yoyojacky/microduck-replica/tools/FeeTech_HD1910M_Servo/README.md

# HD1910M 舵机测试工具（feetech-HD1910M-tester）

基于 Rust 实现的飞特 HD1910M 串口舵机（FT-SCS 协议）测试工具，
覆盖官方内存表全部可读写寄存器：ID/波特率设置、位置/速度/电流三环 PID、
扭矩与力控、运行模式、保护参数、EPROM 锁存、实时监控等。

## 快速开始

```bash
cargo build
./target/debug/hd1910-tester scan      # 扫描舵机（带进度条）
./target/debug/hd1910-tester dump      # 读整张内存表
./target/debug/hd1910-tester monitor   # 实时监控反馈
./target/debug/hd1910-tester --help    # 全部命令
```

## 文档

完整的中文教学手册（协议讲解 + Rust 知识点 + 实验教程）见 **[TUTORIAL.md](TUTORIAL.md)**。

## 附带的两份飞特规格书

| 文件 | 是什么 | 跟鸭子的关系 |
|---|---|---|
| [`HD-1910-C001串型规格书20260907.pdf`](HD-1910-C001串型规格书20260907.pdf) | **本项目用的舵机**。4–8.4 V，减速比 1:320，堵转 15 kg·cm @7.4 V。过压保护阈值 10 V、欠压 4 V，所以 2S 电池满电 8.4 V 在范围内 | ✅ 整只鸭子 15 颗都是它 |
| [`HL-2915-C002串型规格书20260227.pdf`](HL-2915-C002串型规格书20260227.pdf) | 飞特另一款舵机。**9–14 V（3S 电池）**，22.5 g，减速比 1:320 | ⚠️ **本项目不用，仅供参考**。电压跟鸭子的 2S 电池不兼容，想换 3S 方案时可以对照看 |

两份都是飞特发的规格书原件，规格内容一字未改。**联系人的姓名和手机号/微信已抹掉**
（原件里印的是销售个人的联系方式，不适合挂在公开仓库）；HD-1910 那份用的是联系方式为公司座机的官方版本。
要联系飞特走官网 [www.feetech.cn](https://www.feetech.cn) 或公司电话 0755-89335266。

飞特的协议手册、内存表等官网公开资料在仓库的 [`docs/飞特资料/`](../../docs/飞特资料/)。

## 测试

```bash
cargo test    # 协议层/内存表层单元测试（无需硬件）
```
