yoyojacky/microduck-replica/hardware/imu_to_dxl/imu_to_dxl-接线表.md

# imu_to_dxl 接线表

> 手工连线用。器件位号与 `microduck-replica/BOM.md` 一致。
> 状态：方案稿，未经实物验证。

## 器件清单（含立创编号）

| 位号 | 器件 | 封装 | 立创编号 |
|---|---|---|---|
| U1 | STM32G031F8P6 | TSSOP-20 | C529334 |
| U2 | LSM6DSV16XTR | LGA-14 | C5267406 |
| U3 | SN74LVC2G241DCUR | VSSOP-8 | C10430 |
| U4 | HT7533-1（30V 输入，100mA） | SOT-89 | C14289 |
| F1 | PPTC MF-NSMF020X-2（24V / 200mA 保持） | 1206 | C210358 |
| D1 | TVS SMF12A | SOD-123FL | C2943870 |
| R1, R2, R4, R5 | 10kΩ | **0603** | C25804 |
| R6 | 150Ω | **0603** | C22808 |
| D2 | BZT52C5V1 5.1V 稳压管 | **SOD-123** | C151588 |
| C1–C4, C8 | 100nF 50V | **0603** | C14663 |
| C5 | 4.7µF / 16V X5R | 0603 | C19666 |
| C6 | 10µF / 25V X5R | 0805 | C15850 |
| C7 | 10µF / 10V | 0603 | C19702 |
| J1, J2 | B3B-EH-A（3P **2.5mm**，Dynamixel / 官方 HAT 线） | 直插 | C160259 |
| **J4, J5** | **B3B-PH-K-S（3P 2.0mm 立式，对口飞特 `AMP2.0-3P`）** | 直插 | 待定 |
| J3 | SWD+串口 6P 排针 PZ254V-11-06P | 直插 | C492405 |

## 网络表（23 个网络）

### VDD_BUS —— 舵机总线原压（2S 锂电 6.0–8.4V）
J1.2 · J2.2 · **J4.2** · **J5.2** · F1.1

> 四个座子的 `VDD_BUS` 走**直通铜皮**：`J1.2 → J2.2 → J5.2 → J4.2` 全程 0.76 mm。

### VDD_F —— 保险丝之后
F1.2 · D1 阴极 · C6.1 · C8.1 · U4.2 (Vin)

### +3V3
U4.3 (Vout) · C7.1 · U1.4 (VDD/VDDA) · C4.1 · C5.1 · R2.2 ·
U2.5 (Vdd_IO) · U2.8 (Vdd) · C1.1 · C2.1 · R1.2 ·
U3.8 (VCC) · C3.1 · J3.6 · **R7.2**

### GND
D1 阳极 · C6.2 · C8.2 · U4.1 (GND) · C7.2 ·
U1.5 (VSS/VSSA) · C4.2 · C5.2 ·
U2.2 (SDx) · U2.3 (SCx) · U2.6 (GND) · U2.7 (GND) · C1.2 · C2.2 ·
U3.4 (GND) · C3.2 · J1.1 · J2.1 · J3.1 · **J4.3** · **J5.3** · C9.2 · X1.2

### 复位
| 网络 | 连接点 |
|---|---|
| NRST | U1.6 (PF2-NRST) · R2.1 |

R2 另一端 (R2.2) 接 +3V3，构成 10k 上拉。

### 四个上拉电阻（R1/R2/R4/R5，另一端全部接 +3V3）

| 位号 | 拉住谁 | 为什么 |
|---|---|---|
| **R1** | `SPI_CS` | 上电与复位期间 PA4 高阻，CS 浮着可能被 IMU 误判成 I²C 模式，或把总线噪声当命令。**必须** |
| **R2** | `NRST` | 芯片内部已有 ~40 kΩ 弱上拉，外加 10 kΩ 提高抗干扰。加强项 |
| **R4** | `DE` | `1OE#` **低电平使能发送**。复位期间 PA1 高阻，此脚若浮成低电平，发送缓冲打开，本板会往总线上灌数据、与 15 个舵机撞车。**必须** |
| **R5** | `DXL_DATA` | 总线空闲无人驱动时，`2A` 这个 CMOS 输入浮空会有穿透电流，UART 也可能把噪声当起始位。本板自己定义空闲电平，不依赖主机 |

> R4 与 R5 是 2026-09-06 按社区评审意见补的。此前只在 CS 上做了上拉，
> **同样的道理没有推广到 DE，这是漏项**。

### IMU（SPI 四线 + 两路中断）
| 网络 | U1 (STM32) | U2 (LSM6DSV16X) | 其他 |
|---|---|---|---|
| SPI_CS | 11 · PA4 | 12 · CS | R1.1（R1.2 接 +3V3 上拉） |
| SPI_SCK  | 12 · PA5 | 13 · SCL | |
| SPI_MISO | 13 · PA6 | 1 · SDO/SA0 | |
| SPI_MOSI | 14 · PA7 | 14 · SDA | |
| IMU_INT1 | 7 · PA0  | 4 · INT1 | |
| IMU_INT2 | 15 · PB0/PA8 | 9 · INT2  | |

### 半双工总线（U3 = SN74LVC2G241 双缓冲）
| 网络 | 连接点 |
|---|---|
| MCU_TX | U1.9 (PA2 · USART2_TX) · U3.2 (1A) |
| MCU_RX | U1.10 (PA3 · USART2_RX) · U3.3 (2Y) |
| DE | U1.8 (PA1 · USART2_DE) · U3.1 (1OE#) · **R4.1** |
| DXL_DATA | U3.6 (1Y) · U3.5 (2A) · **R5.1** · **R6.1** —— 缓冲侧 |
| **DXL_BUS** | **R6.2** · **D2 阴极** · J1.3 · J2.3 · **J4.1** · **J5.1** —— 连接器侧 |
| **RX_EN** | **U1.1 (PB7/PB8)** · **U3.7 (2OE)** · **R7.1** —— 接收缓冲使能，2026-09-07 补 |

`U3.7 (2OE)` 原为直接接 +3V3，2026-09-07 改成 **`RX_EN` 网络**：经 **R7 10 kΩ 上拉到
+3V3**，同时引一根线到 **U1.1 (PB7/PB8)**。

**默认行为不变** —— MCU 复位期间 PB7 是高阻，R7 把 `2OE` 拉高，接收缓冲照常开着，
固件一行不写也跟改动前完全一样。这是**预留**：想关掉发送期间的回显时，把 PB7 配成
推挽输出拉低即可，同时打开 `MCU_RX` 脚的内部上拉，避免 `2Y` 高阻时 RX 浮空。

### 调试口 J3（6P，`PZ254V-11-06P` / `C492405`）

| 脚 | 网络 | 来源 |
|---|---|---|
| 1 | GND | |
| 2 | SWDCLK | U1.19 (PA14) |
| 3 | SWDIO | U1.18 (PA13) |
| 4 | **UART_RX** | **U1.17** `PA12[PA10]` → 重映射为 **PA10** = `USART1_RX`；接 USB-TTL TX（3.3V电平） |
| 5 | **UART_TX** | **U1.16** `PA11[PA9]` → 重映射为 **PA9** = `USART1_TX`；接 USB-TTL RX（3.3V电平） |
| 6 | +3V3 | 调试器 VTref 电压参考；不要接5V |

**2026-09-21 勘误：** 按本目录2026-09-08[原理图 PDF](imu_to_dxl-原理图.pdf)复核，
SWD接 **1、2、3、6** 脚；第4/5脚是串口。旧四针排线不能整排插到1–4脚，
不能把第4脚当作3.3V或VTref。连接前核对实板一脚标记和调试器接口定义。

脚 16/17 的重映射靠 `SYSCFG_CFGR1`（DS12992 Rev 3, Table 12 脚注 4）。

**为什么不上 USB**：STM32G031 **没有 USB 外设**（手册全文搜 USB 零命中，Development support
只写 "serial wire debug (SWD)"）。加 USB 要额外一颗 CH340/CP2102，45×22 mm 板上不划算。
调试用 SWD 就够：

| 方式 | 需要什么 | 说明 |
|---|---|---|
| **RTT**（推荐） | J3 的 1、2、3、6 脚 | `probe-rs` 支持 CMSIS-DAP 跑 RTT，直接读目标 RAM，**不停 CPU**，对 50 Hz 控制环无影响 |
| 串口 printf | J3 的 4/5 脚 + 任意 USB-TTL | 走 USART1 |
| 半主机 semihosting | 只用 J3 | 每次 printf 停 CPU，控制环会崩，**别用** |
| ~~SWO / ITM~~ | — | **Cortex-M0+ 没有**，M3 以上才有 |

### 舵机接口 —— 两套并存，⚠️ **脚序是相反的**

板上有四个舵机总线座子，两两一组，三根线一一并联（同一个电气节点），
**但两组的引脚顺序完全相反** —— 因为两家的线序本来就不同。

**`J1` / `J2` —— `B3B-EH-A`，2.5 mm，配 Dynamixel / 官方 HAT 线束**

| 脚 | 网络 |
|---|---|
| 1 | GND |
| 2 | VDD_BUS |
| 3 | **DXL_BUS** |

**`J4` / `J5` —— `B3B-PH-K-S`，2.0 mm，配飞特 HD-1910 线束**

| 脚 | 网络 |
|---|---|
| 1 | **DXL_BUS** |
| 2 | VDD_BUS |
| 3 | **GND** |

> ⚠️ **千万别照着 `J1` 复制网络给 `J4`。** 飞特《HD-1910-C001 串型规格书》A/0
> 第 3/7 页 6-7 项写明线端是 `1=Signal / 2=Vcc / 3=GND`，与 Dynamixel 侧头尾颠倒。
> 好在 **2.0 mm 与 2.5 mm 插不进对方**，物理上杜绝了插错，只剩「画错」这一种可能。
> 四个座子的脚序已于 2026-09-08 从 PCB 网表反读复核，全部落对。
>
> 另注意 **`AMP2.0` 是 2.0 mm、`JST EH` 是 2.5 mm**，飞特线插不进 `J1`/`J2`，
> ⚠️ 首板实测（2026-09-17）：`B3B-PH-K-S` 的**外壳**跟飞特插头不配，插不进去；削掉外壳只留针能用。v2 换成跟飞特线实配的座子。
> 反之亦然 —— 用哪套舵机就插哪一组。

> 📌 **脚 3 此前本表误记为 `DXL_DATA`**。2026-09-06 补入 `R6` 150 Ω 串阻后，
> 缓冲侧（`DXL_DATA`）与连接器侧（`DXL_BUS`）已是两个网络，连接器上是 `DXL_BUS`。
> 2026-09-08 更正。

## 悬空脚

- U1：**3 (PC15-OSC32_OUT)、20 (PB3/PB4/PB5/PB6)**
  - 3 脚已引到焊盘，与 2 脚一起构成有源晶振预留位（默认不贴），见下方「时钟」
  - 20 脚是唯一完全空闲的 GPIO（并了 PB3/PB4/PB5/PB6 四个口，最灵活），留作后用
  - 1 脚 (PB7/PB8) 原本空闲，2026-09-07 起用作 `RX_EN`
  - 2 脚 (PC14-OSC32_IN) 接 `OSC_IN`、16/17 脚 (PA9/PA10) 接 `UART_TX`/`UART_RX`
    —— 此前本表误列为悬空，2026-09-07 更正
- U2：10 (OCS_Aux)、11 (SDO_Aux) —— 辅助 SPI 不用，ST DS13510 允许悬空；保守做法是 OCS_Aux 接 Vdd_IO

**U2.2 (SDx) 与 U2.3 (SCx) 必须接地**，不可悬空 —— ST DS13510 Rev 1, Table 1。

## 时钟：用内部 HSI16，晶振位预留不贴

**这个封装接不了无源晶振。** DS12992 Rev 3, Table 12 (p.36)：TSSOP20 的 2 脚
(`PC14-OSC32_IN`) 附加功能含 `OSC_IN`，但 3 脚 (`PC15-OSC32_OUT`) 只有 `OSC32_OUT`、
**没有 `OSC_OUT`**；`PF0`/`PF1` 在这个封装根本没引出来。无源晶振要两个脚才能起振。

| 方案 | 可行性 |
|---|---|
| 无源高速晶振 | ❌ 缺 `OSC_OUT` |
| 有源晶振走 HSE 旁路（灌进 2 脚，3 脚可作 `OSC_EN`） | ✅ |
| 32.768 kHz LSE 无源晶振 | ✅ 但不能给 PLL 供时钟，只能校准 HSI16 |

HSI16 精度（Table 41, p.64）：出厂 −0.75%/+0.5%，0–85 °C 温漂 ±1%，电压漂移 ±0.1%
→ 最坏约 **−1.85% / +1.55%**。1 Mbps UART 典型容差 ±3%，够用但余量不多。

**做法**：2、3 脚引到焊盘，留一个 3225 有源晶振位 + 去耦位。最初默认不贴，2026-09-08 起 X1 / R3 / C9 改为默认贴片；
固件先用 HSI16，实测 1 Mbps 有误码再启用 HSE 旁路。
注意：图里 X1 的 `Tri-state` 使能脚是**固定接 3.3 V** 的，上面说的「3 脚（PC15）可作 `OSC_EN`」没有画进去，PC15 空着。首板要 MCU 控晶振就飞线 PC15 → X1.1；见 README「评审记录 · 2026-09-16」。

## 使能极性说明

`1OE#` 低电平使能发送缓冲，`2OE` 接高电平使接收缓冲常开。

- PA1 是 USART2 的硬件 DE 脚，配置 `CR3.DEP = 1`（DE 低有效），收发切换由硬件完成
- 接收常开意味着发送时会在 RX 上收到自己的回显，固件按发送长度丢弃即可
- 备选方案是 `2OE` 也接 DE（发送时关掉接收缓冲），但那样发送期间 MCU 的 RX 脚悬空，重新使能时可能产生假起始位，不推荐
- **2026-09-07 改进**：`2OE` 不再硬接 +3V3，而是经 R7 10 kΩ 上拉、同时引到 `U1.1 (PB7/PB8)`。
  默认仍是常开（行为不变），但固件多了一个选项 —— 想关接收时拉低 PB7，并打开 MCU RX 脚的
  内部上拉解决浮空。比接 DE 更灵活：关不关、何时关，由固件自己定

## HD-1910-C001 实参（飞特官方产品页，预售期）

飞特为小鸭子专门做的一颗，页面标题即「**开源小鸭舵机** —— 串行总线舵机，专为小鸭子 AI 玩偶定制开发」。
舵机本体标注：**「三针接口 · TTL串行总线」**。

| 项 | 值 |
|---|---|
| 电压范围 | **5 V – 8.4 V** |
| 堵转扭力 | **10 kg·cm = 0.98 N·m** |
| 额定负载 | **3.0 kg·cm = 0.294 N·m** |
| 空载速度 | 0.09 s/60°（110 RPM） |
| **静态电流** | **21 mA** |
| **空载电流** | **140 mA** |
| **额定电流** | **500 mA** |
| **堵转电流** | **1.8 A** |
| 外观尺寸 | 34 × 20 × 23 mm |
| 重量 | 22.5 ± 2 g |
| 外壳 | PA + Fiber |

尺寸与 XL330（20×34×26 mm）同档，机械上近似可替换；扭矩比 XL330-M288（0.52 N·m）强近一倍。

> ⚠️ 别把 `HL-2915-C002` 规格书里的电气参数套到这颗上 —— 那是 12 V（9–14 V）机型。
> 可通用的只有连接器定义与协议部分。

### ⚠️ J1↔J2 直通路径的过流

J1 / J2 三根线一一并联，**本板若挂在链条中间，下游全部舵机电流都流经本板的连接器与铜箔**：

| 工况 | 单个 | ×15 |
|---|---|---|
| 静态 | 21 mA | 0.3 A |
| 空载转动 | 140 mA | 2.1 A |
| **额定负载** | **500 mA** | **7.5 A** |
| 堵转 | 1.8 A | 27 A |

而 **JST EH 额定电流仅 3 A**。

> F1（200 mA PPTC）**不受影响** —— 它只串在本板自取电那一路
> （`VDD_BUS → F1 → VDD_F → U4`），不在 J1→J2 直通路径上。

**二选一：**

1. **把本板挂在链条末端**（叶子节点），只用 J1，J2 空置或只接 1 个舵机 —— 流经本板的仅约 12 mA。**推荐**
2. 若必须置于链中，PCB 上 `VDD_BUS` 与 `GND` 从 J1 到 J2 走**大铜皮**（≥ 2 mm 或直接铺铜），
   并核算下游舵机数量不超过 3 A

## 飞特接口定义（官方规格书确认）

**来源**：飞特《HL-2915-C002 串型规格书》A/0，2026-02-27，第 4 页 6-7 项。

```
6-7  连接器和电缆 Connector and Cable
     类型 Type        AMP-3
     材质 Material    PP
     线长 Length      15CM / 25CM
     引脚定义         1  GND
     Pin Definition   2  Vcc
                      3  Signal/TTL
```

**`1=GND / 2=Vcc / 3=Signal`，与 Dynamixel 完全一致 → J1/J2 现有接法正确。**

关联证据：`HD-1910-C001.stp` 装配体里连接器零件名是 **`AMP-3P`**，且该装配体包含
`HL-2915-C002-20260409_ASM` —— 两款共用平台，接口定义通用。

### 同一份规格书里其它可用条目

| 项 | 值 | 意义 |
|---|---|---|
| 7-2 协议类型 | Half Duplex Asynchronous，**8bit / 1stop / No Parity** | 与本板一致 |
| 7-4 波特率 | 38400 ~ 1 Mbps，**出厂默认 1 Mbps** | 与 Dynamixel 同速 |
| 7-3 ID 范围 | 0–253，**出厂默认 ID 1** | 15 个舵机需逐个改 ID；本板用 200 不冲突 |
| 12 **信号高电平** | **2 V ~ 5 V** | 见下 |
| 12 信号低电平 | 0.0 V ~ 0.45 V | |
| 6-6 角度传感器 | 12 Bits 磁编码 | 磁编码 ⇒ **小端字节序** |

**信号电平两个方向都要看**：

1. 本板驱动总线 —— `SN74LVC2G241` 在 3.3 V 供电下输出约 3.3 V，落在舵机要求的 2–5 V 高电平窗口内 ✅
2. 舵机驱动总线 —— 它可能输出到 **5 V**；74LVC 在 3.3 V 供电时**输入耐 5.5 V** ✅
   （选 LVC 而非 LV/HC 正好卡住这条）

> ⚠️ 该规格书是 **HL-2915-C002（12 V，9–14 V）**，不是 HD-1910（5–8.4 V）。
> **电气参数不可混用** —— 供电范围、堵转电流、过压保护阈值都不同。
> 通用的只是**连接器定义与协议**部分。

### 背景：飞特不同系列的物理层不一样

官方各系列内存表手册（<http://doc.feetech.cn>，接口 `getQr/{q}`）原文：

| 系列 | 电平 | 默认波特率 |
|---|---|---|
| **STS**（磁编码） | **TTL 单总线** | **1M** |
| SCS（电位器） | TTL 单总线 | 1M / 500k |
| SMS（磁编码） | **RS485** | 115200 |
| HLS（磁编码） | 未注明 | 1M |
| SHC | CANopen | 125k |

「飞特 = TTL 单线」**只对 STS/SCS/HL 这一支成立**，SMS 是 RS485。换系列前先查它的手册。

## 协议自动识别（不用跳线、不用拨码）

两家包头天然可分，判别点是**第 3、4 字节**：

| | 包头 | 后续 | 校验 |
|---|---|---|---|
| Dynamixel V2 | `FF FF` | **`FD 00`** | CRC-16（poly 0x8005） |
| 飞特 STS/SCS | `FF FF` | `ID` + `LENGTH` | `~(ID+LENGTH+INST+参数)` |

无歧义：飞特包第 3 字节是 ID（可以是 0xFD），但**第 4 字节 LENGTH 永远不会是 0**
（最小为 2 = 指令 + 校验和）。所以 `FF FF FD 00` 只可能是 V2。

```
状态：未知 / 已锁 V1 / 已锁 V2

未知时，收到 FF FF 开头的包：
    if 字节[2]==0xFD && 字节[3]==0x00:
        按 V2 拆，算 CRC-16 → 过了记一票 V2
    else:
        按 V1 拆，算 ~sum   → 过了记一票 V1
    连续 3 票一致 → 锁定

锁定后：只按锁定协议解析，回复也用同一种
兜底：连续 100 包全解析失败 → 解锁重新识别
```

以下均以**飞特官方《舵机SCS通信协议》原文**为准：

- 帧格式：**1 起始位 + 8 数据位 + 无校验 + 1 停止位**，共 10 位
- 字头：连续两个 `0xFF`
- ID 范围 **0～253**（`0x00`～`0xFD`），**广播 ID = 254（`0xFE`）**
- 数据长度 **Length = 参数个数 N + 2**，所以**最小为 2，永远不会是 0** ← 判别无歧义的依据
- 校验和 = `~(ID + Length + Instruction + Param1 + … + ParamN)`，超 255 取低字节
- 同步读 `0x82`、同步写 `0x83`、PING `0x01`、读 `0x02`、写 `0x03`
- ⚠️ **多字节参数的字节序按舵机类型分**：「电位器类型舵机为**大端**（高字节在前），磁编码类型舵机为**小端**（低字节在前）」

三个要点：

1. **必须锁定，不能逐包判** —— 总线有噪声，某包被干扰成 `FD 00` 的样子会导致来回横跳
2. **回复用同一协议** —— 不只解析要分支，组包也要
3. **兜底解锁** —— 换舵机品牌时不必重烧固件

从机 ID 两边都用 **200**，与 15 个舵机（通常编 1–15）不冲突。

> 飞特 STS 的 `Return Delay Time` 默认 0，且手册标注 "Not functional on STS" ——
> 寄存器不生效，回复延迟完全由固件决定。

## 封装口径：阻容一律 0603

所有阻容用 **0603**，D2 用 **SOD-123**，不用 0402/SOD-323。

理由不是手焊 —— 板上有 LGA-14 的 LSM6DSV16X，本来就得上热风。
**真正的理由是调试期返修**：串阻从 150 Ω 试到 33 Ω、摘掉某个上拉、补一颗去耦，
0603 拿烙铁几秒就能改。第一版没验证过的板子必然要改几次。

代价：11 个器件多占约 16 mm²，不到板面积 2%。而且 0603 这几个值全在立创**基础库**
（10 kΩ `C25804` · 150 Ω `C22808` · 33 Ω `C23140` · 100 nF `C14663`），比 0402 的扩展库还省上料费。

> C6（10 µF/25 V）保持 0805；C5（4.7 µF）、C7（10 µF）本来就是 0603。

## 数据线保护（照 HAT 的做法）

```
U3.6 (1Y) ──┬─ DXL_DATA ─┬── R5 10k → 3.3V
U3.5 (2A) ──┘            │
                         └── R6 150Ω ──┬── DXL_BUS ── J1.3 / J2.3
                                       │
                                    D2 5V1
                                       ⏚
```

| 器件 | 作用 |
|---|---|
| **R6 150 Ω** | 源端串阻。限制短路电流、软化边沿降 EMI。1 Mbps 下延迟约占比特时间 3% |
| **D2 5V1** | 钳位。阴极接 `DXL_BUS`、阳极接地 |

**上拉留在缓冲侧**（R5 在 R6 之前）：这样即使不插总线，`U3.5 (2A)` 这个 CMOS 输入
也有确定电平，不会浮空。与 HAT 的 `R32` 位置一致。

> 官方 HAT 用的是 `R33 150R + TH1 100R` 串联共 250 Ω，外加 `D4 5V1` 钳位
> （`dynamixel.kicad_sch`）。**D2 与 HAT 的 D4 同型号、不同封装** —— HAT 是 SOD-323（`C151348`），本板用 SOD-123（`C151588`）便于返修。
> 本板只用 150 Ω，因为 HAT 侧已有 250 Ω，总线上串太多会拖慢边沿。

## 三道过压防线

1. **F1** PPTC 200mA 保持 / 24V —— 限流，防短路
2. **D1** TVS SMF12A —— 钳位，防舵机反电动势尖峰
3. **U4** HT7533-1 耐压 30V —— 即使前两道失效，LDO 本身扛得住

## 布局要点

- 2 层板，45 × 22mm，贴片件全在正面
- 3 个连接器（J1/J2/J3）排在同一条边，插件
- 两个 M2 安装孔，间距 34mm（与原版 `banana_pcb_locker` 兼容）
- C1/C2 紧贴 U2 的 Vdd / Vdd_IO 脚，走线尽量短
- C4（100nF）与 C5（4.7µF）紧贴 U1 的 4 脚 —— ST DS12992 Fig.13 要求"尽可能贴近引脚，或放在 PCB 背面正对该脚"
- DXL_DATA 走线加粗，远离 SPI
