yoyojacky/microduck-replica/docs/HD1910-20261013-夜-掉电-舵机D与蹭地.md

# 2026-10-13 夜 ～ 10-14 凌晨 · 新卡上机、整机掉电、舵机 D 与颤、蹭地分析

**机器**：第一台（飞特 HD-1910 ×15，Radxa Zero 3W 2G 无 eMMC + microSD，官方 HAT C1 版，BNO085 走 I²C）。供电是 8.2 V 可调电源。
**两张卡**：
- **旧卡**：我们自己做的 Armbian，跑 kissqy 的 R17（v146）加我们的 I²C IMU 补丁，10-12 夜就是用它走起来的；
- **新卡**：kissqy 的一键镜像 R1（V164）加我们的 IMU 补丁（`microduck-zero3w-0.15.1-R1-V112-imu.img`）。

**走路模型**：kissqy 的「行走＋倒地联合 9600 轮」（§5～§7 的数据都是旧卡跑的）。
**前情**：[10-12 夜上机记录](HD1910-20261012-夜-IMU校准与首次迈步.md)，IMU 校准后能站、能交替迈步，但走路发颤、蹭地。

**一句话结论**：
1. **整机掉电是供电问题，不是软件**：新卡、旧卡都掉过，录像和日志同时中断、没有关机过程；新卡那次舵机端最后读到约 3.9 V。
2. **走路发颤跟舵机的 D（硬件阻尼）有关**：训练用的舵机模型里没有 D 这一项，真机却带着 D=20 或 D=40。D 改成 0 之后，机身晃动里的高频颤从 51% 降到 4～8%。我们现在用的是 **P3 / D0 / 转矩限制 700**。
3. **蹭地是两只脚都只抬了仿真的一半**：撑地的膝盖伸不直，模型要伸，真机一直弯着。左脚看起来更蹭，是因为它迈步时脚尖朝下；这一点和「右腿撑地时机身多往前栽」都是 **D 改成 0 以后才出现的**（D=20 时没有）。IMU 横滚零点补过了；关节零位在前后方向左右一致，左右方向（横滚）两只脚算出来差约 1.6°～2.6°，原因还没查（§6）。**补充（10-14 白天）**：左右不共面查了，差别来自两个髋横滚往外劈，每次不一样，像是被体重压的（推测）；仿真对齐真机的动作缩放、滤波，重量按 kissqy 训练模型估以后，撑地膝盖已经接近真机（那组仿真会颤）。见 [10-14 白天记录](HD1910-20261014-白天-仿真找原因与新版放开参数.md)。

| | 现在的状态 |
|---|---|
| 用哪张卡 | 旧卡（R17 能设 P/D/转矩）；新卡留着，等供电解决再用 |
| 舵机参数 | P3 / D0 / 转矩限制 700（中控「高级参数」里设，下次 HOME 生效） |
| IMU | 10-12 补了前倾 8.54°、右倾 1.78°；10-14 横滚往回补 1.14°（§6） |
| 走路 | 步频 2.8～2.9 Hz（仿真 3.2 Hz）；机身横滚晃动 30～36°/s，跟仿真 31°/s 一样；没有高频颤 |
| 还没解决 | 蹭地（两脚离地 3～6 mm，仿真 11～12 mm）；供电（10 A 电源 10-16 到） |

---

## 0. 问题一览

| # | 现象 | 根因 | 处理 | 详见 |
|---|---|---|---|---|
| 1 | 新卡 G50 Pro 配对成功，几秒后就被断开 | 这张卡开机时蓝牙「不可绑定」，配对回 No Bonding，BlueZ 默认 `ClassicBondedOnly=true` 拒收没绑定的 HID 设备；官方 setup-board 设的 `UserspaceHID=false` 有没有参与，没验证 | 配对前 `btmgmt bondable on`，配完立刻 connect；当时还改了 `UserspaceHID=true`、`ClassicBondedOnly=false`。几项一起改，只成功过一次 | §1.2 |
| 2 | 新旧卡都会在走路、站起时整机掉电 | 供电撑不住舵机的电流冲击（新卡那次舵机端最后读到约 3.9 V） | 电池或 10 A 电源、粗短线、输入端并大电容 | §2 |
| 3 | 在 `robotd.toml` 里改缩放、滤波，前后对比白做 | 联合模型用它自己包里的 `deployment-execution.json`，toml 里的这几个值对它不生效 | 改联合模型的执行参数（§4.1） | §4 |
| 4 | 新卡中控里改 P/D/转矩限制，没有效果 | V164 只写 P（模型包里约定的 P=5，kissqy 叫「部署合同」），D 和转矩限制留在舵机出厂值（D=40、1000），R17 的测试参数功能被删了 | 用旧卡；或者每次上电后写舵机 RAM（§4.2）；10-14 在本地给 V164 补回了（未上机，[10-14 §8](HD1910-20261014-白天-仿真找原因与新版放开参数.md#8-新版v164放开-p--d--转矩限制和头腿滤波本地未上机)） | §4 |
| 5 | 走路发颤、4 Hz 小碎步、节奏乱 | 跟舵机硬件 D 有关（训练用的舵机模型里没有 D）；D=0 后颤明显减少，机理没证实 | D=0，P3（代价见 §7） | §5 |
| 6 | 机身一直往左歪约 2° | 一部分是 P3 太软、站着时腿被压；另一部分是 IMU 横滚零点偏约 1.1° | IMU 横滚往回补 1.14° | §6 |
| 7 | 走路蹭地，左脚尤其明显 | 撑地膝盖伸不直，两脚都只抬了仿真一半；D=0 以后左脚迈步时脚尖朝下 | 待查，先试中间的 D（§7.5）；10-14 的仿真对照见 [10-14 §2](HD1910-20261014-白天-仿真找原因与新版放开参数.md#2-对齐条件以后撑地膝盖接近了但仿真多出了颤) | §7 |

---

## 1. 新卡上机

### 1.1 开机、配网

- V1.12 主板换成瑞莎的引导以后，**真机开机成功**（做法见 [kissqy 镜像 R1 分析](HD1910-20261012-kissqy镜像R1分析.md)）。
- 第一次开机，鸭子自己开热点。用电脑无线网卡连上热点，打开配网页填家里的 WiFi。**配网页要求登录密码至少 12 位**，短了会被拒。
- 新卡用 NetworkManager 管 WiFi（旧卡是 wpa_supplicant），登录用户是 `radxa`。

### 1.2 G50 Pro 配对上又被断开

**现象**：手柄拨 S 档，`bluetoothctl pair` 显示成功，几秒后就断开，padd 读不到手柄。旧卡上同一个手柄没问题。

**原因**（没有拆开逐项验证）：
1. 我们这张卡开机时蓝牙是「不可绑定」（bondable off，为什么没查清），手柄配对回的是 **No Bonding**，密钥存不下；BlueZ 的 `ClassicBondedOnly=true`（默认值）只接受已绑定的 HID 设备，于是连上就被拒；
2. 官方 `scripts/setup-board.sh` **有意**把 `/etc/bluetooth/input.conf` 里的 `UserspaceHID` 设成 `false`：Pro Controller 每秒发约 200 包，经 bluetoothd（蓝牙后台服务）转一道要吃掉一个核约 16% 的 CPU，改走内核后是 0（官方实测，配对和重连都不受影响）。kissqy 的镜像沿用了这一步。它在这次问题里有没有参与，**没验证**。

**做法**：
- `/etc/bluetooth/input.conf`：`UserspaceHID=true`、`ClassicBondedOnly=false`（原件备份成 `.bak-20261013`），重启 bluetooth。**这两项和 bondable 是一起改的，哪一项是必需的没拆开试**。按官方的测量，`UserspaceHID=true` 会让 bluetoothd 多吃约 16% 的 CPU，主板本来就热，下次应先试「只开 bondable、保留官方的 `UserspaceHID=false`」；
- 配对顺序：`btmgmt bondable on` → `bluetoothctl pair <MAC>` → `trust <MAC>` → **马上** `connect <MAC>`。成功后能看到 `Nintendo Switch Pro Controller` 和 `hid_nintendo` 驱动；
- 我们用 duck-quiet 把 kissqy 的 `configd` 关着，重新配对前要先 `systemctl start configd`。

新卡上按这个流程配上过一次（之后就碰到了 §1.3 的 WiFi 掉线和 §2 的掉电）。后来又重配了两次没配上，原因没查完就换回了旧卡，**这条流程还要在新卡上再完整走一次**。

### 1.3 其他改动（都能撤销）

| 改了什么 | 为什么 |
|---|---|
| WiFi 改连 5G，NetworkManager 里两个 WiFi 连接配置都关掉 PMF（受保护的管理帧） | 新卡上手柄连上约 10 秒后 WiFi 掉线（`ssid-not-found`，信号 −19 dBm，不是信号弱）。旧卡的 WiFi 设置就是关 PMF。改完没有单独复测 |
| 看门狗 15 秒、`kernel.panic=5`、`panic_on_oops=1` | 万一系统卡死，15 秒左右自己重启，不用拔电；重启后看 `/sys/fs/pstore` 有没有内核死机日志 |
| 黑匣子：`duck-rec`（50 Hz 状态＋每 0.5 秒电压温度）、`duck-journal`（系统日志实时抄到卡上） | Armbian 的日志在内存里，一掉电就没了。改成每秒写盘一次，文件名带开机编号（主板没有 RTC，时钟每次开机都会回拨，按时间找不到文件）。脚本见 [`tools/radxa/onboard-analysis/`](../tools/radxa/onboard-analysis/) |

---

## 2. 整机掉电：是供电，不是软件

**现象**：走路或站起来时，整只鸭子突然断电重启。录像、系统日志、健康记录在同一时刻中断，**没有任何关机过程**。新卡、旧卡都出现过：
- 新卡（P5 / D40 / 转矩 1000，V164，开着声音，联合缩放 1.0）：模型接管后走了 13 秒掉电，最后一刻舵机读到约 **3.9 V**；
- 旧卡（P5 / D20 / 转矩 1000）：模型接管 42 秒，中间摔倒、自己起身一次（日志 `LB recovery started`），起身后约 11 秒断电，断电时摇杆是 0。健康记录最后一个点是 7.33 V（每 0.5 秒才一个点，跌落那一下没录到）。

**原因**：舵机一起发力时的电流冲击，电源和线撑不住，电压塌下去。主板的 5 V 是 HAT 从同一路电降压出来的，跟着掉电。D 越大，模型纠正越频繁，电流冲击可能越多；新卡掉得更快**可能**跟 D=40 有关，但这只是一次对一次，新卡还同时开着声音（功放也吃这路电），下不了结论。

**电压的另外几个数**：10-13 下午那次开机（`bc840bb`），上力站着中位 7.45 V、走路 7.39 V，连站着都只有 7.45 V（电源设 8.2 V），原因没查；之后几次开机站着、走路都在 7.9～8.1 V，10-14 凌晨走路中位 8.00 V、最低 7.93 V。robotd 报的电压每 0.5～1 秒才一个点，还做了平滑，几十毫秒的瞬间跌落看不到。

**怎么办**：
- 用电池（放电倍率够的航模电池，充满），或者大电流电源（我们的 10 A 电源 10-16 到）；
- 线用 16～18 AWG 硅胶线，尽量短，接头用 XT30 / XT60，不用鳄鱼夹；
- 鸭子电源输入端并一个 1000～2200 µF 的电解电容；
- 想分清是「主电源塌了」还是「HAT 给主板供电那一路太弱」：主板的 USB-C 另接一个充电宝单独供电再走（HAT 上有 LM5050 理想二极管，按设计允许这样接）。有示波器的话，下降沿触发，同时看 BATT_IN、5V_PRE_IDEAL、主板 5V 三个点。

**更正一件事**：kissqy 仓库里曾有一段「走几步 ZERO 会重启，疑 HAT 上 LM5050 的 VS 供电余量不足」，**他 10-12 已经删掉了**，提交说明是「作者更正，早先测试不准确」。别把它当成 kissqy 的结论。我们 C1 版 HAT 的 BOM 确实是同一套（R8 100Ω、U10 LM5050-1、U9 AP63205），但我们这次的证据指向主电源。

---

## 3. 新旧卡比一比

新卡掉电以后，我们用只读的 ext4 读取器（电脑上管理员运行，`wsl --mount` 挂不上 USB 读卡器）把旧卡读出来，逐项对比：

| | 旧卡 | 新卡 |
|---|---|---|
| 内核、设备树、aic8800 WiFi/蓝牙驱动和固件 | 99 个文件完全一样 | ← |
| bluez、wpa_supplicant 版本 | 一样 | ← |
| WiFi 管理 | wpa_supplicant，2.4G 优先、PMF 关、`country=CN`、静态 IP | NetworkManager |
| 设备树 overlay | — | 比旧卡多了 i2c3-pihat、aic3104（声卡）、摄像头、NPU |
| robotd / padd | kissqy R17 | kissqy V164 |
| 舵机参数 | 中控能设 P / D / 转矩限制 | 只写 P=5（§4.2） |
| 声音 | 关 | 开（`[audio] enabled = true`），HAT 上的功放和舵机用同一路电 |

所以掉电跟卡无关（两张卡都掉）。G50 Pro 只记得最后配对的那张卡，**换卡要重新配对**。走路表现不同，主要是 robotd 版本不同、舵机 D 不同。

---

## 4. 参数到底在哪生效（今晚最大的坑）

### 4.1 联合模型的缩放和滤波：在模型包里，不在 robotd.toml

**现象**：我们在 `robotd.toml` 里把 `action_scale` 改成 1.0、0.8，头腿滤波改成 0.5、1.0，跑了几组对比。后来发现这几组对比**都白做了**，当时得出的结论也是错的，已经更正。

**原因**：kissqy 的联合模型（`scale_use = joint_uniform`）带着自己的 `deployment-execution.json`。R17 装的版本是缩放 0.9、头滤波 0.5、腿滤波 0.7（kissqy 10-12 之后发布的 V164 里，同一个模型写的是缩放 1.0、头 0.5、腿 0.7），robotd 再乘一个电压补偿（约 7.4 / 电压，8 V 时约 0.92）。**toml 里的 `action_scale` 和滤波对联合模型不生效**，只对其他模型生效。

**怎么确认生效**：看 robotd 的 `robot.busStatus` → `loaded_models.walk.runtime_execution_profile`，那里是 robotd 实际在用的值。中控「高级参数」页「联合基础缩放 0.90」那一格也是从这里读的。

**要改的话**：改模型目录里那个 `deployment-execution.json` 的三个数，卸力后重启 robotd。我们在本地给 kissqy 中控加了「联合缩放 / 头部滤波 / 腿部滤波」三个输入框，能做这件事（§8），还没发布。补充（10-14）：后来改在 V164 上做，见 [10-14 白天记录 §8](HD1910-20261014-白天-仿真找原因与新版放开参数.md#8-新版v164放开-p--d--转矩限制和头腿滤波本地未上机)。

### 4.2 舵机的 P / D / 转矩限制：R17 能设，V164 不能

先看舵机本身。HD-1910 出厂 EEPROM 里是 **P=32、D=40、I=0**，转矩限制 1000，加速度 0。读法：robotd 的 `robot.busStatus` → `native.hd1910.registers_before_arm`。

| | 上力时写什么 | 中控「高级参数」的 P / D / 转矩框 |
|---|---|---|
| R17（旧卡） | 默认写 P=5、D=20；`/etc/robot/feetech-ft5/servo-test-parameters.json` 里有值就用它 | **生效**，下次 HOME 上力时写入 |
| V164（新卡） | 只写 P（模型合同里的 `kp_fw=5`），**D 和转矩限制不写**，留在出厂的 D=40、1000 | **不生效**。kissqy 的说明里写了「48–49 号转矩限制、51 号 D 不显式写入」，R17 的测试参数分支也删了 |

**补充（10-14 晚）**：kissqy 10-14 发布 V167 / control.43（中控 1.0.167），说明是「修复鸭身抖动」：每次 HOME 上力，把 15 颗舵机 RAM 里的 D 写成 0、转矩限制写成 1000，P 仍用模型里的 5；这两个值是固定的，中控里调不了；卸力时只恢复 P，D 留在 0，直到舵机断电。跟本页 §5 的结论一致。

**新卡上的临时办法**：robotd 停掉、15 颗卸力后，直接写舵机 **RAM** 里的 D（51 号）和转矩限制（48 号）。RAM 断电就恢复，EEPROM 不动。我们用一个小脚本写成了 D=0、转矩 681。注意：**手柄十字键右（重启舵机）也会把 RAM 恢复成出厂值**。长期要么把这个设置补回 V164，要么把 15 颗舵机 EEPROM 里的 D 改成 0（只对不写 D 的 V164 有效；R17 上力时会写自己的 D，要配合测试参数里的 kd）。**补充（10-14）**：补回 V164 的代码已在本地写好（P / D / 转矩限制和头腿滤波都能在中控里设，未上机、不公开），见 [10-14 白天记录 §8](HD1910-20261014-白天-仿真找原因与新版放开参数.md#8-新版v164放开-p--d--转矩限制和头腿滤波本地未上机)。

---

## 5. 走路发颤：跟舵机的 D 有关

### 5.1 怎么找到的

1. 训练用的舵机模型（BAM：舵机的物理模型，含电机和各种摩擦；参数是陆吾公开的 1910 M6，就是这款舵机；`kp_fw=5` 指舵机固件里的 P=5）**没有硬件 D 这一项**（kissqy 的审计文档也这么写）；真机却是 D=20（R17）或 D=40（V164）。D 是舵机里的微分项，起阻尼作用，动得越快阻得越狠；
2. 用走路数据算「目标 → 实际」的跟随（Welch 互谱：把模型每拍给的目标当输入、舵机实际角度当输出，算每个频率上能跟到几成）。P5 / D20 那段录像（`run-20261013-135146-b3409a0`）在步频附近 3～4 Hz：髋、膝跟到 0.33～0.46，跟仿真的 0.41～0.48 差不多；明显差的只有踝（0.36～0.39，仿真 0.69）。另一段只有 21 秒的录像（`132505-b70520d`）算出来是 0.26～0.45；
3. **假设**：模型以为腿是灵活的，真机的阻尼吃掉一部分纠正动作，模型只好更快、更用力地反复纠正，于是出现 4 Hz 的小碎步加颤。但 D 改成 0 以后（P5 / D0 / 850），髋横滚跟随 0.27～0.28、膝 0.35～0.36，并没有变好，只有踝升到 0.53。**这个机理没被数据证实**。

能确定的是下面这张表里的实测结果：D 改成 0，颤明显减少。

### 5.2 几组参数对比（每组走 8～42 秒）

同一只鸭子、旧卡、联合模型、联合缩放 0.9 不变。脚本 [`tools/gait-analysis/`](../tools/gait-analysis/) 的 `gait_quality.py`（步频、晃动）和 `foot_clear.py`（离地间隙，§7）：

| 组 | 走了 | 步频 | 机身横滚晃动 | 其中 >4 Hz（颤） | 平均左右倾 | 迈步离地间隙 左 / 右 |
|---|---|---|---|---|---|---|
| 仿真（训练用舵机模型，P5） | 19.8 s | 3.22 Hz | 31°/s | 14% | −1.1° | 11.4 / 11.8 mm |
| P5 / D20 / 1000 | 42.3 s | 2.89 Hz，节奏乱 | 33°/s | **51%** | −1.9° | 6.9 / 6.5 mm\* |
| P5 / D0 / 850 | 13.0 s | 3.47 Hz | **56°/s** | 6% | −1.5° | 5.5 / 8.5 mm\* |
| P3 / D0 / 681 | 22.8 s | 2.91 Hz | **30°/s** | 8% | −2.4° | 2.2 / 6.5 mm\* |
| P3 / D0 / 681（第二次） | 8.2 s | 2.80 Hz | 36°/s | 4% | −1.8° | 3.1 / 5.9 mm\* |
| P4 / D0 / 681，IMU 已补左右 | 12.0 s | 3.01 Hz | 44°/s | 6% | −0.8° | 4.8 / 5.8 mm |

\* IMU 横滚补偿（§6）之前录的。那时 IMU 多读了约 1.1° 左倾，换算到地面时左脚被算低约 2 mm：左脚的数偏小、右脚的数偏大，大约各 2 mm；左右分段也有偏差（算成左腿撑地的时间偏多）。P4 那组最干净。

**注意这不是严格的「一次只改一样」**：P5 / D20 / 1000 → P5 / D0 / 850 同时改了 D 和转矩限制；P5 那组转矩是 850，P3、P4 是 681；P4 那组还同时补了 IMU。

**读法**：
- D=20 时，机身晃动里一半是 4 Hz 以上的颤；**D 改成 0（同时转矩 1000 → 850），颤从 51% 降到 4～8%**；
- D=0 以后，P 越大晃得越厉害：P5 晃 56°/s，P4 晃 44°/s，P3 晃 30°/s，跟仿真一样（转矩限制和 IMU 不完全相同，见上）；
- 我们的手感也是 P3 最稳。kissqy 中控的默认值也正好是 P3 / D0 / 681；
- 代价是 P 越小，离地越低（§7）；
- **D=20 也有好处**：撑地时右膝能伸到 +1.6°（D=0 时是 −2.6°～−5.3°），机身也不前后点头（§7.3、§7.4）。所以 D=0 不一定最好，中间值 D=5～10 值得试。

**转矩限制 681 会不会削掉动作**：仿真里走路时，两个膝盖分别有 3.4% 和 11% 的时间要出超过 68.1% 的力（峰值 76～81%），其他关节都在 50% 以下。所以 681 主要削的是膝盖的峰值。我们后来改成了 700。

---

## 6. IMU 横滚零点往回补 1.14°

**现象**：P3 站 HOME 时 IMU 读到左倾 2.6°，走路时平均也一直左倾 1.8°～2.4°。

**查法**：跟 10-12 夜一样，站 HOME 时取真机关节角，放进仿真算机身「应该」倾多少，跟 IMU 读数比。今晚 5 次站 HOME，IMU 每次都比应有值**多读出往左 0.65°～1.69°，平均 1.14°**，方向始终一样。10-12 夜补的是前倾 8.54°、右倾 1.78°，这次横滚往回补 1.14°（方向跟 10-12 相反）。「应有值」是按左脚踩平、按右脚踩平两种算法的平均，这两种算出来本身就差 0.4°～2.6°（见本节最后），所以这 1.14° 的不确定度跟它本身差不多大。

**做法**：鸭子卸力，`imu_mount_fix.py 0 -1.14 <当前四元数>` 算新四元数，写进两份标定文件（`hd1910-calibration.toml` 和 `hd1910-calibration.saved.toml`，备份 `.bak-20261014-imuroll`），卸力状态下重启 robotd。新值 `[0.459554518, 0.539556409, 0.532044137, 0.463268349]`。

**结果**：复测左右偏差从 −1.31° 降到 −0.47°；走路时平均左右倾从 −2.4° 回到 −0.8°。

**还剩**：前后方向的偏差几次在 −0.2°～−1.8° 之间跳，不稳定，没动。

另外，P3 时站 HOME 左膝被压弯 7.6°、右膝 2.8°；P4 时是 2.2° 和 1.2°。P 越小，站着时腿越容易被体重压下去，左右差也会放大。

**两只脚在横滚方向不共面（没查）**：6 次站 HOME，按舵机读数做正运动学，「按左脚踩平」和「按右脚踩平」得到的机身横滚差 0.4°～2.6°，其中 5 次在 1.6°～2.6°，方向一样。也就是按舵机读数，两只脚掌在左右方向不在同一个平面上，可两只脚明明都踩在平地上。可能是髋横滚零位差 1～2°、某只脚掌有一边没着地，或者舵机测不到的机械间隙。前后方向两只脚是一致的（脚掌俯仰左 −3.0°、右 −2.9°）。**补充（10-14 白天）**：拆到每个关节查了，差别全部来自两个髋横滚没跟到 HOME 目标，每次都是左 +、右 −（腿往外劈），大小每次不同，像是被体重压的（推测）。零位本身偏没偏，那个方法看不出来。见 [10-14 白天记录 §7](HD1910-20261014-白天-仿真找原因与新版放开参数.md#7-站-home-两只脚左右方向不共面两个髋横滚往外劈每次不一样)。

---

## 7. 蹭地：两只脚都只抬了仿真的一半

### 7.1 先把「离地多高」算对

之前的抬脚算法是相对机身算的，没算机身的左右晃动（没放进仓库）。新的 [`foot_clear.py`](../tools/gait-analysis/foot_clear.py)：每一帧按舵机读数做正运动学，算出两只脚 8 个角的位置，再用 IMU 测到的机身姿态转正；较低的那只脚算撑地，另一只算迈步，**迈步脚最低点减去撑地脚最低点**就是离地间隙。自检：站 HOME 两脚都踩地时，两只脚的最低点应该一样高，IMU 补偿后差 0.8 mm。

结果见 §5.2 的表：**仿真 11～12 mm，真机最好的一组也只有 6～7 mm，P3 只有 3～6 mm**。迈步的时间里，有 18%～82% 离地不到 2 mm（仿真 9%～14%）。

### 7.2 为什么你看到的是左脚蹭：左脚迈步时脚尖朝下

迈步到最高点时，脚掌比撑地时转了多少度（正数＝脚尖朝下），以及这时脚上最低的点在哪（脚本 `toe_decomp.py`、`foot_clear.py`）：

| | 左脚 | 右脚 |
|---|---|---|
| 仿真 | −7.8°（脚尖翘起），最低是脚跟 | −6.0°，最低是脚跟 |
| P3 / D0 / 681 | **+2.0°**，最低是**脚尖**（27 步里 16 步） | −1.5°，最低是脚跟 |
| P3 / D0 / 681（第二次） | **+2.4°**，脚尖（17 步里 14 步） | −1.3°，脚跟 |
| P4 / D0，IMU 已补 | **+2.9°**，脚尖（31 步里 20 步） | −0.1°，脚跟 |
| P5 / D0 / 850 | **+2.5°**，脚尖（35 步里 18 步） | +0.3°，脚跟 |
| P5 / D20 / 1000 | +0.5°，脚跟（56 步里 36 步） | +0.1°，脚跟 |

仿真里迈步时脚尖会翘起 6～8°。真机右脚基本是平的；左脚在 **D=0 的每一组**都是脚尖往下，**D=20 那组没有**。D=20 和 D=0 两组是同一次开机录的，机械状态一样，所以这跟 D 有关，跟 P 调多少无关。脚尖朝下往前摆就会勾地；右脚最低的是脚跟，在后面拖着，看不太出来。

### 7.3 两只脚的共同原因：撑地的膝盖伸不直

撑地时膝盖相对 HOME 的角度（正数＝往伸直方向），括号里是模型要的：

| | 左腿撑地 | 右腿撑地 | 撑地腿把机身撑多高 |
|---|---|---|---|
| 仿真 | +5.4°（要 +18.5°） | +9.4°（要 +26.4°） | 124 mm |
| P3 / D0 / 681 | −6.2°（要 +4.3°） | −5.3°（要 +30.5°） | 117～120 mm |
| P4 / D0，IMU 已补 | −4.5°（要 +15.4°） | −2.6°（要 +23.1°） | 119 mm |
| P5 / D0 / 850 | −2.8°（要 +10.5°） | −3.4°（要 +22.0°） | 119～121 mm |
| P5 / D20 / 1000 | −4.1°（要 −1.6°） | +1.6°（要 +13.7°） | 121 mm |

撑地时模型一直在要膝盖伸直，仿真里的舵机能伸出去一部分，**真机的膝盖却一直弯着**：D=0 的几组在 −2.6°～−6.2°，D=20 时右腿能到 +1.6°，稍好。结果：
- 机身比仿真矮约 5 mm，迈步脚离地的空间就少了；
- 撑地时膝盖已经弯着，迈步时膝盖也就不再多弯。仿真里「迈步时膝盖比撑地时多弯」这一项，让脚掌转了 −14°～−16°（脚尖翘起）；真机这一项几乎是 0，脚尖就翘不起来。

**排除了电压**：10-14 凌晨走路时舵机电压中位 8.00 V、最低 7.93 V，没有往下掉。
**差在「同款舵机、不同条件」上**：训练用的舵机参数是陆吾公开的 1910 M6，就是这款舵机，参数本身没问题。仿真和真机还可能差在：
1. 我们跑 P3，训练是 P5（P3 本来就更软）；
2. 转矩限制我们是 681～850，仿真里没有这么低的上限（但 P5 / D20 / 1000 也伸不直，说明不只是转矩限制）；
3. 整鸭的重量和重心跟仿真不一样（我们没称过）；
4. 陆吾辨识时的条件（P、D、电压、负载）跟我们不同；BAM 里用的 STS 系控制算法跟 HD-1910 的固件是不是完全一样，也没核对过；
5. 舵机个体差异、关节的机械摩擦。

P5 / D0 / 850 撑地膝盖也伸不直（−2.8° / −3.4°），说明不只是 P 的问题。要分开这几条：先跑一组**最接近训练条件的 P5 / D0 / 1000**，走 10 秒，看撑地膝盖能不能伸出去；还伸不出去，就是重量或辨识条件的差别，再称重、做单关节阶跃响应跟仿真比。

**补充（10-14 白天）**：仿真里补查了。第 2 条转矩限制：仿真里设不设 70% 上限，结果几乎一样（陆吾参数削掉的只是峰值，飞特参数一次都没触发；只在 P5、737 g 下比过，真机没验证）。第 3 条重量：kissqy 训练用的模型是 820 g，我们的仿真是 737 g。还漏了一条更大的：真机联合模型的动作缩放约 0.83、带滤波，仿真里是 1.0、不滤波。把缩放、滤波对齐、重量按 820 g 估以后，仿真的撑地膝盖 −3.4° / −3.5°，已经接近真机（但那组仿真会颤）。见 [10-14 白天记录 §2](HD1910-20261014-白天-仿真找原因与新版放开参数.md#2-对齐条件以后撑地膝盖接近了但仿真多出了颤)。

### 7.4 只坑左脚的原因：机身前后点头

撑地时机身前倾（IMU）和撑地脚相对机身的角度：

| | 左腿撑地 机身前倾 | 右腿撑地 机身前倾 | 撑地脚相对机身 左 / 右 |
|---|---|---|---|
| 仿真 | +0.5° | +0.7° | — |
| P3 / D0 / 681 | +2.8° | **+4.7°** | −3.9° / −3.9° |
| P4 / D0，IMU 已补 | +1.1° | **+2.4°** | −2.9° / −2.2° |
| P5 / D0 / 850 | +0.3° | **+1.9°** | −2.4° / −2.4° |
| P5 / D20 / 1000 | +0.2° | +0.3° | −2.5° / −2.0° |

右腿撑地时（正好是左脚在迈步），机身比左腿撑地时**多往前栽 1.3°～1.9°**；**D=20 时没有这个差别**，仿真里两边也一样。机身往前一栽，迈步的左脚脚尖就被压下去了。

- **不是 IMU 装斜了**：如果 IMU 绕竖直轴装偏，横滚和俯仰在所有频率上都会按同一个比例绑在一起。实测在 6～20 Hz 几乎没有耦合（斜率 −0.04～+0.15），只在步频附近有（2～4.5 Hz 斜率 +0.10～+0.16，相关 0.4～0.5）。所以机身是真的在点头（脚本 `roll_pitch_coupling.py`）。
- **不是前后方向的零位**：两只撑地脚相对机身的俯仰角几乎一样（上表最后一列），站 HOME 时两脚脚掌俯仰左 −3.0°、右 −2.9°。左右方向（横滚）两只脚不共面，见 §6 最后（10-14 查了：两个髋横滚往外劈，像是被体重压的（推测），见 [10-14 白天记录 §7](HD1910-20261014-白天-仿真找原因与新版放开参数.md#7-站-home-两只脚左右方向不共面两个髋横滚往外劈每次不一样)）。
- **那多出来的 1.5° 从哪来**：撑地脚相对机身的俯仰左右一样，机身却多栽了；而且 D=20 时没有、D=0 时才有。**推测**（都没证实）：
  1. D=0 时右腿撑地那一下没了阻尼，机身往前晃（动态的，跟 D 有关）；
  2. 右脚撑地时没踩平：脚跟翘起来、用前掌撑，或者脚垫不平、打滑；
  3. 右腿有舵机测不到的机械间隙或变形（舵盘螺丝、支架、打印件）。舵机只测自己输出轴的角度，这些它看不见。

  第 1 条最符合「只在 D=0 时出现」，用一组中间的 D 就能验证（§7.5）。

### 7.5 下一步（一次只改一样）

1. **试一组中间的 D**：P3 或 P4、D=5～10、转矩 700，走 20 秒。看颤会不会回来、左脚尖朝下和机身点头会不会消失、撑地膝盖会不会伸得更出去；
2. **先看，不改**：手机慢动作（240 帧）贴地从侧面拍：一段拍右脚撑地时脚跟有没有翘，一段拍左脚是不是脚尖勾地。站 HOME 时从正前方看两只脚掌有没有一边翘起（后面打手电看缝），对应 §6 最后那条。上力站 HOME 时，用手轻轻掰两只脚（前后、上下），比比哪边有旷量；查右腿舵盘螺丝；
3. **联合缩放 0.9 → 1.0**（R17 上的版本是 0.9，V164 默认已是 1.0）：模型的动作统一大 11%，膝盖能多伸一点、多弯一点，两只脚都受益，随时能改回；
4. **根本办法是自训**：在我们自己的条件下（P、D、转矩限制、电压、整鸭重量）实测舵机响应，跟仿真对齐后再训；抬脚目标定 25～30 mm。现在这个模型在仿真里离地也只有 11～12 mm（训练时抬脚目标 20 mm、权重 −2，腾空时间 0.125～0.3 s），加上真机舵机更软，到真机就只剩一半；
5. **飞特官方的 HD-1910 BAM**：[gitee.com/ftservo/ftservo-bam](https://gitee.com/ftservo/ftservo-bam)（Apache-2.0，2026-09 发布），里面有 `feetech_hd1910_7_4V/m1～m6.json` 和专门的 HD-1910 控制模型，摆臂挂负载、P 从 4 测到 64、7.4 V。kissqy 这个模型用的是陆吾那份（借用 STS3215 的控制模型，再拟合一个增益系数 1.32），两份参数差别不小：电阻 2.97 Ω 对 4.91 Ω、跟负载有关的摩擦 0.35 对 0.07、指令延迟 1 ms 对 6 ms。下一步先在仿真里把舵机参数换成官方的，看仿真会不会也出现「撑地膝盖伸不直」。注意官方录数据时只写 P、没写 D，舵机很可能带着出厂 D=40，D 的效果会被算进摩擦参数里，用它训练时真机的 D 要跟着确认。**补充（10-14 白天）**：已在仿真里换成飞特参数（近似接入）比过：缩放 1.0 时飞特的更像真机，对齐缩放和滤波以后两份差不多，谁更像我们的舵机，仿真里分不出来。见 [10-14 白天记录 §3](HD1910-20261014-白天-仿真找原因与新版放开参数.md#3-两份舵机参数陆吾的和飞特官方的)。

---

## 8. 中控本地试验：联合缩放、头腿滤波做成可调（没有发布）

每只鸭子都有点不一样，总要微调。我们在本地给 kissqy 的中控（1.0.146 + R17 安装包）加了「联合缩放 / 头部滤波 / 腿部滤波」三个输入框和「应用联合参数」按钮：
- 范围：缩放 0.10～1.20，滤波 0.10～1.00，两位小数；用 kissqy 导入模型时同一个校验器先校验，不合法就不卸力、不停 robotd；
- 应用：校验 → 卸力 → 停 robotd → 只改 `deployment-execution.json` 的三个数 → 重启 → 从 `runtime_execution_profile` 回读确认；第一次修改时把原件存成 `.orig`；
- 测试：新加 4 个、原有 32 个相关测试全过；独立审核（另开一个 AI 会话只读审查）结论：**有 1 处必须修**（标定模式下 robotd 不回报模型信息，回读一定失败、网页误报），其余检查通过。修复方案已列出，等确认后再改；在运动模式下用不受这一条影响。

kissqy 的中控是个人非商业许可，这些改动只在本地用，不放进本仓库。

**补充（10-14）**：这个 1.0.146 上的试验没再继续（那处必须修的也没改），改在 kissqy 新版 V164 上重做，并加了 P / D / 转矩限制，见 [10-14 白天记录 §8](HD1910-20261014-白天-仿真找原因与新版放开参数.md#8-新版v164放开-p--d--转矩限制和头腿滤波本地未上机)。

---

## 9. 主板上改了什么，怎么改回去

**旧卡**（`duck` 用户）：

| 改了什么 | 备份 / 怎么回去 |
|---|---|
| `servo-test-parameters.json` = P3 / D0 / 700 | 在中控「高级参数」里改回 |
| IMU 安装四元数横滚往回补 1.14° | `hd1910-calibration*.toml.bak-20261014-imuroll` |
| `robotd.toml` 的 `action_scale`、头腿滤波（对联合模型无效） | `robotd.toml.bak-20261013-lowpass`，应改回原来的 0.7、去掉滤波两行 |
| `duck-rec.service` 去掉 `PartOf=robotd.service`，录像独立运行 | `.bak-20261013-partof` |
| 录像脚本换成每秒写盘的新版，加了 `duck-journal` | 删掉服务即可 |
| 安装包 `runtime.py`、`service.sh`（中控试验用） | `.bak-20261014-joint` |

**新卡**（`radxa` 用户）：蓝牙 `input.conf`（`.bak-20261013`）、kissqy 镜像里两个手柄相关服务 btd 和 gamesir-xboxd 禁用、duck-quiet、WiFi 5G 和 PMF、看门狗和 panic、黑匣子、运动模式（`/home/radxa/backup-20261013-*`）。舵机 RAM 里的 D=0 / 681 断电就没了。

---

## 10. 下一步

1. 供电：10-16 换 10 A 电源（粗短线 + 大电容），或者用电池；主板单独接充电宝做一次对照；
2. 蹭地：先试中间的 D，再拍慢动作、摸旷量，再试联合缩放 1.0（§7.5）；
3. 新卡：把 P / D / 转矩设置补回 V164（或者改舵机 EEPROM 里的 D），再上新卡；G50 Pro 在新卡上按 §1.2 完整配一次（10-14：补回的代码已在本地写好，未上机）；
4. ~~给 kissqy 提 Issue~~（10-14 晚：他在 V167 里已经改成上力写 D=0、转矩 1000，不用提了）：V164 **有意**不写 D 和转矩限制（他的设计文档写的是 48／51 号保留设备当前值），舵机就用出厂 D=40，跟训练用的舵机模型（没有 D）不一致。请求加一个可选项，让一键镜像的用户能设 D。附本页 §5 的数据。我们自己先看过再发；
5. 自训：HD-1910 实测舵机参数、抬脚目标 25～30 mm、步频约束。
