yoyojacky/microduck-replica/docs/生态导航.md

# Microduck 生态导航

**简体中文** · [English](ecosystem.en.md)

Microduck 的东西散在 GitHub 好几个组织和 HuggingFace 三种资源类型里，
**官方硬件仓库尤其容易被漏掉**（不在主仓，前缀是 `elec_`）。

这份索引说清楚每个东西**是什么、能拿来干嘛**。数据截至 **2026-09-04**，星数会变。

---

## 一、官方仓库（pollen-robotics）

### 核心两个

| 仓库 | 星 | 许可 | 这是什么 |
|---|---|---|---|
| [**microduck**](https://github.com/pollen-robotics/microduck) | 6982 | Apache-2.0 | **板载运行时**。Rust 写的，跑在机器人上的全部软件：50Hz 控制环、更新器、BLE、摄像头/WebRTC、ToF、语音。想读硬件规格也看这里 —— 设备路径、I²C 地址、寄存器全写死在代码里 |
| [**microduck_rl**](https://github.com/pollen-robotics/microduck_rl) | 1668 | Apache-2.0 | **强化学习训练环境**（基于 mjlab）。**47 个 STL 和完整 MJCF 在这里**，是所有几何信息的唯一来源 |

### 硬件（容易被漏的两个）

| 仓库 | 星 | 许可 | 这是什么 |
|---|---|---|---|
| [**elec_RPI_Robot_HAT**](https://github.com/pollen-robotics/elec_RPI_Robot_HAT) | 15 | Apache-2.0 | ⭐ **HAT 板的完整开源工程**。KiCad 9 原理图与 PCB、Gerber、BOM、贴片坐标、STEP、全套器件手册。**这块板不用自己画，下载 `production/` 直接打样**（4 层板） |
| [**lib_KiCAD**](https://github.com/pollen-robotics/lib_KiCAD) | 3 | — | Pollen 的 KiCad 符号/封装/3D 模型库。**打开上面那个工程必须先装它**，否则一片未解析符号 |

> 很多人以为「Microduck 硬件没开源」——**HAT 板其实是开源的**，只是不在主仓。
> 真正没公开的是 `imu_to_dxl` 板、可编辑机械 CAD 和整机 BOM。

### 配套

| 仓库 | 星 | 这是什么 |
|---|---|---|
| [rustypot](https://github.com/pollen-robotics/rustypot) | 56 | Dynamixel 通信库（Rust）。运行时靠它跟舵机说话，`xl330.rs` 里是完整寄存器表 |
| [microduck-gst-plugins](https://github.com/pollen-robotics/microduck-gst-plugins) | 13 | 预编译的 aarch64 GStreamer 插件：Rockchip MPP 硬件编码器 + WebRTC |
| `duck_detector` | — | ⚠️ **不公开**（404）。NPU 检测模型的训练仓库，官方文档里引用了它，但外部访问不到 |

---

## 二、HuggingFace

### 模拟器与可视化

| 名称 | ♥ | 说明 |
|---|---|---|
| [**pollen-robotics/microduck-simulator**](https://huggingface.co/spaces/pollen-robotics/microduck-simulator) | **374** | ⭐ **官方网页模拟器，打开就能玩**，不用装任何东西。想先感受一下就从这开始 |
| [mishig/microduck-anatomy](https://huggingface.co/spaces/mishig/microduck-anatomy) | 6 | 结构解剖可视化，HF 员工做的 |
| multimodalart/microduck-ar | 1 | AR 查看 |
| AlexWortega/microduck-vla-simulator | 0 | VLA（视觉-语言-动作）模拟 |

### 策略模型

| 名称 | ♥ | 说明 |
|---|---|---|
| [**pollen-robotics/microduck-policies**](https://huggingface.co/pollen-robotics/microduck-policies) | 8 | ⭐ **官方 9 个 ONNX 策略**。硬件同款即可直接用，不用重训 |
| [RemiFabre/microduck-flamingo-cycle](https://huggingface.co/RemiFabre/microduck-flamingo-cycle) | 21 | Rémi 本人发的，单脚站立循环 |
| RemiFabre/microduck-rough-walk-e / -g | 1 | 崎岖地面行走 |

社区还有一批动作策略：`happy-hop`（跳）、`polite-bow`（鞠躬）、`moonwalk-backward`（太空步）、
`beak-throw`（用喙抛物）、`electric-slide`、`swing`（荡秋千）、`stilts`（高跷）、`running`。

> 上游给了 `uv run publish` 一条命令，可以把自己训的策略直接发到 Hub。

### 数据集（最近才开始出现）

| 名称 | 更新 | 说明 |
|---|---|---|
| [craigm26/microduck-stairs-challenge](https://huggingface.co/datasets/craigm26/microduck-stairs-challenge) | 09-02 | 爬楼梯挑战 |
| craigm26/microduck-ball-challenge | 09-02 | 追球 |
| allen73/microduck-trajectory-dataset | 09-02 | 轨迹数据 |
| devorah-ai-2026/microduck-locomotion-dataset-v1 | 09-03 | 运动数据 |
| pngwn/microduck-detection-dataset | 09-03 | 目标检测 |
| craigm26/microduck-policy-golden-vectors | 08-31 | 策略回归测试的黄金向量 |

> 数据集集中出现在 9 月初，是社区**从「玩」转向「训」**的信号。

---

## 三、社区项目

### 工具与框架

| 仓库 | 星 | 这是什么 |
|---|---|---|
| [rokbenko/quackd](https://github.com/rokbenko/quackd) | 139 | 给小机器人接大脑，用自然语言指挥 Microduck / Open Duck Mini |
| [jonathanhawkins/microduck-lab](https://github.com/jonathanhawkins/microduck-lab) | 73 | **在普通 Mac 上训 RL 策略，不需要 CUDA** |
| [joeynyc/awesome-microduck](https://github.com/joeynyc/awesome-microduck) | 67 | 英文 awesome 列表 |
| [craigm26/duckkit](https://github.com/craigm26/duckkit) | 6 | 纯 Swift 实现，真策略真运动学 |
| [aj-dev-smith/microduck-mcp](https://github.com/aj-dev-smith/microduck-mcp) | 2 | 用 MCP 客户端驱动模拟器 |

### 训练与仿真

| 仓库 | 星 | 这是什么 |
|---|---|---|
| [Vottivott/microduck-playground](https://github.com/Vottivott/microduck-playground) | 14 | 可复现的 RL 实验、策略、仿真资产 |
| [kabilankb/isaaclab-microduck](https://github.com/kabilankb/isaaclab-microduck) | 6 | Isaac Lab 3.0 / Newton MJWarp 环境 |
| [Macmachi/microduck-rl-genesis](https://github.com/Macmachi/microduck-rl-genesis) | 2 | Genesis 移植版，**在 AMD 显卡上训** |
| [AlexBodner/microduck-tracking](https://github.com/AlexBodner/microduck-tracking) | 12 | 多目标跟踪 |
| [ftservo/ftservo-bam](https://gitee.com/ftservo/ftservo-bam)（Gitee，飞特官方） | — | Rhoban/BAM 的飞特派生（Apache-2.0）：新增 **HD-1910** 的 BAM 参数（m1～m6）和专门的控制模型，以及 HD-1910 / STS3215 的录数据脚本。跟陆吾 1910 M6 的对比见[参数来源说明](HD-1910-M6参数来源.md#飞特官方-hd-1910-bam) |

### 复刻与硬件

| 仓库 | 星 | 这是什么 |
|---|---|---|
| **本仓库** | 414 | 装配分析 + 电控逆向；模型与打印文件统一在 CAD 仓库 |
| [IronSpiderMan/MicroDuckModels](https://github.com/IronSpiderMan/MicroDuckModels) | 30 | **中文**。Three.js 网页 3D 预览器，按运动学层级交互查看 |
| [ScrapMeta/microduck-diy](https://github.com/ScrapMeta/microduck-diy) | 16 | **中文**。「一个月手搓挑战」记录 |
| [SaberOnGo/open-microduck](https://github.com/SaberOnGo/open-microduck) | 7 | 中英双语硬件文档（**目前只有文档，没有 PCB 文件**） |
| [boris721/microduck-3d](https://github.com/boris721/microduck-3d) | 6 | 从上游提取的 STL + MJCF |
| [Rhoban/microban](https://github.com/Rhoban/microban) | — | ⭐ **不是 Microduck，但用同一块 HAT**。19×XL330 + Pi Zero 2W 双足，**有完整公开 BOM 和装配指南**（约 $567），采购时值得对照 |

### 历史线索

| 仓库 | 说明 |
|---|---|
| [TommyZihao/microduck_runtime](https://github.com/TommyZihao/microduck_runtime) | **原型机运行时的公开镜像**。原仓库 `apirrone/microduck_runtime` 已私有。里面记录了一件事：**原型机用的是 BNO055 走 I²C**，不是现在的 `imu_to_dxl` 板 |

---

## 从哪开始

| 你想做什么 | 去哪 |
|---|---|
| 先感受一下 | [官方网页模拟器](https://huggingface.co/spaces/pollen-robotics/microduck-simulator)，打开就能玩 |
| 看它长什么样、怎么装 | [CAD 仓库的模型与安装说明](https://github.com/fanhao375/microduck-replica-cad)；本仓装配渲染只作上游分析参考 |
| 打印零件 | [CAD 仓库](https://github.com/fanhao375/microduck-replica-cad)；[版本提示](../print/README.md) |
| 搞懂电控 | 本仓库 [`docs/硬件方案逆向.md`](硬件方案逆向.md) |
| 做 HAT 板 | [`elec_RPI_Robot_HAT`](https://github.com/pollen-robotics/elec_RPI_Robot_HAT) 的 `production/`，别忘了先装 `lib_KiCAD` |
| 训自己的策略 | [`microduck_rl`](https://github.com/pollen-robotics/microduck_rl)；没有 N 卡就用 [microduck-lab](https://github.com/jonathanhawkins/microduck-lab) |
| 读硬件规格 | [`microduck`](https://github.com/pollen-robotics/microduck) 源码 —— **代码即规格书** |
