yoyojacky/microduck-replica/docs/软件来源与我们的改动.md

# 软件从哪来、我们改了什么、上游仓库里碰到的问题

截至 2026-10-14。鸭子上跑的软件，大部分是 Pollen 官方和 kissqy 的，我们在上面打补丁、改配置，再加一些自己的工具。这一页说清楚三件事：**用了谁的**、**我们改了哪里、改动放在哪、推没推**、**在别人仓库里碰到的问题，处理了没有**。给接手的人和他们的 AI 看。每一项的细节都链接到当天的上机记录或[踩坑记录](../踩坑记录.md)。

---

## 1. 现在第一台鸭子上跑的是什么

| 层 | 用的是 | 来源 | 我们改了没有 |
|---|---|---|---|
| 主板系统 | 旧卡：我们自己做的 Armbian 卡；新卡：kissqy 一键镜像 R1 | 做卡脚本 [`tools/radxa/`](../tools/radxa/)；镜像 [kissqy/Microduck-kissqy](https://github.com/kissqy/Microduck-kissqy) | V1.12 主板要换瑞莎的引导才能开机（`kissqy-r1-v112.sh`） |
| 板载运行时（robotd、padd） | kissqy 的 R17（旧卡）/ V164（新卡），底子是官方 0.15.1 | 官方 [pollen-robotics/microduck](https://github.com/pollen-robotics/microduck) → kissqy 加飞特 HD-1910 适配 | **加了 I²C IMU 支持**（BNO085 模块），见 §3 |
| 舵机参数 | P3 / D0 / 转矩限制 700 | R17 的 `servo-test-parameters.json` | 是我们测出来的值（R17 默认是 P5 / D20），见 [10-13 夜 §5](HD1910-20261013-夜-掉电-舵机D与蹭地.md#5-走路发颤跟舵机的-d-有关) |
| 关节标定、IMU 安装四元数 | 我们自己标的 | — | 零位全 2048、方向全 −1；IMU 10-12 补前倾 8.54°、右倾 1.78°，10-14 横滚往回补 1.14° |
| 走路模型 | kissqy 的「行走＋倒地联合 9600 轮」 | kissqy 训练 | 没改模型，只改舵机参数 |
| 电脑上的中控 | 旧卡用 kissqy 中控 1.0.146；新卡用 1.0.164（V164 配套） | kissqy（个人非商业许可） | 本地补丁，不发布，见 §3；1.0.164 上的可调版还没上机 |
| 手柄 | 雷神 G50 Pro，S 档（Switch Pro 模式） | — | 配对流程见 [10-13 夜 §1.2](HD1910-20261013-夜-掉电-舵机D与蹭地.md#12-g50-pro-配对上又被断开) |
| 训练 | 官方 [microduck_rl](https://github.com/pollen-robotics/microduck_rl)；kissqy 的训练中控 | — | HD-1910 训练工程放在本仓库 [`software/training/`](../software/training/)（以前 `fanhao375/microduck_rl` 的 `codex/hd1910-m6` 分支保留作历史来源，见其 `UPSTREAM.md`） |
| 调试、分析工具 | 自己写的 | 本仓库 [`tools/`](../tools/) | servo-web、上机录像、步态分析、duck-quiet |

---

## 2. 上游仓库和许可

| 仓库 | 许可 | 我们用它做什么 |
|---|---|---|
| [pollen-robotics/microduck](https://github.com/pollen-robotics/microduck) | Apache-2.0 | 板载运行时的源头。9-18 我们在自己的 fork（`fanhao375/microduck`，`feetech` 分支，1 个提交，已推）上做过飞特总线后端，后来改用 kissqy 更完整的适配 |
| [pollen-robotics/microduck_rl](https://github.com/pollen-robotics/microduck_rl) | 代码 Apache-2.0；**3D 模型 CC BY-NC-SA**（见 [NOTICE](../NOTICE.md)） | 训练环境和 MJCF。我们用它的 `scene_backlash.xml` 做仿真对照、正运动学（IMU 零点校准、离地间隙都靠它） |
| [pollen-robotics/elec_RPI_Robot_HAT](https://github.com/pollen-robotics/elec_RPI_Robot_HAT) | Apache-2.0 | HAT 板，我们打的是 C1 版 |
| `duckctl`（官方，`uvx duckctl@0.17.1`） | Apache-2.0 | 电脑端 UDP 手柄 |
| [LuwuDynamics/xgoduck_rl](https://github.com/LuwuDynamics/xgoduck_rl) 的 `1910_m6.json` | Apache-2.0 | 1910 舵机的 BAM 参数（借用 STS3215 控制模型）。kissqy 的走路模型和我们的训练基线都用它，来源见 [HD-1910 M6 参数来源](HD-1910-M6参数来源.md) |
| 飞特官方 [ftservo/ftservo-bam](https://gitee.com/ftservo/ftservo-bam)（Gitee） | Apache-2.0 | 飞特自己辨识的 HD-1910 BAM 参数和专门的控制模型（7.4 V，P 4～64）。**还没接进训练工程**，下一步先在仿真里跟陆吾那份对比（对比和注意事项见[参数来源说明](HD-1910-M6参数来源.md#飞特官方-hd-1910-bam)；计划见 [10-13 夜 §7.5](HD1910-20261013-夜-掉电-舵机D与蹭地.md#75-下一步一次只改一样)） |
| [kissqy/Microduck-kissqy](https://github.com/kissqy/Microduck-kissqy) | **源码公开（Source-available），分项许可**：`firmware/` 下的 Rust 工作区和上游代码（robotd、padd 等）是 Apache-2.0；中控 `firmware/console/`、`firmware/policies/` 里他自训的模型、训练中控、他新写的文档和工具是**个人非商业许可**——公司或组织用途、产品销售、收费服务都要事先取得他的书面许可 | R17 / V164 运行时、中控、联合走路模型、一键镜像 R1、HD-1910 的部署合同 |

**我们跟 kissqy 的约定（我们 10-12 定的）**：
- 不给 kissqy 提 PR。我们的补丁放在自己这边：以他的最新版为底，叠上我们的补丁，跟着他更新；
- 保留他的许可和署名，标明哪些是我们改的，不换名、不商用；
- 他的中控受非商业条款约束，**中控的改动不放进本仓库**。以后做「傻瓜式」页面，自己写引导页去调他的程序和接口，不改他的中控；10-14 起我们在 GitHub 上 fork 了他的仓库（[fanhao375/Microduck-kissqy](https://github.com/fanhao375/Microduck-kissqy)），只放 robotd 等 Apache 许可部分的改动，**他的中控在 fork 里原样未改**；
- 发现他那边的问题可以提 Issue，**提之前先整理好数据，两个人都看过再发**。

---

## 3. 我们的改动

### 3.1 代码（都在 kissqy 仓库的本地分支上，还没推到任何地方）

| 改动 | 为什么 | 本地分支 | 状态 |
|---|---|---|---|
| robotd 支持 I²C IMU（BNO085 / LSM6DSV16X），配置里 `[trunk_imu] source` 一行切换；后台线程读，坏包丢弃、断线重连；各型号安装方向分开存，没确认方向不给上力 | kissqy 的 robotd 只认他的总线 IMU 小板，我们用的是 BNO085 模块 | `hd1910-trunk-imu-i2c`（基于 R17，相对 kissqy main 36 个提交，含下一行的中控补丁）；合进 V164 的是 `hd1910-v164-trunk-imu-i2c` | **旧卡、新卡都在跑**。新卡镜像 `R1-V112-imu` 就是 kissqy R1 + 这个补丁。10-14 合进他的 V167，**公开**在 fork 的 `hd1910-v167-trunk-imu-i2c` 分支（中控改动没带），附安装脚本和[使用说明](https://github.com/fanhao375/Microduck-kissqy/blob/hd1910-v167-trunk-imu-i2c/IMU-MODULE.md)；V167 版还没上真机 |
| 中控测试补丁：网页手柄时限 0.4 s → 3 s、连上先预热、`--tofd-socket ""` 不连 ToF | 网页手柄按了没反应、没接 ToF 时每 5 秒 SSH 重连（[10-12 夜 §1](HD1910-20261012-夜-IMU校准与首次迈步.md#1-网页手柄按了没反应四层原因叠在一起)） | 同上，提交 `881c810` | 本地用；后来改用蓝牙手柄，这条路基本不走了 |
| padd 加 UDP 手柄、手柄掉线 1 秒自动坐下（移植官方 0.17） | 跟进官方新功能，又不整体升级（官方 0.17 改了两万多行，接口版本号也对不上） | `hd1910-v164-udp-pad`（42 个提交 = 36 个 IMU 补丁 + 6 个 UDP 手柄） | 6 轮审核通过，**还没上机**（[10-13 记录](HD1910-20261013-官方更新与UDP手柄.md)） |
| 中控「高级参数」加联合缩放、头腿滤波三个框 | 联合模型的这三个数在模型包里，中控原来改不了；每只鸭子都要微调 | `hd1910-trunk-imu-i2c` 工作区，**未提交** | **已被下一行取代**，不再继续（那处必须修的也没改）（[10-13 夜 §8](HD1910-20261013-夜-掉电-舵机D与蹭地.md#8-中控本地试验联合缩放头腿滤波做成可调没有发布)） |
| V164 放开舵机 P / D / 转矩限制和头腿滤波：板上 robotd 接回参数文件（上力写 RAM、卸力恢复），`service.sh` 加三个命令，中控 1.0.164「高级参数」加两块 | V164 只写 P，D 留在出厂 40，中控里也改不了；每只鸭子都要调 | `hd1910-v164-tunable`（在 `hd1910-v164-trunk-imu-i2c` 上加 2 个提交） | 测试、审核过，**还没上机**（[10-14 白天 §8](HD1910-20261014-白天-仿真找原因与新版放开参数.md#8-新版v164放开-p--d--转矩限制和头腿滤波本地未上机)） |

### 3.2 板子上的配置（不是代码，每次都留了备份）

每一项改在哪、备份叫什么、怎么改回去，都在当天上机记录的最后一节：
- [10-12 夜 §9](HD1910-20261012-夜-IMU校准与首次迈步.md#9-今晚在主板上改了什么怎么改回去)：SSH 欢迎脚本、IMU 安装四元数、录像服务、蓝牙手柄；
- [10-13 夜 §9](HD1910-20261013-夜-掉电-舵机D与蹭地.md#9-主板上改了什么怎么改回去)：舵机参数、IMU 横滚补偿、录像服务改版；新卡的蓝牙、WiFi、看门狗、黑匣子。

### 3.3 本仓库里我们自己的工具

| 目录 | 是什么 |
|---|---|
| [`tools/servo-web/`](../tools/servo-web/) | 网页舵机调试台：滑块、姿态、序列、3D 跟随、寄存器导出 |
| [`tools/radxa/`](../tools/radxa/) | 做卡脚本、V1.12 引导修复（`kissqy-r1-v112.sh`）、`duck-quiet.sh`（关掉用不到的服务） |
| [`tools/radxa/onboard-analysis/`](../tools/radxa/onboard-analysis/) | 主板上的录像服务（每秒写盘）、系统日志抄写、掉电排查、IMU 零点校准 |
| [`tools/gait-analysis/`](../tools/gait-analysis/) | 电脑上的步态分析：颤、跟随、离地间隙、脚尖朝向、撑地姿态 |
| [`software/training/`](../software/training/) | HD-1910 训练工程（mjlab + BAM），可以直接克隆训练；参数来源见 [HD-1910 M6 参数来源](HD-1910-M6参数来源.md) |

---

## 4. 上游仓库里碰到的问题

「反馈」一列：到 10-14 为止，这些都**还没给上游提过**。

### 4.1 kissqy

| 问题 | 影响 | 我们怎么处理 | 详见 |
|---|---|---|---|
| **V164 有意不写舵机 D（51 号）和转矩限制（48 号）**（他的设计文档：48／51 保留设备当前值），舵机用出厂 D=40、1000；训练用的舵机模型里没有 D | 走路发颤、更容易把电源拉垮；V164 配套的中控 1.0.164 里没有 P/D/转矩的框（旧中控 1.0.146 有框，但对 V164 不生效），一键镜像用户**没法调** | 用 R17 设 P3/D0/700；新卡上手动写舵机 RAM；本地可调版（10-14，未上机） | [10-13 夜 §4.2、§5](HD1910-20261013-夜-掉电-舵机D与蹭地.md#42-舵机的-p--d--转矩限制r17-能设v164-不能)；**~~准备提 Issue~~**：10-14 晚他发了 V167，改成上力写 D=0、转矩 1000（固定值），不用提了 |
| 装 R17 时没有本机标定，就用他样机的标定补齐，并标成「已标定」 | 零位全错，直接 HOME 会让关节打到错误位置 | 装完先换成自己的标定 | 踩坑记录「舵机 / 校准」 |
| 一键镜像 R1 预装样机标定，IMU 标成「已确认」 | 同上，IMU 方向也不一定对 | 刷完先改标定、重新确认 IMU | 同上 |
| 一键镜像 R1 用 Armbian 原版引导，V1.12 主板起不来 | 开不了机 | 换瑞莎引导（`tools/radxa/kissqy-r1-v112.sh`） | [R1 分析](HD1910-20261012-kissqy镜像R1分析.md) |
| robotd 只认他的总线 IMU 小板 | IMU 模块用不了 | 我们的 I²C IMU 补丁（§3.1） | 踩坑记录「软件」 |
| R17 的网页手柄一路上有好几道 0.4～0.6 秒的超时，按键经常被丢 | 网页手柄按了没反应 | 改用蓝牙手柄；V164 已经改成直接走 robotd | [10-12 夜 §1](HD1910-20261012-夜-IMU校准与首次迈步.md#1-网页手柄按了没反应四层原因叠在一起) |
| 中控没接 ToF 时每 5 秒 SSH 重连一次 | 主板白占 CPU、发热 | `--tofd-socket ""`（本地补丁） | 踩坑记录「软件」 |
| 源码里有两份 `padd.service`，安装包用的是 `packaging/` 那份 | 改错文件不生效 | 两份一起改，再同步 `packaging/SHA256SUMS` | 踩坑记录「软件」 |
| `service.sh init` 在 robotd 运行时发不出 HOME | 命令行回 HOME 无效 | 走中控或 `robot.init` | 踩坑记录「软件」 |
| 联合模型的缩放和滤波在模型包里，`robotd.toml` 的同名设置对它不生效 | 设计如此，但容易误改 toml、白做对比 | 看 `runtime_execution_profile` 确认实际值 | [10-13 夜 §4.1](HD1910-20261013-夜-掉电-舵机D与蹭地.md#41-联合模型的缩放和滤波在模型包里不在-robotdtoml) |
| 他曾写「走几步 ZERO 会重启，疑 LM5050 余量不足」 | 不是问题：**他 10-12 已删除**（作者更正） | 别再引用 | [10-13 夜 §2](HD1910-20261013-夜-掉电-舵机D与蹭地.md#2-整机掉电是供电不是软件) |

### 4.2 官方

| 问题 | 影响 | 我们怎么处理 | 详见 |
|---|---|---|---|
| `install.sh` 只装最新版，kissqy 的 R17 要的是 0.15.1 | 装出来版本对不上 | 用 kissqy 的安装流程固定 0.15.1 | 踩坑记录「软件」 |
| 没接摄像头和 ToF 时，mediad、tofd 不停重启 | 主板发热 | 关掉这两个服务（`duck-quiet.sh`） | 踩坑记录「主板 / HAT」 |
| setup-board 有意设 `UserspaceHID=false`（省 CPU，官方板上没问题） | 在我们开机就「不可绑定」的卡上，Pro Controller 配上就被断开 | 配对前 `btmgmt bondable on`；我们还改了 `input.conf`，哪项必需没拆开试 | [10-13 夜 §1.2](HD1910-20261013-夜-掉电-舵机D与蹭地.md#12-g50-pro-配对上又被断开) |
| 官方新版和 kissqy 的接口版本号各自往上加，同一个数字含义不同 | 新旧组件混用时，按版本号判断会判错 | 不整体升级，只移植需要的功能 | 踩坑记录「软件」 |

---

## 5. 以后怎么做

- **能用上游现成的就用**，缺什么补什么。自己另写一套运行程序，每个细节都是看不见的变量（踩坑记录「策略训练与真机迁移」第一条）；
- **补丁做小、分支清楚**：每个补丁一个分支，提交说明写为什么，方便跟着上游更新、以后要提 Issue 也能直接附上；
- **先确认参数在哪生效，再改**：同一个名字可能有好几处（toml、模型包、舵机 EEPROM、RAM），改之前先找到「运行时实际在用的值」从哪读；
- **上游有更新时**：先看改了什么、跟我们的补丁冲不冲突，再决定是整体升级还是只移植（[10-13 官方 0.17 的处理](HD1910-20261013-官方更新与UDP手柄.md)）。
