yoyojacky/microduck-replica/docs/CAD结构件版本核对-20260928.md

# 主仓结构件与 CAD 版本核对（2026-09-28）

**核对结论：原先没有完全对齐。** 主仓的打印 STL、装配预览和训练几何来自上游 XL330 模型；CAD 仓库已发布飞特 v2.1。旧文件不能直接当成最新飞特 CAD 的打印导出件。

**按用户确认后的处理方式：模型直接指向配套 CAD 仓库。** 主仓已移除 `print/` 的 45 个旧单件 STL、`cad/` 的 16 个装配 STL 与旧对照表，这两个目录改为下载入口；中英文首页、BOM、采购说明与署名同步调整。旧文件可从 Git 历史追溯，模型的后续版本统一在 [microduck-replica-cad](https://github.com/fanhao375/microduck-replica-cad) 维护。

CAD 仓库的说明同步修正：XL330 打印入口不再跳回主仓旧 STL，改指向本仓 v1.1 源文件；09-15 3MF 与旧 BOM 的版本边界也已标明。本轮只修改该仓 README，没有更新 CAD、3MF 或工作簿。

本轮没有重新导出或重排 CAD / 3MF，也没有替换训练、网页模型及物理参数。分析导出脚本默认写入被忽略的 `analysis-output/cad-upstream/`，避免重新生成一套主仓下载文件。以下保留修改前的检查证据，经独立 agent 复核。

## 核对基准

| 对象 | 版本 / 结果 |
|---|---|
| 主仓远端 `fanhao375/microduck-replica` | `a23f4c18a4741a3cde5257e639960ea37bbadd8d` |
| CAD 远端 `fanhao375/microduck-replica-cad` | `749fcefb404a0750777d7cc8badfe30700df2f9b` |
| 飞特最新发布 | [v2.1，2026-09-25](https://github.com/fanhao375/microduck-replica-cad/releases/tag/v2.1) |
| XL330 最新发布 | [v1.1，2026-09-15](https://github.com/fanhao375/microduck-replica-cad/releases/tag/v1.1) |
| 核对开始时本地 CAD 工作目录 | `1623d34`；检查使用已 fetch 的远端 `749fcefb`。后续修正 README 前已快进到该远端版本 |

独立复核逐个比对主仓 `print/`、`cad/` 共 65 个文件的 Git blob，本地与主仓远端一致。因此下列差异不只是本地没更新，也存在于主仓线上版本。

## 哪些没有同步

| 内容 | 修改前核对状态 | 实际影响 |
|---|---|---|
| [旧主仓打印件](https://github.com/fanhao375/microduck-replica/tree/a23f4c18a4741a3cde5257e639960ea37bbadd8d/print) | 30 种步行 STL 的 SHA256 全部与本地上游 `microduck_rl` 原始网格一致，也与主仓训练目录对应网格一致 | 未替换成飞特 CAD 改动件，不能按“最新飞特整套打印件”使用 |
| [旧主仓装配预览](https://github.com/fanhao375/microduck-replica/tree/a23f4c18a4741a3cde5257e639960ea37bbadd8d/cad) | 15 个分组件 + 1 个整机 STL，由上游 MJCF/网格变换导出；[生成脚本](../scripts/export_assembly_stl.py)读取 `robot_allcollisions.xml` | 是上游模型的装配预览，不是新 SolidWorks 装配体的导出结果 |
| [主仓首页](../README.md) / [CAD 目录说明](../cad/README.md) | 首页中英文仍指向飞特 v2.0；CAD 目录说明还把 XL330 写成 v1.0 | 下载入口和版本说明落后 |
| CAD 仓库 3MF | 仍是原有约 4.9 MB、09-15 发布的工程；v2.1 提交只改 README，没有改 3MF | 已含部分飞特 STEP 改件，但未同步这次 v2.1 的合体轮胎 |
| [训练网格](../software/training/src/mjlab_microduck/robot/microduck/assets/) | 沿用原 Microduck 几何；[HD1910 说明](../software/training/src/mjlab_microduck/robot/hd1910/README.md)明确保留本地几何与关节约定 | 接入飞特舵机模型参数不等于接入新版实物结构；质量、惯量也需要单独核对 |
| [网页调试模型](../tools/servo-web/model/model.json) | 来源仍标为 `apirrone/microduck_rl robot_allcollisions.xml`，含 XL330 网格；备注中的质量来自官方模型 | 可用于现有调试显示，但不能认为外观及重心已由最新飞特 CAD 校准 |

## 已确认的几何差异

下表将主仓单件 STL 与 CAD 仓库现有 3MF 中对应 STEP 来源网格比较，旧 STL 的米制坐标先统一转换为毫米。独立复核确认所列网格均为闭合且有效的体积；这些差异说明不是仅仅改名或导出文件格式不同。

| 零件 | 主仓 STL | CAD 仓库现有 3MF 对应件 |
|---|---|---|
| 上腿加固板 | 厚 1 mm，体积约 747.79 mm³ | 厚 2 mm，体积约 1678.08 mm³ |
| `bearing_roll` 横滚轴承压盖 | 厚 3 mm，体积约 625.28 mm³ | 厚 3.5 mm，体积约 929.25 mm³ |
| 左踝 | 体积约 7877.82 mm³ | 体积约 6349.67 mm³ |
| 右踝 | 体积约 7877.81 mm³ | 体积约 6188.97 mm³ |

这是**主仓 STL 与现有 3MF**的直接比较，不冒充本轮从所有 v2.1 SolidWorks 源文件重新导出的结果。飞特版左右上腿、小腿、yaw2roll 等还有 CAD 修改记录和 STEP 来源，应一并建立版本映射，而非仅凭文件名判断。

## v2.1 与打印包还有两处要分清

1. **合体轮胎属于轮滑变体。** v2.1 发布说明是将分开的 `rim` 和 `tire` 合并为 TPU 合体轮胎；不能据此说走路整机所有零件都在 09-25 改过。
2. **CAD 仓库 3MF 没跟上这项变更。** 远端与本地 3MF 的 Git blob 都是 `796b092c754e8c7041a4ca5495d01757c56c5266`；`Metadata/model_settings.config` 仍有轮辋 4 个、轮胎 4 个，没有合体轮胎。该 3MF 不能称为 v2.1 完整打印包。本轮未另外验证 MakerWorld 在线工程是否更新。

另外，已下载并核验 v2.1 的 10 件 STEP 包：SHA256 为 `57dd4a2a191bedbf01a4916bc4df34bba6c175793b532ebecc7a1e1aed8c2ca0`，与 GitHub 附件 digest 相符。和 v2.0 的 9 件包逐个比较：

- **7 件内容相同**：加固板、`99-yaw_roll_motion`、压盖、左右上腿、飞特小腿、`yaw2roll`。
- **新增 3 件文件**：飞特左踝、右踝、合体轮胎。
- **包内不再包含 2 件**：无 `-FT` 后缀的小腿和 `trunk_base_躯干底座-FT.STEP`。

因此“9 个 STEP 加一只轮胎”不足以完整描述附件变化；缺少的躯干底座 STEP 不能被理解成该实体零件已取消。完整 SolidWorks v2.1 装配引用本轮没有逐件打开验证，后续导出时应检查。

## 后续真正修改模型时的核对事项

本次用户选择统一到 CAD 仓库维护，不在主仓另造打印包。后续若更新 CAD 仓库或训练模型，仍需核对以下事项：

1. 在 CAD 仓库明确 XL330 与飞特版本，避免两套舵机的配合件混用；主仓保持链接入口。
2. 以 CAD v2.1 全套源文件为基准建立零件映射，先核对走路用的踝、小腿、加固板、压盖、左右上腿和躯干安装件，再单独处理轮滑合体轮胎。
3. 从确认后的 CAD 导出 STL，核对单位、左右件、孔位和数量，再更新 3MF、BOM 与下载入口。不能只把旧 STL 改文件名或把链接改成 v2.1 就算完成。
4. 最后更新装配预览和网页模型；训练侧要另外校准关节坐标、碰撞体、质量/质心/惯量，完成模型检查后再训练，不能直接把打印网格覆盖进去。

原始核对文件保存在本机临时目录 `microduck-cad-audit-20260928`，含发布元数据、主仓 STL 哈希匹配表和两个 STEP 包的逐件比较。
