yoyojacky/microduck-replica/tools/radxa/50Hz保持姿势读状态-20260928.md

# HAT 保持姿势状态回读：3000 轮

测试开始时间：2026-09-28 23:49:17（调试电脑记录）。主板 Armbian + HAT，`/dev/ttyS2`，网页调试台 0.15.4，回读目标 50 Hz；关节 ID 为 `10–14`、`20–24`、`30–33`，共 14 颗，嘴不参与。

| 指标 | 结果 |
|---|---:|
| 每颗有效样本 | 3000 / 3000 |
| 总有效状态 | 42000 |
| 首尾时间跨度 | 63.9904 秒 |
| 按 2999 个间隔计算的实际频率 | 46.8664 Hz |
| 窗口内 timeout / bad_checksum / bad_id 增量 | 0 / 0 / 0 |

测前、测后 14 颗扭矩寄存器均为 1。目标位置、扭矩上限、速度、加速度、模式及相位前后未变。机器人保持既有姿势，本次没有要求全部回到 2048，也没有进行动作、校准或配置写入。

0.15.3 修复了同步读按预期 ID 顺序消耗回包的问题，改为按回包实际 ID 归档，避免一个缺包牵连后续有效回包；0.15.4 将网页状态回读目标改为 50 Hz。该修复的相关 38 项本机测试及协议模拟自检通过。它修正的是数据解析，不能证明线束、电气或舵机响应问题全部消失。

本结果仅覆盖上述约 64 秒窗口。后续运行日志仍出现过单颗缺应答，因此不能写成“整段运行零漏读”或“通信根因全部解决”。本轮没有 IMU 采集、策略推理或目标位置写入，**不构成完整 50 Hz 机器人控制循环、带载运动或步态验收**。

摄像头目前仅在官方 B1 确认出图；Armbian 复测、IMU 混合总线、Rust 运行时整机接入、保护配置和步态仍需分别验证。调试台是主板上的单独部署，未包含在公开 Armbian 基础镜像里。

原始数据保存在调试电脑的 `Radxa-Zero3W/调试记录/50Hz使能保持只读3000轮-20260928-234917.json`，本页只公布汇总，未上传约 13 MB 的原日志。2026-09-29 已重新核对原始记录。
