yoyojacky/microduck-replica/docs/机械采购清单.md

# 机械采购清单（国内 / 淘宝）

> **仓库里有四份清单加一份打印说明，各管各的：**
>
> | 文档 | 管什么 | 不管什么 |
> |---|---|---|
> | [BOM](../BOM.md) | **总表**：全部物料、数量（从 MJCF 的 geom 引用数出来的）、成本量级、还没解决的空白 | 具体买哪家、怎么打印 |
> | [电控采购清单](电控采购清单.md) | 电控件**买哪家**：主控 / 摄像头 / ToF / 电源 / 两块 PCB / 线材，淘宝实链 + 避坑 | 数量依据、机械件 |
> | **机械采购清单**（就是这份） | 机械件**买哪家**：轴承 / 紧固件 / 耗材，淘宝实链 | 电控件 |
> | [硬件规格速查](硬件规格速查.md) | **参数**：接口、电压、协议、软件侧必须对齐的值 | 价格和店铺 |
> | [print/README](../print/README.md) | **打印入口**：在 CAD 仓库选择版本、材料和数量 | 采购 |
>
> 装配用的件号与螺丝对应在 [CAD 仓库](https://github.com/fanhao375/microduck-replica-cad#装配-bom)。

> **快照时间：2026-09-04。** 价格与销量会变，链接可能失效，下单前自己核价。
> 电子电气件（主控 / 摄像头 / ToF / 电源 / PCB / 线材）见 [电控采购清单](电控采购清单.md)。
>
> 数量来自 MJCF `robot_walk.xml` 的 mesh 实例计数与孔特征反推，**是推导值不是官方图纸**。

---

## 一、轴承（共 14 个，两种规格）

数量直接数 `robot_walk.xml` 里的 mesh 引用，六个 MJCF 变体计数完全一致。
**规格是实测网格几何得出的，不是看文件名**：

| 规格 | 数量 | 实测（外径 / 内孔 / 宽） | 网格 |
|---|---|---|---|
| **Ø22 × 16 × 4** | **11** | 22.0 / **16.0** / 4.0 mm | `seeed_bearing__configuration__22x16x4` |
| **Ø15 × 10 × 3** | **3** | 15.0 / **10.0** / 3.0 mm | `seeed_bearing__configuration_default` |

| 店铺 | 说明 | 价格 | 链接 |
|---|---|---|---|
| **NBZH 永天轴承**（16年老店） | 不锈钢超薄壁 `ET2216ZZ` / `MR16224` / `SET2216` / `DDA2216`，16×22×4 | **¥2.2** | [taobao 539024647147](https://item.taobao.com/item.htm?id=539024647147) |
| **鑫燚轴承**（7年老店） | NSK 微型轴承，**同一链接同时有 10×15×3 和 16×22×4** | **¥5** | [taobao 670727787832](https://item.taobao.com/item.htm?id=670727787832) |

> 💡 鑫燚那条一个链接能把两种规格一起买齐，省事。

**机械行者Robo 装飞特版时实际买的**（2026-09-16，能用）：10×15×3 在 [淘宝 963037239628](https://item.taobao.com/item.htm?id=963037239628&skuId=6069280211062)，16×22×4 在 [天猫 978199812185](https://detail.tmall.com/item.htm?id=978199812185&skuId=6245616343131)。图纸仓 [装配 BOM](https://github.com/fanhao375/microduck-replica-cad#装配-bom) 里也有。

> ⚠️ **`bearing_roll` 不是轴承，也不是采购件。** MJCF 里还有一个出现 2 次的网格叫
> `bearing_roll`，实测是 **23 × 3 × 40 mm、带 Ø≈18 中心孔的平板**（体积 625 mm³，填充率 23%），
> 且与 `trunk_base` / `yaw2roll` / 外壳出自**同一个 Onshape Part Studio**
> （elementId `d6fcdccc8b25aaa256e7e213`），而两颗真轴承在另一个带配置串的标准件库里。
> 它是 hip_roll 轴那颗 Ø22 轴承的**压盖**，**要打印，不用买**。见 [打印件](#四打印件)。

---

## 二、紧固件（M2 系统，约 325 件）

整机 M2 级孔（Ø1.9–2.5 mm、包角 ≥300°）**按装配体用量加权共 237 个**：
60 个在舵机本体上（15 × 4）、21 个在轴承/PCB/电池等标准件上、结构件上约 156 个。
下面按 325 件给，对 237 个孔位有 **1.37×** 余量。

| 规格 | 建议数量 | 用途 |
|---|---|---|
| M2×4 内六角圆柱头 | 60 | 薄壁位 |
| **M2×6 内六角圆柱头** | **80**（主力） | |
| M2×8 内六角圆柱头 | 40 | 孔深 3–5 mm |
| M2×12 内六角圆柱头 | 15 | 少量深孔 |
| M2 螺母 | 50 | 无攻丝处 |
| **M2 热熔螺母** | **60** | 打印件推荐，比直接攻丝牢得多 |
| M2.5×6 | 20 | 少量 Ø2.7 孔位 |

推导过程见 [紧固件反推](紧固件反推.md)。

### 螺丝套装

| 店铺 | 说明 | 价格 | 销量 | 链接 |
|---|---|---|---|---|
| **广州信邦电子**（10年老店，包邮） | **600 pcs** 盒装不锈钢 沉/平头内六角 **M2/M2.5/M3** 组合，**送扳手** | **¥26.8** | 42 | [taobao 842110292995](https://item.taobao.com/item.htm?id=842110292995) |
| 宏顺通五金工厂店（8年老店） | 600 pcs M2/M2.5/M3 沉头内六角 + 螺母 + 送工具 | ¥23 | 2 | [taobao 842400332284](https://item.taobao.com/item.htm?id=842400332284) |
| 广州信邦电子（10年老店，包邮） | 304 不锈钢 M2–M8 盘头内六角 + 螺母 + 垫片套装 | ¥19.8 | 71 | [taobao 888186264852](https://item.taobao.com/item.htm?id=888186264852) |

**机械行者Robo 实际买的**（2026-09-16）：M2×5 / M2×6 / M2.5×6 都在 [天猫 637524754721](https://detail.tmall.com/item.htm?id=637524754721) 按规格选 SKU。

> 💡 **优先选写明含 M2 的套装。** 很多「M2M3M4M5M6M8 大全」标题里带 M2，实际最小只到 M3 ——
> 下单前看清 SKU。本项目 **M2 是绝对主力**，M3 基本用不上。

### 热熔螺母 + 压头

| 店铺 | 说明 | 价格 | 销量 | 链接 |
|---|---|---|---|---|
| **深圳市榕誉微电子**（6年老店） | **400 PCS M2 + M3** 热熔铜螺母，双通道滚花 | **¥22** | 200+ | [taobao 1000673642588](https://item.taobao.com/item.htm?id=1000673642588) |
| 深圳市榕誉微电子（6年老店） | 80/220 PCS M2–M6 热熔铜螺母 | ¥18 | 1000+ | [taobao 922318148975](https://item.taobao.com/item.htm?id=922318148975) |
| 天卓五金官方旗舰店（包邮） | 土八热熔螺母 M1–M8，按规格散买 | ¥0.77 起 | 4万+ | [tmall 809364062256](https://detail.tmall.com/item.htm?id=809364062256) |

> ⚠️ **别忘了压头。** 热熔螺母要用**专用烙铁压头**压入，普通烙铁头压不正、会歪。

| 店铺 | 说明 | 价格 | 销量 | 链接 |
|---|---|---|---|---|
| **烙铁工具**（7年老店） | 3D 热熔螺母压头套件 M2–M8，适用 **936 / T12 / T65** | **¥13** | 800+ | [taobao 902798112263](https://item.taobao.com/item.htm?id=902798112263) |
| 外茂优品（包邮） | 同类 M2–M8 压头套件 | ¥11.5 | 200+ | [taobao 966212633086](https://item.taobao.com/item.htm?id=966212633086) |

### 螺纹胶（金属对金属螺丝位防松）

舵机输出轴、金属件对接处建议上中强度螺纹胶。

| 店铺 | 说明 | 价格 | 销量 | 链接 |
|---|---|---|---|---|
| **LOCTITE 乐泰旗舰店** | 汉高乐泰 **243** 中强度可拆卸螺纹锁固剂 | **¥19.11** | 1万+ | [tmall 653848839737](https://detail.tmall.com/item.htm?id=653848839737) |
| LOCTITE 乐泰企业店 | 243 / 263 螺纹锁固剂 | ¥18.4 | 700+ | [taobao 663963768247](https://item.taobao.com/item.htm?id=663963768247) |
| 工业胶厂家直销（包邮） | 乐泰 243 / 242 / 263 | ¥16.8 | 600+ | [taobao 925965306702](https://item.taobao.com/item.htm?id=925965306702) |

> ⚠️ **低于 ¥15 的要当心。** 搜索结果里有 ¥8、¥10 的「乐泰 243」，正品不会到这个价。
> 认准 LOCTITE 官方店或授权经销商。

---

## 三、耗材

| 材料 | 用量 | 用在哪 |
|---|---|---|
| **PLA / PETG** | 约 300–500 g | 绝大部分结构件 |
| **TPU** | 少量 | `jaw_soft_软下巴`、`soft_mouth_top_软嘴顶部` —— 从命名和用途判断建议软料 |

> 打印工艺与公差评估尚未做，见 [PROGRESS.md](../PROGRESS.md) 风险清单。
> **仿真 STL ≠ 可打印工程件** —— 只保证外形与惯量，没有配合公差、螺纹孔、热熔螺母座。

---

## 四、打印件

**最新模型、材料与打印数量统一查看 [CAD 仓库](https://github.com/fanhao375/microduck-replica-cad#装配-bom)，不要按上游仿真引用数下单。** 两款舵机的配合件不同，详见[打印入口](../print/README.md)。

<details>
<summary>历史上游模型计数与命名勘误（仅供分析，不是当前打印清单）</summary>

**30 种 / 41 件。**

**旧模型有 9 种网格被多次引用：**

| 零件 | 旧模型引用数 |
|---|---|
| `leg_腿部` | **×4** |
| `hip_l_髋部左` | ×2 |
| `neck_颈部` | ×2 |
| `power_support_电源支架` | ×2 |
| `sole_left_左脚底` | ×2 |
| `sole_right_右脚底` | ×2 |
| `upper_leg_rigidity_plate_上腿加固板` | ×2 |
| `yaw2roll_偏航转横滚` | ×2 |
| **`bearing_roll_横滚轴承压盖`** | **×2** ← 见下方勘误 |
| 其余 21 种 | 各 ×1 |

> ⚠️ **勘误（2026-09-04）**：`bearing_roll` 此前被本仓库归入「标准件-无需打印」，**这是错的**。
> 判据：① 实测 23×3×40 mm 平板、带 Ø≈18 中心孔，不是任何标准轴承的形状（真轴承是回转体）；
> ② 与 `trunk_base` / `yaw2roll` / 外壳出自同一个 Onshape Part Studio；
> ③ 装配上与 `yaw2roll` 同 body、同位置，是贴在其侧面的一块盖板。
> 中译「轴承滚轮」也错了 —— 它既不是轴承也不是滚轮，已改为「横滚轴承压盖」。
> 打印件计数因此从 29 种 / 39 件更正为 **30 种 / 41 件**。

⚠️ **别搞混左右**：`upper_leg_left` 与 `upper_leg_right` 是镜像件
（质心 **±0.006766 m ＝ ±6.77 mm**），两个都要打；
`ankle_left`/`ankle_right`、`sole_left`/`sole_right`、`foot_left`/`foot_right` 同理。

---

</details>

## 五、不用买的（官方模型里但属于其它类别）

| 网格 | 是什么 | 怎么办 |
|---|---|---|
| `xl330` ×15 | 舵机 | 见 [执行器选型](执行器选型.md) |
| `np_f970` | NP-F 电池（**实为 F550**） | 见 [电控采购清单](电控采购清单.md#五电源) |
| `elec_rpi_robot_hat_pcb` | HAT 电路板 | 打样，见 [电控采购清单](电控采购清单.md#六两块-pcb) |
| `pcb__raspberry_pi_zero_2_w` | 主控板占位 | 买 Radxa Zero 3W |
| `lens` / `m12_lens_holder` | 镜头与镜头座 | ⚠️ 两者出自同一个 Onshape Part Studio，<br>本仓库把 `lens` 归标准件、`m12_lens_holder` 归打印件，**这个分法存疑**，待实物复核 |
| `speaker` | 喇叭 | 5W，接 HAT 的 Wago 端子 |

---

## 未验证项

- 全部价格、销量、店铺信息与链接有效性（2026-09-04 快照）
- 螺丝长度按孔深推算，**是区间不是实测值**；FDM 打印收缩还会改变实际孔径
  （Ø2.2 通常偏小 0.1–0.3 mm）
- TPU 件的判断来自命名与用途，官方未标注材料
- `lens` / `m12_lens_holder` 的采购/打印归属
