yoyojacky/microduck-replica/software/training/src/mjlab_microduck/robot/microduck/assets/seeed_bearing__configuration__22x16x4.stl

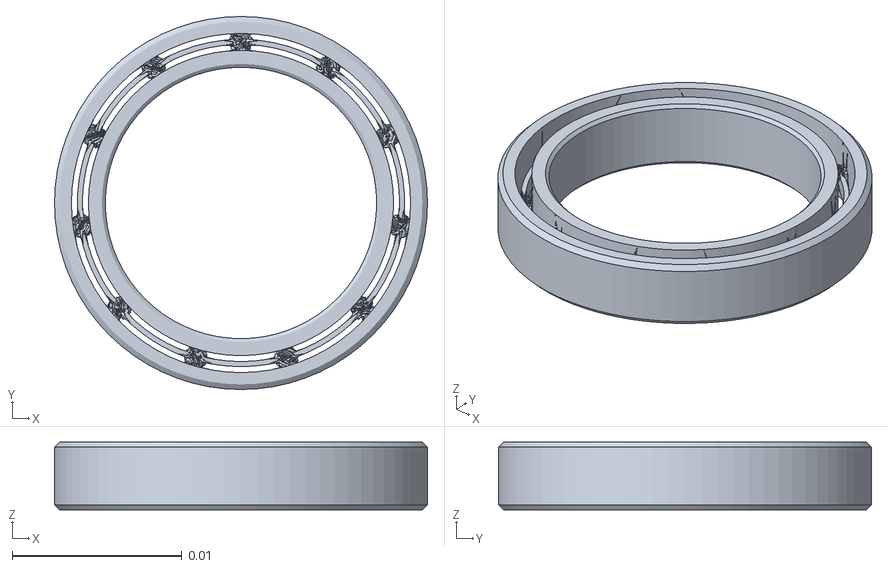
[picture p5: CAD file, 2026-10-03]
software/training/src/mjlab_microduck/robot/microduck/assets/seeed_bearing__configuration__22x16x4.stl
0.022 x 0.022 x 0.004
