yoyojacky/microduck-replica/software/training/src/mjlab_microduck/robot/microduck/assets/rim.stl

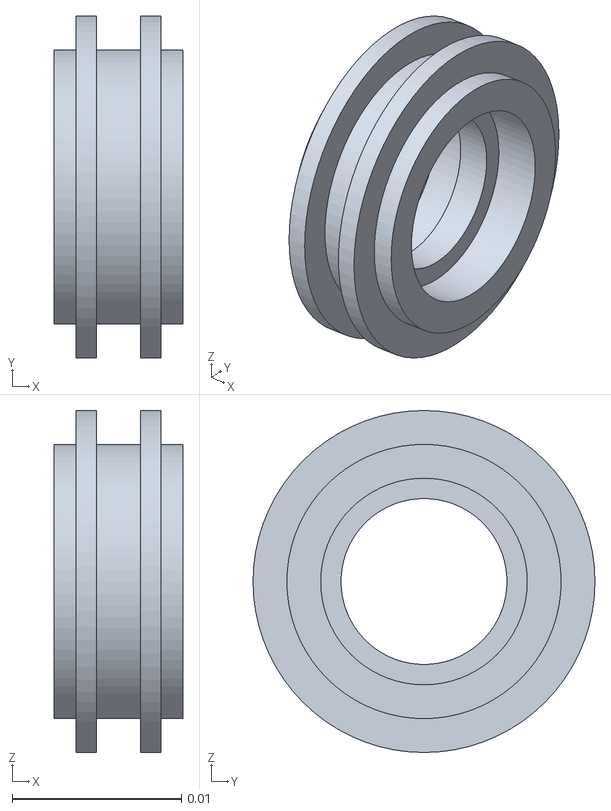
[picture p7: CAD file, 2026-10-03]
software/training/src/mjlab_microduck/robot/microduck/assets/rim.stl
0.0076 x 0.0202 x 0.0202
