yoyojacky/microduck-replica/software/training/src/mjlab_microduck/robot/microduck/assets/top_head_shell.stl

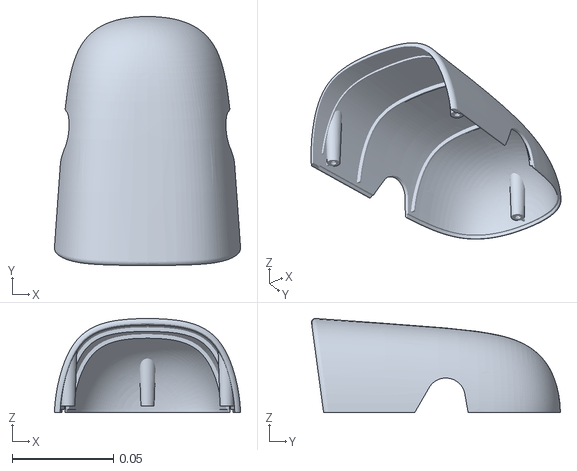
[picture p8: CAD file, 2026-10-03]
software/training/src/mjlab_microduck/robot/microduck/assets/top_head_shell.stl
0.0918 x 0.123 x 0.0463
