yoyojacky/microduck-replica/software/training/src/mjlab_microduck/robot/xl330_test_bench/assets/spacer.stl

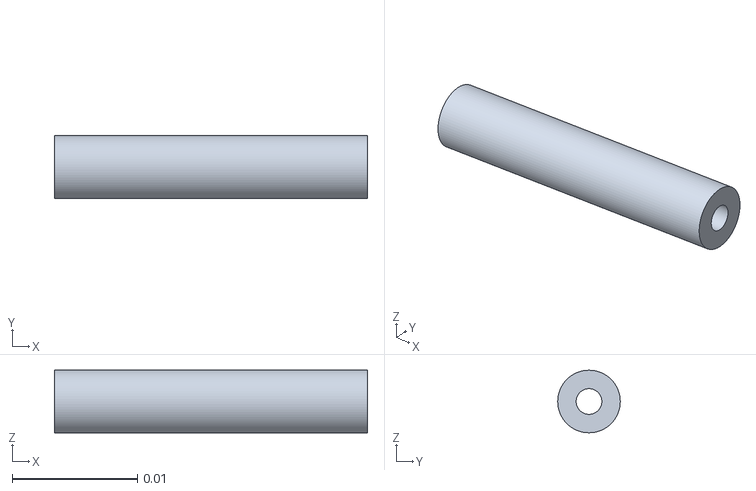
[picture p9: CAD file, 2026-10-03]
software/training/src/mjlab_microduck/robot/xl330_test_bench/assets/spacer.stl
0.025 x 0.005 x 0.005
