yoyojacky/microduck-replica/software/training/src/mjlab_microduck/robot/microduck/assets/sole_right.stl

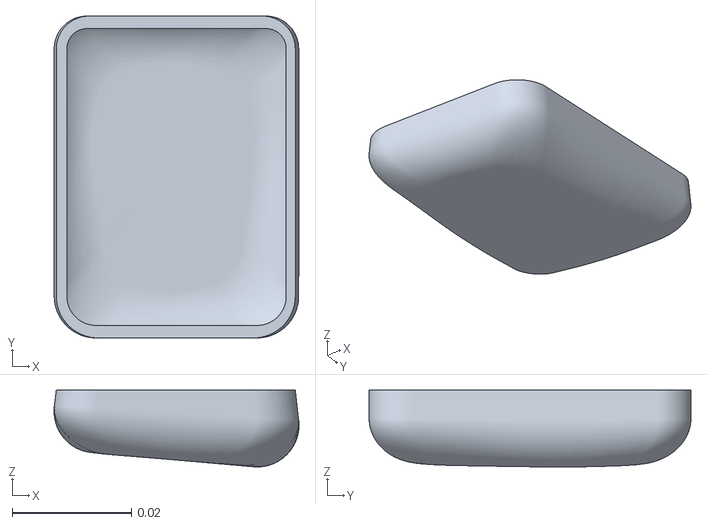
[picture p10: CAD file, 2026-10-03]
software/training/src/mjlab_microduck/robot/microduck/assets/sole_right.stl
0.0411 x 0.054 x 0.0129
