yoyojacky/microduck-replica/software/training/src/mjlab_microduck/robot/xl330_test_bench/assets/xl330.stl

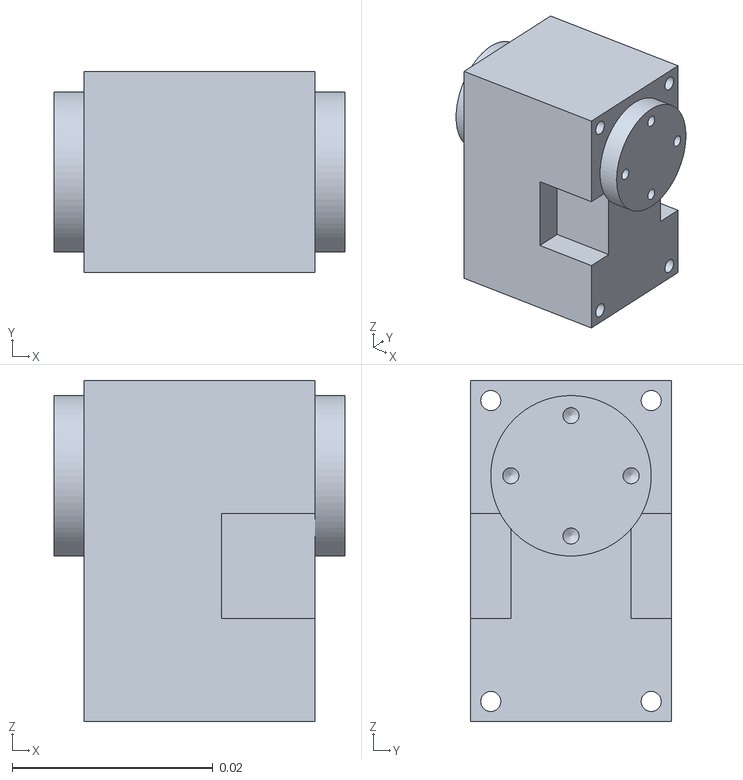
[picture p11: CAD file, 2026-10-03]
software/training/src/mjlab_microduck/robot/xl330_test_bench/assets/xl330.stl
0.029 x 0.02 x 0.034
