yoyojacky/microduck-replica/software/training/src/mjlab_microduck/robot/microduck/assets/jaw_soft.stl

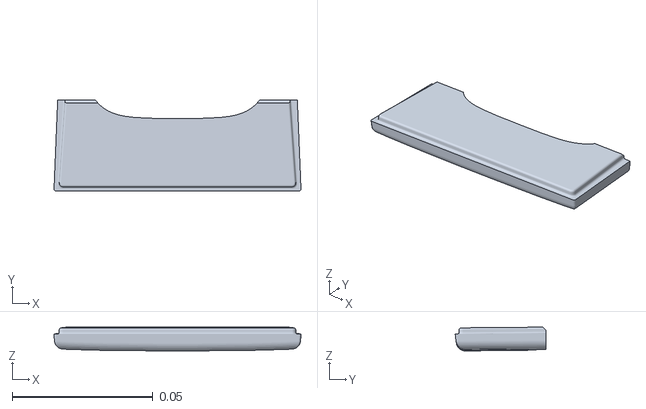
[picture p12: CAD file, 2026-10-03]
software/training/src/mjlab_microduck/robot/microduck/assets/jaw_soft.stl
0.0877 x 0.0322 x 0.00844
