yoyojacky/microduck-replica/software/training/src/mjlab_microduck/robot/xl330_test_bench/assets/weight.stl

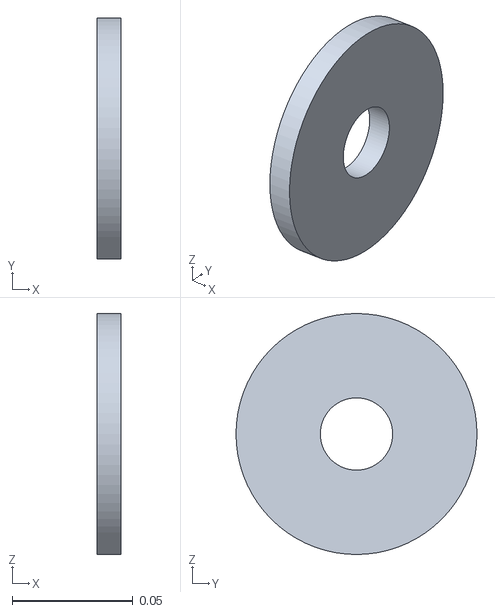
[picture p13: CAD file, 2026-10-03]
software/training/src/mjlab_microduck/robot/xl330_test_bench/assets/weight.stl
0.01 x 0.1 x 0.1
