yoyojacky/microduck-replica/software/training/src/mjlab_microduck/robot/microduck/assets/left_shell.stl

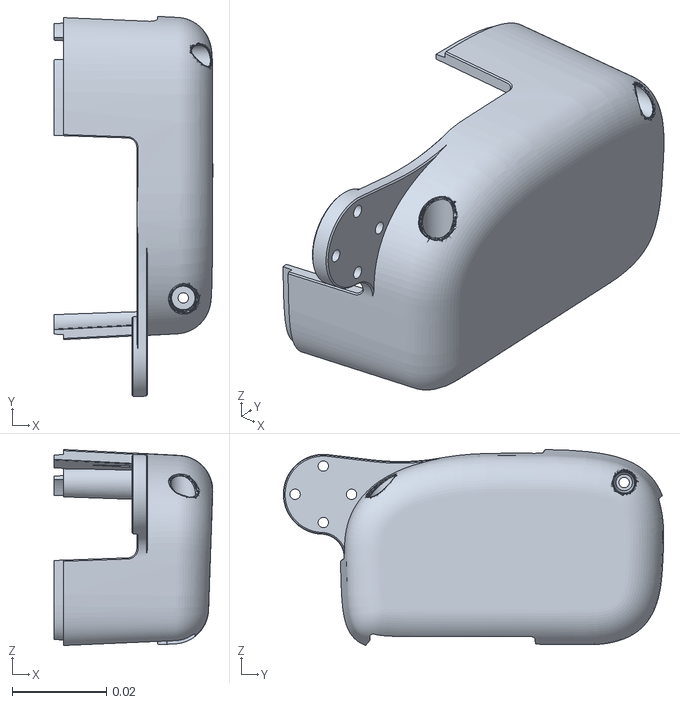
[picture p14: CAD file, 2026-10-03]
software/training/src/mjlab_microduck/robot/microduck/assets/left_shell.stl
0.0337 x 0.0809 x 0.0417
