yoyojacky/microduck-replica/software/training/src/mjlab_microduck/robot/xl330_test_bench/assets/axis.stl

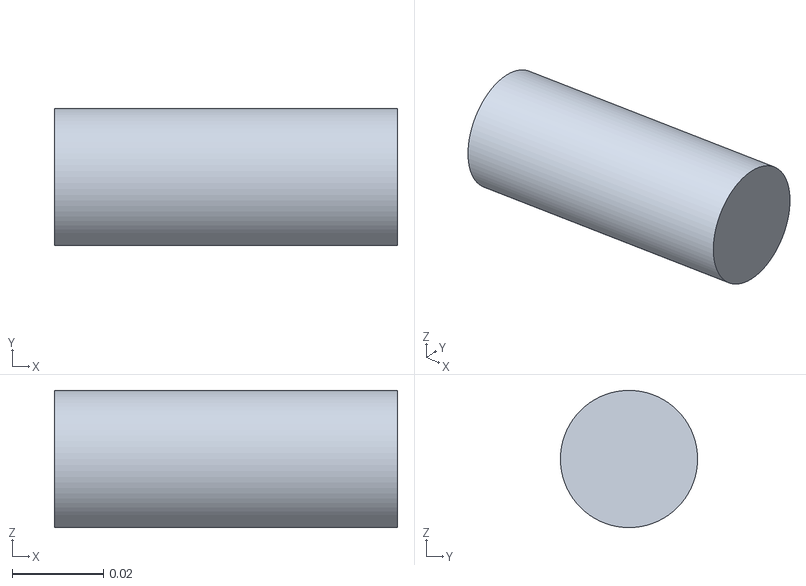
[picture p15: CAD file, 2026-10-03]
software/training/src/mjlab_microduck/robot/xl330_test_bench/assets/axis.stl
0.075 x 0.03 x 0.03
