yoyojacky/microduck-replica/software/training/src/mjlab_microduck/robot/microduck/assets/bottom_head_shell.stl

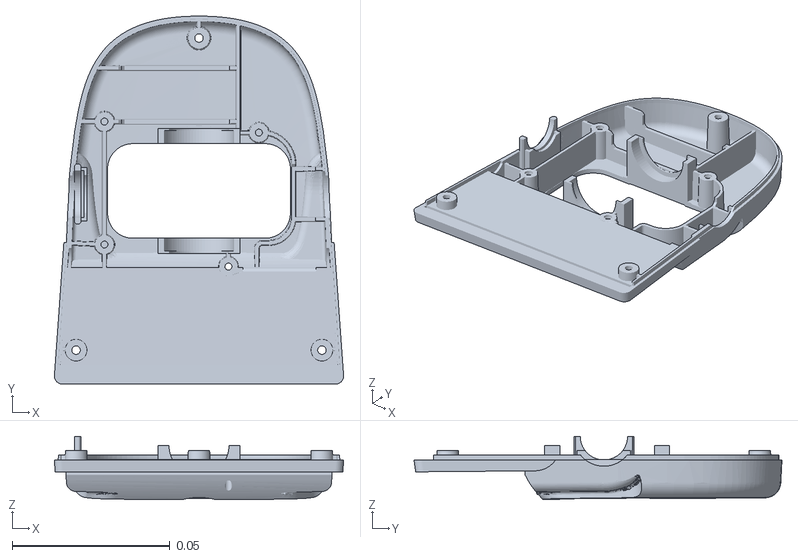
[picture p16: CAD file, 2026-10-03]
software/training/src/mjlab_microduck/robot/microduck/assets/bottom_head_shell.stl
0.0918 x 0.117 x 0.0201
