yoyojacky/microduck-replica/software/training/src/mjlab_microduck/robot/microduck/assets/speaker.stl

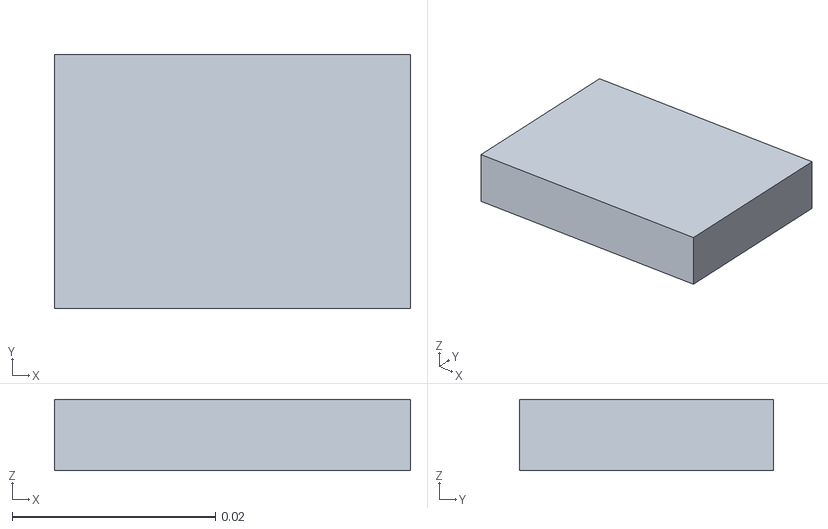
[picture p18: CAD file, 2026-10-03]
software/training/src/mjlab_microduck/robot/microduck/assets/speaker.stl
0.035 x 0.025 x 0.007
