yoyojacky/microduck-replica/software/training/src/mjlab_microduck/robot/xl330_test_bench/assets/bench_holder.stl

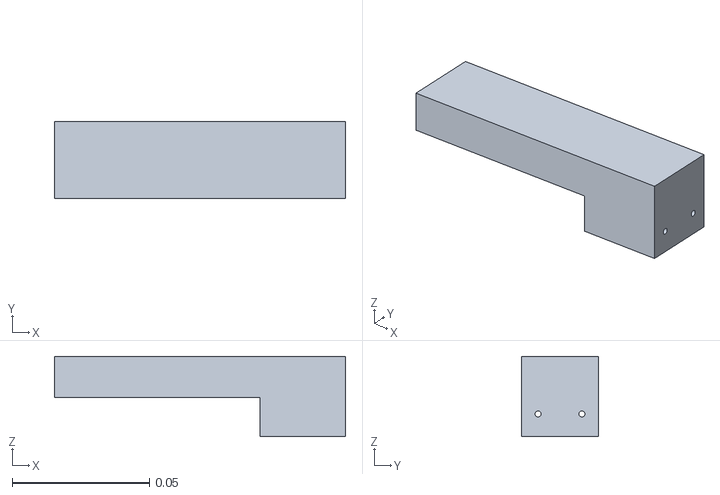
[picture p19: CAD file, 2026-10-03]
software/training/src/mjlab_microduck/robot/xl330_test_bench/assets/bench_holder.stl
0.106 x 0.0282 x 0.0292
