yoyojacky/microduck-replica/software/training/src/mjlab_microduck/robot/microduck/assets/ankle_r_v1.stl

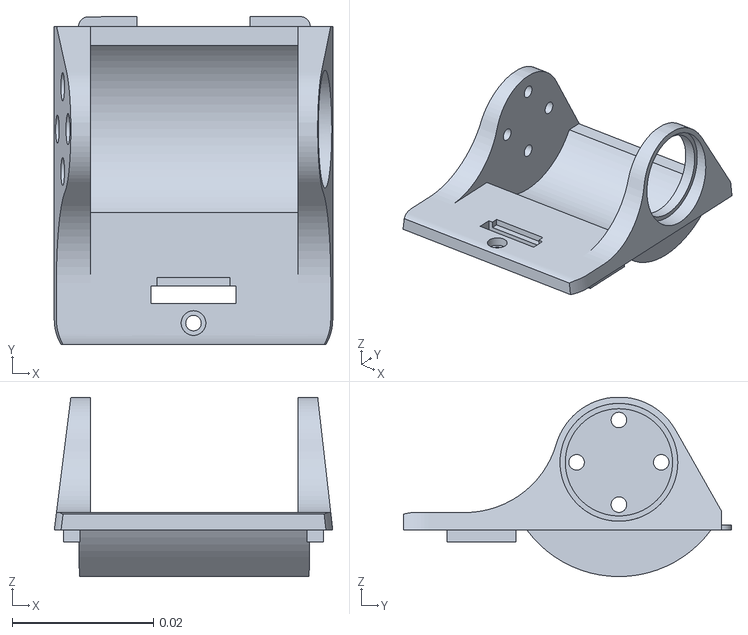
[picture p20: CAD file, 2026-10-03]
software/training/src/mjlab_microduck/robot/microduck/assets/ankle_r_v1.stl
0.0395 x 0.0465 x 0.0254
