yoyojacky/microduck-replica/software/training/src/mjlab_microduck/robot/microduck/assets/jaw.stl

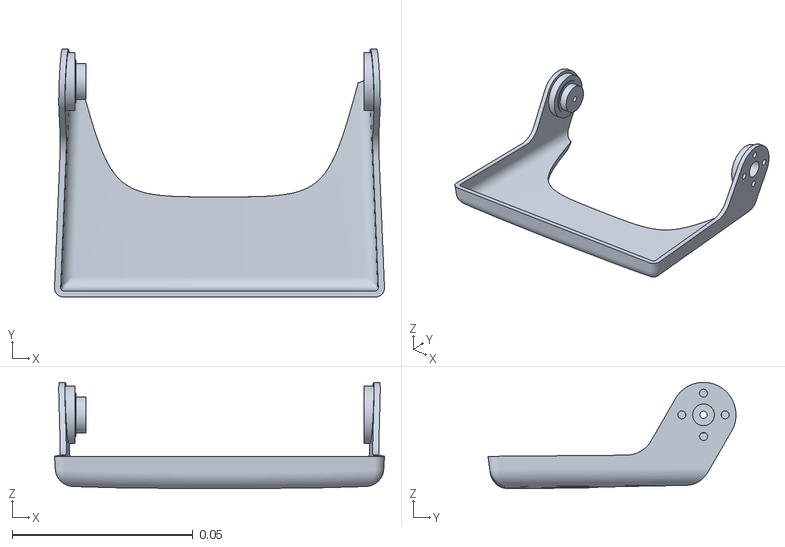
[picture p21: CAD file, 2026-10-03]
software/training/src/mjlab_microduck/robot/microduck/assets/jaw.stl
0.0914 x 0.0687 x 0.0294
