yoyojacky/microduck-replica/software/training/src/mjlab_microduck/robot/microduck/assets/ankle_right.stl

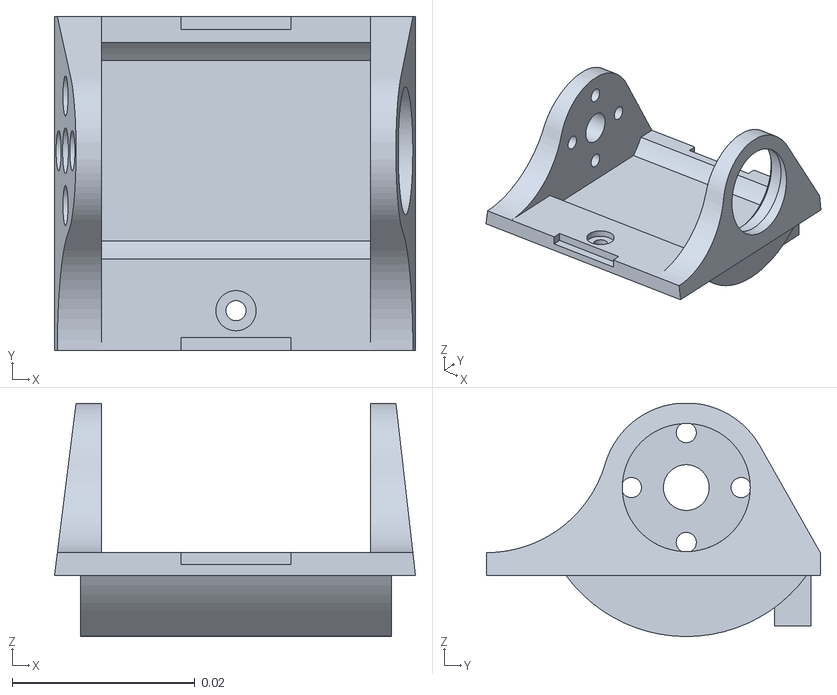
[picture p22: CAD file, 2026-10-03]
software/training/src/mjlab_microduck/robot/microduck/assets/ankle_right.stl
0.0395 x 0.0365 x 0.0255
