yoyojacky/microduck-replica/software/training/src/mjlab_microduck/robot/microduck/assets/seeed_bearing__configuration_default.stl

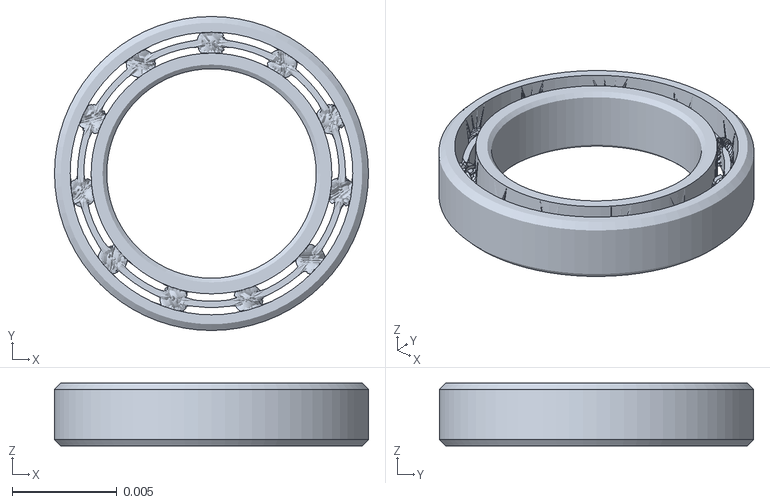
[picture p24: CAD file, 2026-10-03]
software/training/src/mjlab_microduck/robot/microduck/assets/seeed_bearing__configuration_default.stl
0.015 x 0.015 x 0.003
