yoyojacky/microduck-replica/software/training/src/mjlab_microduck/robot/microduck/assets/leg.stl

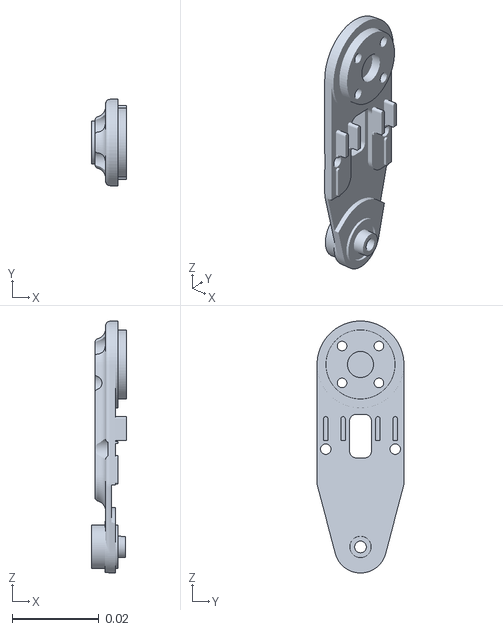
[picture p25: CAD file, 2026-10-03]
software/training/src/mjlab_microduck/robot/microduck/assets/leg.stl
0.00795 x 0.02 x 0.058
