yoyojacky/microduck-replica/software/training/src/mjlab_microduck/robot/microduck/assets/neck_pitch.stl

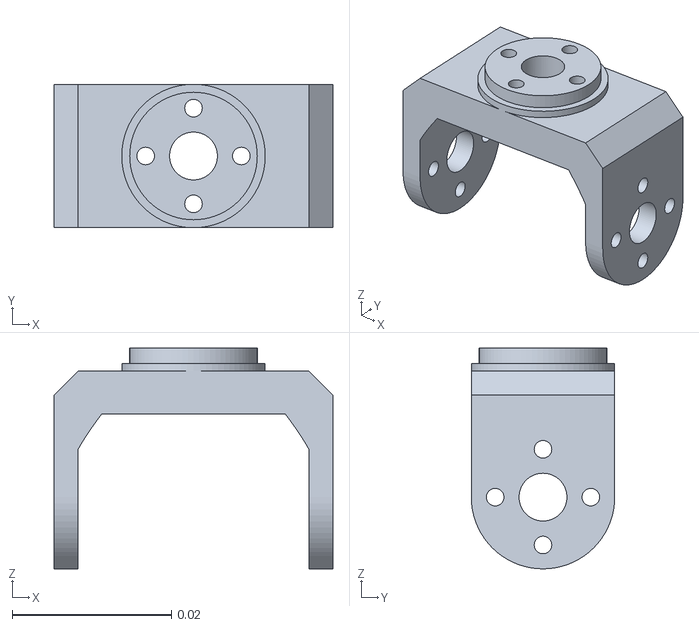
[picture p26: CAD file, 2026-10-03]
software/training/src/mjlab_microduck/robot/microduck/assets/neck_pitch.stl
0.035 x 0.018 x 0.0277
