yoyojacky/microduck-replica/software/training/src/mjlab_microduck/robot/microduck/assets/hip_l.stl

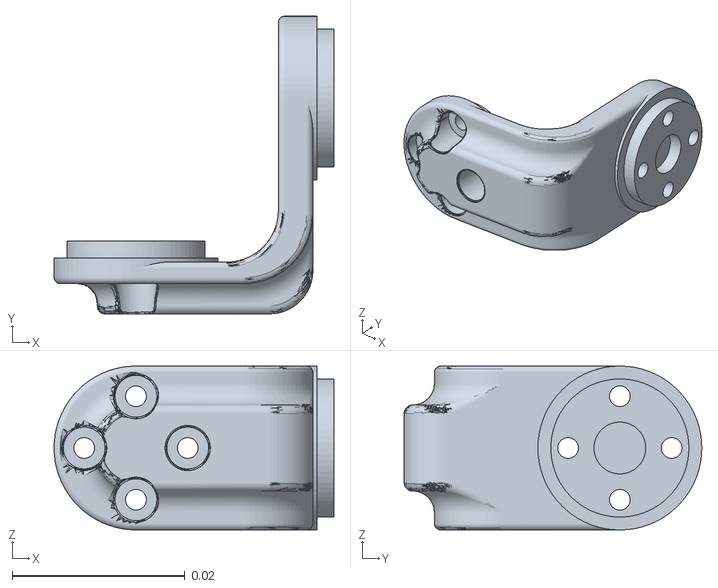
[picture p27: CAD file, 2026-10-03]
software/training/src/mjlab_microduck/robot/microduck/assets/hip_l.stl
0.0325 x 0.0345 x 0.019
