yoyojacky/microduck-replica/software/training/src/mjlab_microduck/robot/microduck/assets/power_support.stl

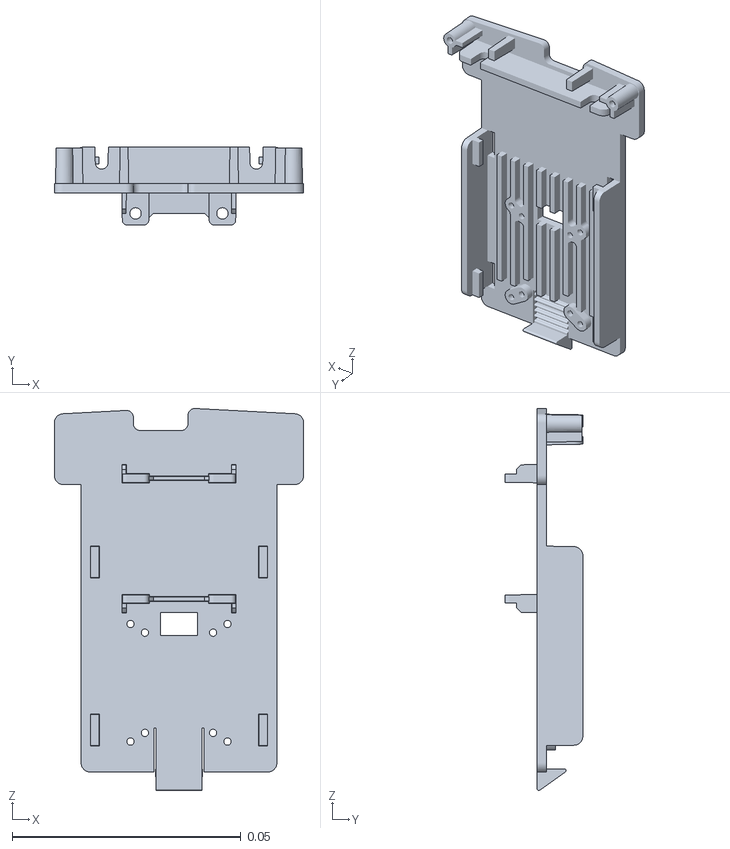
[picture p28: CAD file, 2026-10-03]
software/training/src/mjlab_microduck/robot/microduck/assets/power_support.stl
0.0545 x 0.017 x 0.0835
