yoyojacky/microduck-replica/software/training/src/mjlab_microduck/robot/microduck/assets/trunk_base.stl

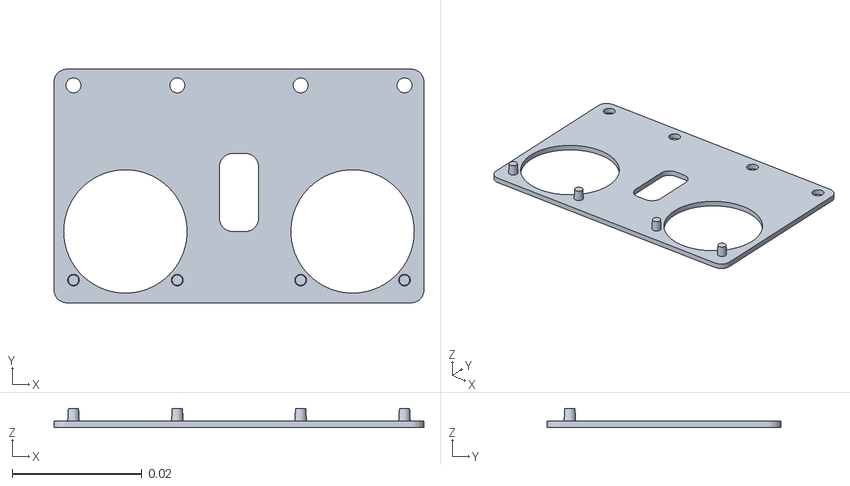
[picture p29: CAD file, 2026-10-03]
software/training/src/mjlab_microduck/robot/microduck/assets/trunk_base.stl
0.057 x 0.036 x 0.003
