yoyojacky/microduck-replica/software/training/src/mjlab_microduck/robot/microduck/assets/soft_mouth_top.stl

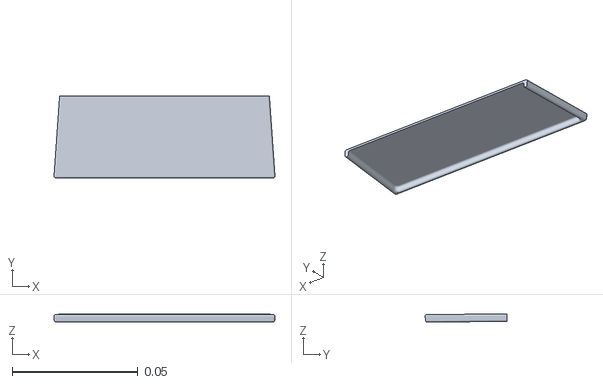
[picture p30: CAD file, 2026-10-03]
software/training/src/mjlab_microduck/robot/microduck/assets/soft_mouth_top.stl
0.0878 x 0.0326 x 0.00328
