yoyojacky/microduck-replica/software/training/src/mjlab_microduck/robot/microduck/assets/noenoeil.stl

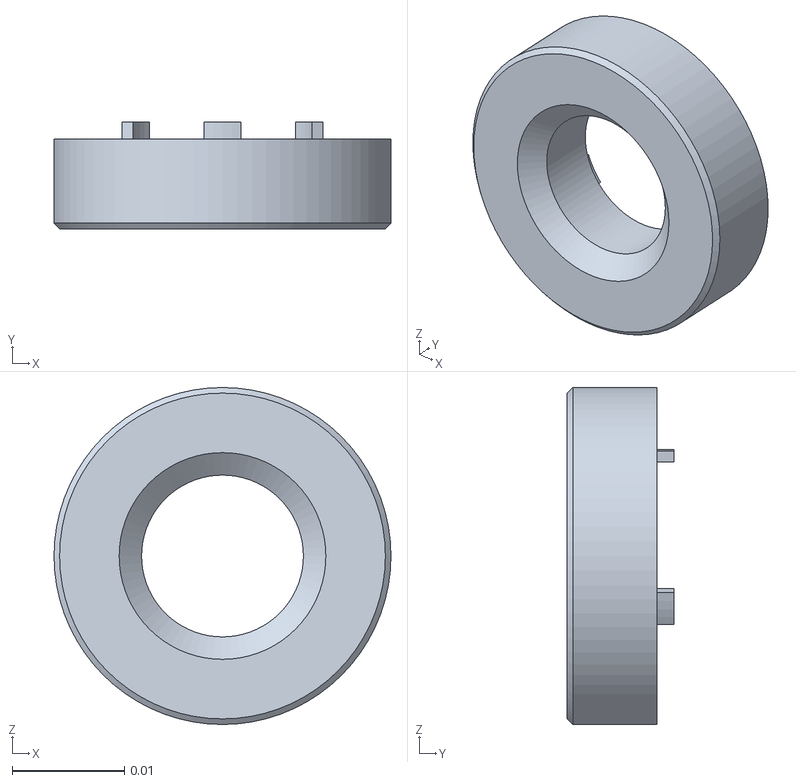
[picture p31: CAD file, 2026-10-03]
software/training/src/mjlab_microduck/robot/microduck/assets/noenoeil.stl
0.03 x 0.0095 x 0.03
