yoyojacky/microduck-replica/software/training/src/mjlab_microduck/robot/microduck/assets/trunk_shell_right.stl

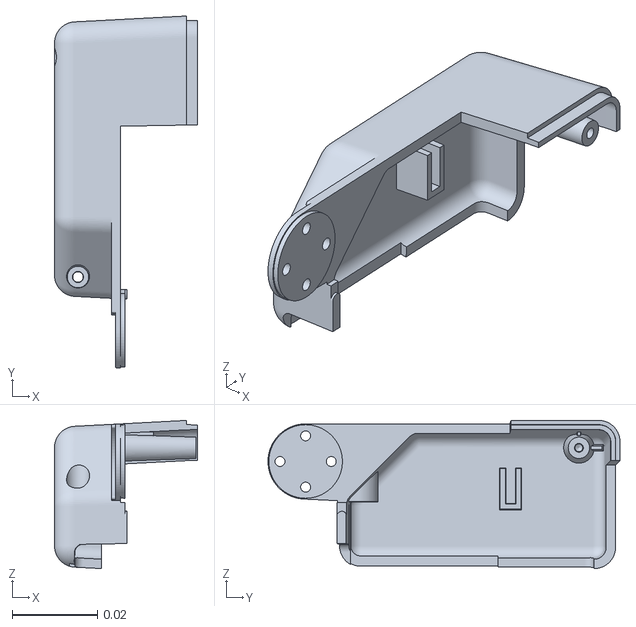
[picture p33: CAD file, 2026-10-03]
software/training/src/mjlab_microduck/robot/microduck/assets/trunk_shell_right.stl
0.0335 x 0.0824 x 0.0347
