yoyojacky/microduck-replica/software/training/src/mjlab_microduck/robot/microduck/assets/trunk_shell_left.stl

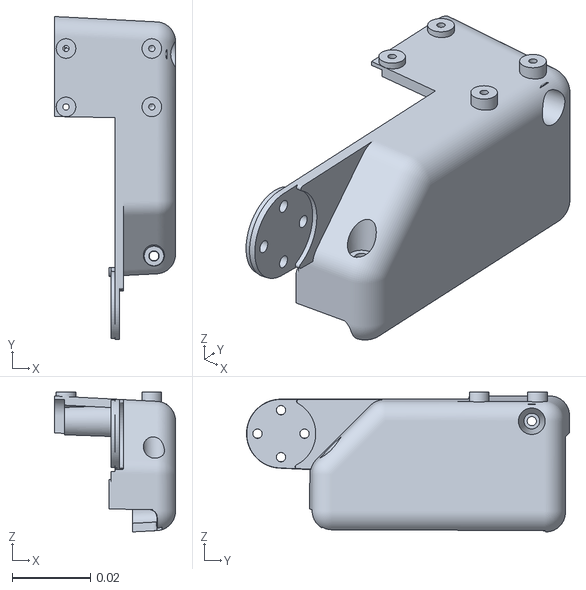
[picture p34: CAD file, 2026-10-03]
software/training/src/mjlab_microduck/robot/microduck/assets/trunk_shell_left.stl
0.0309 x 0.0824 x 0.0357
