yoyojacky/microduck-replica/software/training/src/mjlab_microduck/robot/microduck/assets/yaw2roll.stl

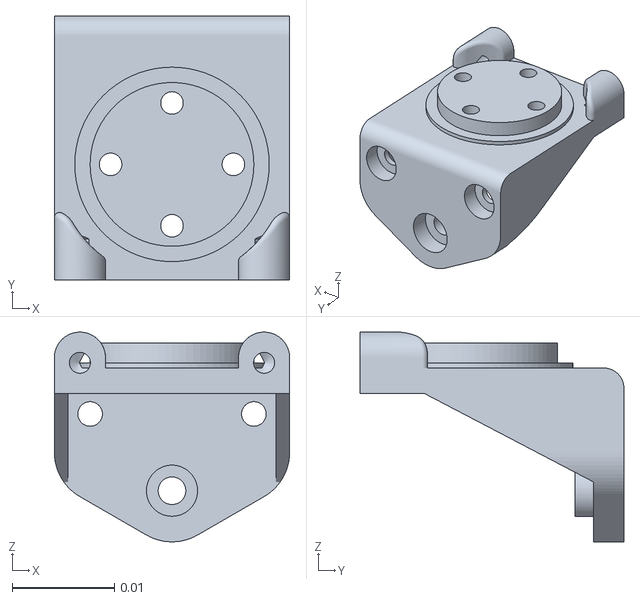
[picture p35: CAD file, 2026-10-03]
software/training/src/mjlab_microduck/robot/microduck/assets/yaw2roll.stl
0.023 x 0.0258 x 0.0205
