yoyojacky/microduck-replica/software/training/src/mjlab_microduck/robot/microduck/assets/foot_right.stl

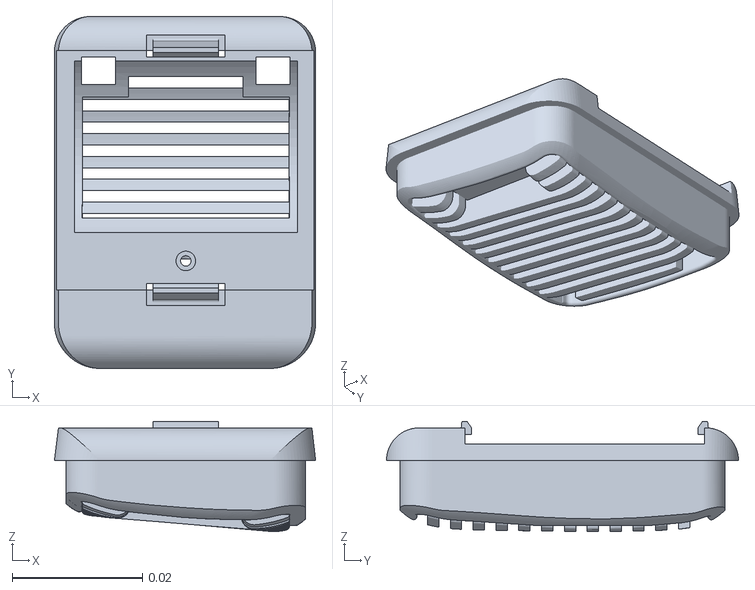
[picture p36: CAD file, 2026-10-03]
software/training/src/mjlab_microduck/robot/microduck/assets/foot_right.stl
0.0401 x 0.054 x 0.0169
