yoyojacky/microduck-replica/software/training/src/mjlab_microduck/robot/microduck/assets/lens.stl

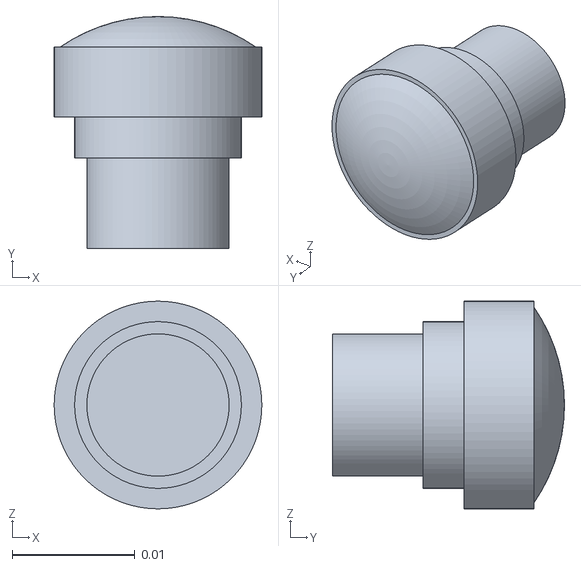
[picture p37: CAD file, 2026-10-03]
software/training/src/mjlab_microduck/robot/microduck/assets/lens.stl
0.0169 x 0.0189 x 0.0169
