yoyojacky/microduck-replica/software/training/src/mjlab_microduck/robot/microduck/assets/motor_support.stl

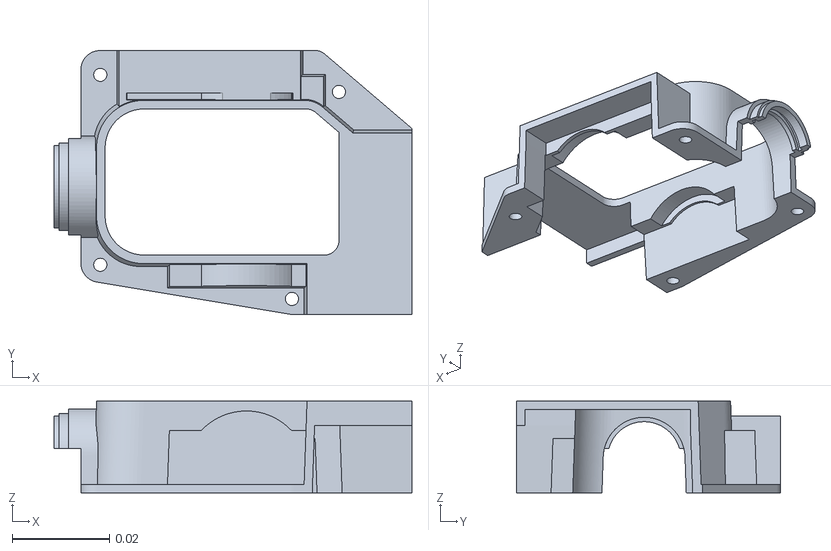
[picture p38: CAD file, 2026-10-03]
software/training/src/mjlab_microduck/robot/microduck/assets/motor_support.stl
0.0735 x 0.0542 x 0.0188
