yoyojacky/microduck-replica/software/training/src/mjlab_microduck/robot/microduck/assets/upper_leg_rigidity_plate.stl

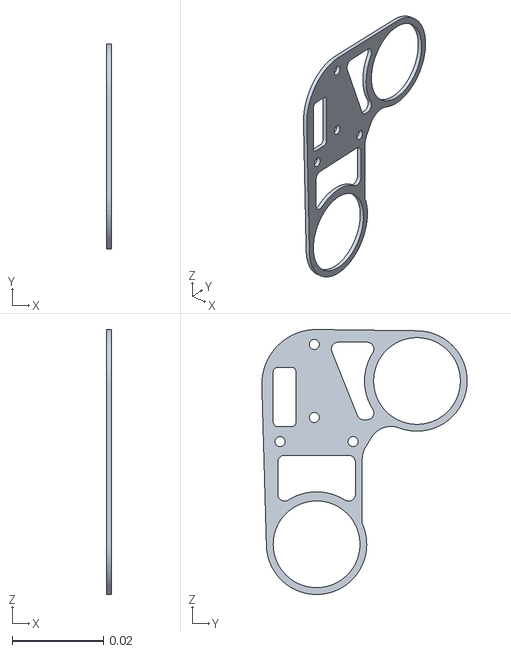
[picture p39: CAD file, 2026-10-03]
software/training/src/mjlab_microduck/robot/microduck/assets/upper_leg_rigidity_plate.stl
0.001 x 0.045 x 0.0581
