yoyojacky/microduck-replica/software/training/src/mjlab_microduck/robot/microduck/assets/face_part.stl

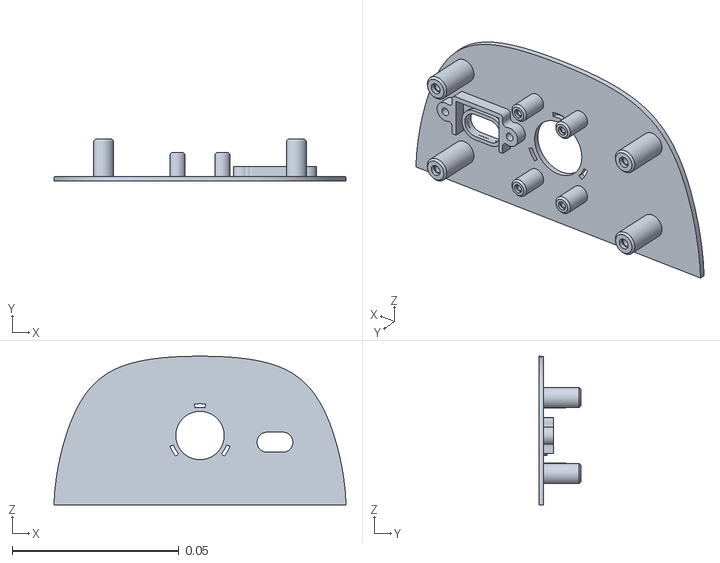
[picture p41: CAD file, 2026-10-03]
software/training/src/mjlab_microduck/robot/microduck/assets/face_part.stl
0.0877 x 0.0125 x 0.0446
