yoyojacky/microduck-replica/software/training/src/mjlab_microduck/robot/microduck/assets/bearing_roll.stl

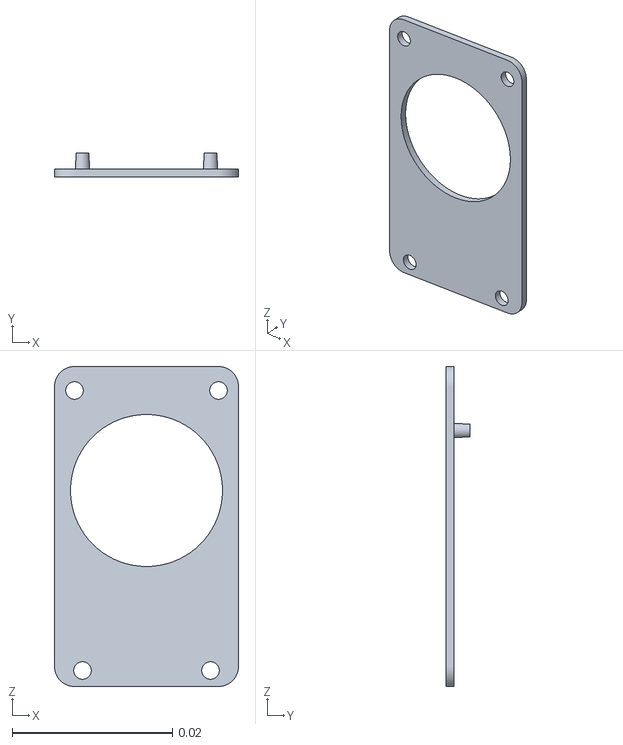
[picture p44: CAD file, 2026-10-03]
software/training/src/mjlab_microduck/robot/microduck/assets/bearing_roll.stl
0.023 x 0.003 x 0.04
