yoyojacky/microduck-replica/software/training/src/mjlab_microduck/robot/microduck/assets/tire.stl

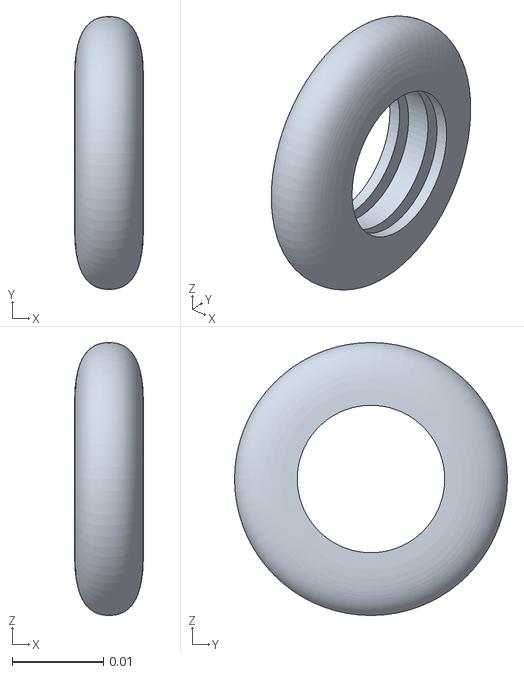
[picture p45: CAD file, 2026-10-03]
software/training/src/mjlab_microduck/robot/microduck/assets/tire.stl
0.0076 x 0.03 x 0.03
