yoyojacky/microduck-replica/software/training/src/mjlab_microduck/robot/microduck/assets/yaw_roll_motion.stl

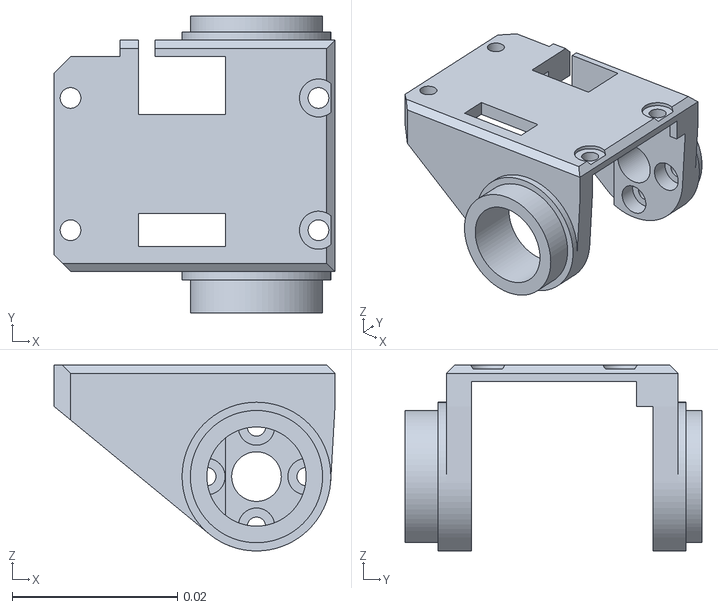
[picture p46: CAD file, 2026-10-03]
software/training/src/mjlab_microduck/robot/microduck/assets/yaw_roll_motion.stl
0.034 x 0.0359 x 0.0225
