yoyojacky/microduck-replica/software/training/src/mjlab_microduck/robot/microduck/assets/m12_lens_holder.stl

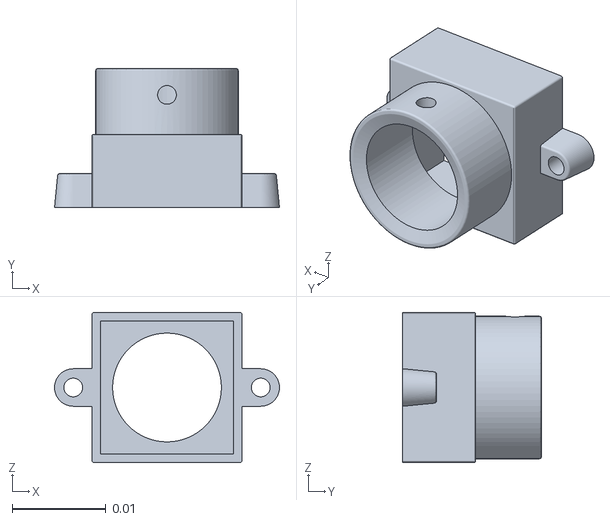
[picture p47: CAD file, 2026-10-03]
software/training/src/mjlab_microduck/robot/microduck/assets/m12_lens_holder.stl
0.024 x 0.0148 x 0.016
