yoyojacky/microduck-replica/(list of files, cad)

Other CAD files:
software/training/src/mjlab_microduck/robot/microduck/assets/upper_leg_left.stl
software/training/src/mjlab_microduck/robot/microduck/assets/ankle_l_v1.stl
software/training/src/mjlab_microduck/robot/microduck/assets/left_upper_leg.stl
software/training/src/mjlab_microduck/robot/microduck/assets/ankle_left.stl
software/training/src/mjlab_microduck/robot/microduck/assets/sole_left.stl
software/training/src/mjlab_microduck/robot/microduck/assets/foot_left.stl
software/training/src/mjlab_microduck/robot/microduck/assets/upper_leg_right.stl
