yoyojacky/microduck-replica/调试记录.md

# 调试记录

**简体中文**

> **当前状态：HAT 已到货并与主板对插；当前运行瑞莎官方 B1，Wi-Fi / SSH 正常，调整摄像头排线后已采集到 1920×1080 画面。**
> 最后更新：2026-09-28。当前官方系统用于摄像头对照，尚未恢复项目运行时；原 Armbian 在正确接线下尚未复测。

[构建日志](构建日志.md) 记的是**机械**：打印、试装、公差。
这份记的是**电气与软件**：先是**一步一步的操作手册**（拿到货怎么配、怎么接、怎么测），下面是**按日期的过程**（做了什么、看到什么、下一步是什么）。

结论性的坑单独整理在 [踩坑记录](踩坑记录.md)。板子和芯片是什么、为什么这么选，在 [硬件入门](docs/硬件入门.md)。

---

## 进度

| 日期 | 阶段 | 状态 | 备注 |
|---|---|---|---|
| 2026-09-10 | 舵机 + 调试板到货 | ⚠️ 遇到问题 | 调试板 TTL 口跟舵机 2.0 mm 线不匹配 |
| 2026-09-12 | 主控、ToF、电池、电池仓、SD 卡、排针、摄像头到齐 | ✅ 完成 | 排针已焊到 Radxa 上 |
| 2026-09-12 | 舵机装机械件 | ✅ 完成 | **HD-1910 跟 XL330 有结构差异**，改件重打后可适配 |
| 2026-09-13 | 15 颗配 ID | ✅ 完成 | 用剪开的舵机线飞到 URT-2，一颗颗配 |
| 2026-09-13 | 台架通总线（URT-2 ↔ Radxa） | 🔨 进行中 | 电源 7.4V 进 URT-2，USB 进 Radxa host 口 |
| 2026-09-16 | 主控裸板上电 | ✅ 完成 | 无异常 |
| 2026-09-16 | 主控刷机（2G 板 / microSD） | ❌→✅ | Armbian 官方镜像在 V1.12 板上起不来（引导程序），换瑞莎引导后 09-17 起来，见下 |
| 2026-09-17 | 官方脚本 setup-board / migrate-network / install | ✅ 完成 | ttyS2、NetworkManager、ONNX Runtime、daemon 0.13.0 |
| 2026-09-17 | 整机 15 颗上总线（URT-2 ↔ 电脑） | ✅ 完成 | 0 超时 0 校验错，15 颗同步读 4.8 ms；卡了一小时的是 URT-2 上电顺序 |
| 2026-09-17 | 网页调试台 `tools/servo-web/` | ✅ 完成 | 滑块、姿态、序列、3D 跟随、重心显示、寄存器导出 |
| 2026-09-18 | 校零、站姿、缩起来 ↔ 站起来序列 | 🔨 进行中 | 能自己站起来坐下（[视频](assets/首次上电-2026-09-18.mp4)）；零位还有 4 颗要重校，方向反的 4 颗用页面 ± 翻 |
| 2026-09-17 | `imu_to_dxl` 板到货、上电 | ✅ 完成 | 3.3 V 正常。J4/J5 座子间距对但**外壳跟飞特线不匹配**，削掉外壳能插，v2 换座 |
| 2026-09-22 | `imu_to_dxl` 飞特协议固件 0.2.0 | ✅ 桌面验证 / ⚠️ 真总线待测 | 已烧入开发板，IMU 工作；验收边界见[固件说明](hardware/imu_to_dxl/firmware/) |
| 2026-09-28 | HAT 到货、对插与主板上电调试 | 🔨 进行中 | 按主板 → 摄像头逐项检查；不是 HAT 音频、舵机总线及负载验收 |
| 2026-09-28 | 损坏 ID 21 的替换与校中位 | ✅ 用户确认 | 原嘴 ID 34 舵机改作 ID 21，用户用 FD 确认 2048 校准成功；嘴暂缺 |
| 2026-09-28 | 官方 B1 镜像对照 | ✅ 完成 | Wi-Fi / SSH 已实测，启用 Radxa Camera 8M overlay |
| 2026-09-28 | 摄像头识别与出图 | ✅ 短时采集通过 | 调整排线后读到 `0x0219`，40 帧 1920×1080；持续帧率与项目集成待测 |
| — | 不打 HAT 飞线接主控 | 📋 备用方案 | 当前先走已到货的 HAT，飞线文档保留 |

图例：📋 计划中 · 🔨 进行中 · ✅ 完成 · ⚠️ 遇到问题 · ❌ 此路不通

---

## 手头有的

| 东西 | 数量 | 状态 |
|---|---|---|
| 飞特 HD-1910-C001 | 原购 15 | 原 ID 21 损坏，嘴 ID 34 挪作 ID 21；当前嘴暂缺，不能沿用“15 颗全在线”作为现状 |
| 飞特 FE-URT-2 调试板 | 1 | ✅ 到货 2026-09-10 |
| Radxa Zero 3W 2 GB（裸板，无 eMMC） | 1 | ✅ 到货 2026-09-12，**排针已焊** |
| Radxa Zero 3W 8 GB + 64 GB eMMC | 1 | 📦 月底 |
| NP-F550 电池 + 电池仓 | — | ✅ 到货 2026-09-12 |
| VL53L8CX ToF | 1 | ✅ 到货 2026-09-12 |
| Radxa Camera 8M219（IMX219） | 1 | ✅ 官方 B1 下识别并出图，2026-09-28 |
| RPI Robot HAT | 1 | ✅ 已到货、已对插；各外设功能逐项调试 |
| 高耐久 microSD | — | ✅ 到货 2026-09-12 |
| 2×20 排针 | — | ✅ 到货并焊上 |
| `imu_to_dxl` PCB + SMT | 5 | ✅ 到货 2026-09-17，¥629.72；上电 3.3 V 正常，连接器封装有问题 |
| 读卡器、5 V 降压模块 | — | ✅ 到货 2026-09-16 |
| 转接线、半双工转接板 | — | 📋 待买（台架先用 URT-2 顶） |

---

## 飞特资料在哪

本地 `飞特-HD1910/` 只有规格书 PDF、DWG、STP。**软件和手册在 Gitee，不在官网**：

| 要什么 | 在哪 |
|---|---|
| **FD 调试软件** + **CH340 驱动** | **仓库里就有：[`tools/飞特/`](tools/飞特/)**（FD 1.9.8.5 + 驱动，MIT，带 sha256）。原始出处 [gitee.com/ftservo/fddebug](https://gitee.com/ftservo/fddebug) |
| 例程 / 通信协议 / 内存表 | [gitee.com/ftservo](https://gitee.com/ftservo) 各仓库 |
| 官网软件页（备用） | [feetech.cn/software.html](https://www.feetech.cn/software.html) |
| 入手教程 PDF | [先看这里-入手教程](https://www.feetech.cn/Data/feetechrc/upload/file/20220618/%E5%85%88%E7%9C%8B%E8%BF%99%E9%87%8C-%E5%85%A5%E6%89%8B%E6%95%99%E7%A8%8B2-1.pdf) |

---

## 舵机配置 · 拿到货一步一步做

**目标**：15 颗 HD-1910 每颗设好 ID、打开保护、贴上标签，装机时拿起来就知道它是哪个关节。

### 需要什么

| 东西 | 说明 |
|---|---|
| HD-1910-C001 × 15 | 出厂 ID **全是 1** |
| FE-URT-2 调试板 + USB-C 线 | 用左边两个白色 3 针口（丝印 `TTL-Bus`，`G V1 S`）。右边 4 针是 RS485，不用 |
| 一根剪开的舵机线 | 调试板的口跟舵机 2.0 mm 线**插不上**，得飞线。15 根牺牲一根 |
| 电源 | 三选一，见第 3 步。**只配 ID 的话 USB 就够** |
| 软件 | [`tools/飞特/`](tools/飞特/)：FD 1.9.8.5 + CH340 驱动，Windows |
| 万用表 | 量电压、查线序 |
| 标签纸 + 笔 | 第 7 步用 |

### 第 1 步 · 装软件

```
1  插上 URT-2 → 设备管理器「端口」里出现 USB-Enhanced-SERIAL CH343 (COMx)，记下号
   URT-2 是 CH343，Win10/11 自带驱动，不用装。没出现才装 tools/飞特/CH340_URT.rar（老款 URT-1 用）
2  解压 tools/飞特/FD1.9.8.5(250729).7z → 直接运行，不用安装
```

### 第 2 步 · 飞线

剪一根舵机线，一头是 2.0 插头、另一头三根裸线。**认脚号，别认颜色**：

```
舵机线                       URT-2
脚 1  Signal / TTL    →    S     焊到板背面白口 S 脚的焊点上（临时：线头镀锡后插进白口 S 孔）
脚 2  Vcc             →    V1    蓝色接线端子
脚 3  GND             →    G     蓝色接线端子
```

- **中间那根一定是 V**，飞特和 Dynamixel 在这点上一致 —— V 放错才会烧
- S 和 G 接反了**不会烧**，只是搜不到，对调即可
- 脚 1 在插头上有小三角或缺口标记，或看舵机本体插座旁丝印

### 第 3 步 · 供电

**URT-2 上那个拨码是 TTL 信号电平（3.3 / 5 V）选择，不是供电切换。** 拨 5 V（HD-1910 认 2–5 V，余量大）。
USB 插上时 V1 端子上有 5 V（实测 2026-09-12）。2026-09-17 查了厂家资料：URT-2 有两个接线端子，**V1 是 TTL 总线的外接电源输入，标称 DC 4.8–12 V**；V2 是 RS485 的，DC 12–24 V。URT-1 说明书的接线照片就是 USB 和外接电源同时接的。既然规格允许 12 V 进 V1，V1 和 USB 5 V 之间就不可能是直通，应该是二极管隔离，USB 单独插时才把 5 V 送到 V1。所以两种接法都行：

| 用什么 | 怎么接 | 什么时候用 |
|---|---|---|
| **USB 5 V** | 什么都不接，V1 自带 5 V | **配 ID、改参数**。HD-1910 从 4 V 起工作，空载够 |
| 可调开关电源 / 电池 → **V1 端子** | + 进 V1、− 进 G，舵机线直接插 TTL-Bus 口。厂家标准接法 | 15 颗一起，台架 |
| 可调开关电源 / 电池 → 舵机 | + 直接接舵机 V，− 接舵机 G **和** URT-2 的 G（共地），V1 空着 | 不想让电流过 URT-2 的端子和走线时（15 颗堵转能到十几安，端子标 6 A） |

⚠️ 别超 8.4 V，那是 HD-1910 的上限，不是 URT-2 的。

⚠️ **上电顺序：先插 USB，再给舵机上电。** 反了总线会被压在 2.1 V，一颗都不应答，见[踩坑记录 · 工具](踩坑记录.md#工具)。

**别在满电 8.4 V 的电池上做堵转测试** —— 那是 HD-1910 电压上限，零余量。

### 第 4 步 · 搜舵机

```
1  FD 里选第 1 步记下的 COM 口
2  波特率 1000000
3  点「打开」
4  只接一颗舵机（飞好线那根）
5  点「搜索」→ 列表里出现 ID 1，型号 HD-1910
```

搜不到，按顺序查：驱动装没装 → COM 口选对没 → 波特率是不是 1000000 → S 线接触好不好（临时插孔的最可疑）→ S/G 是不是反了。

### 第 5 步 · 改参数

切到「编程」页（EPROM）。**每颗都改这几项，别的别动：**

| 参数 | 出厂 | 改成 | 为什么 |
|---|---|---|---|
| **ID** | 1 | **按下表** | 官方运行时按这个 ID 找关节 |
| **过流保护** | 关 | **开** | 装机后堵转是常事，不开就是烧舵机 |
| **过压保护** | 关 | **开** | 8.4 V 满电落在 4–10 V 窗口内，不会误触发 |
| 过热保护 | 开（80 ℃） | 不动 | — |
| 波特率 | 1 Mbps | 不动 | 出厂就是官方要的 |
| 运行模式 | 模式 4 纯位置 PD | 不动 | 正是强化学习落地要的那个 |
| Return delay | 0 | 不动 | STS 系列上这项不起作用 |
| 中位 | — | **装机时再校** | 整机装完用调试台按官方折叠校（见第 9 步前「缩着能不能当标定基准」一节）。FD 的「中位校准」只会把当前位置当 2048，只能在腿伸直时用 |

改完点「保存」。

**ID 对照表** —— 来自上游 `duck-control/src/model.rs`，注释说数值是「对着硬件量出来的」：

| ID | 关节 | ID | 关节 | ID | 关节 |
|---|---|---|---|---|---|
| **10** | 右髋 yaw | **20** | 左髋 yaw | **30** | 颈俯仰 |
| **11** | 右髋 roll | **21** | 左髋 roll | **31** | 头俯仰 |
| **12** | 右髋 pitch | **22** | 左髋 pitch | **32** | 头 yaw |
| **13** | 右膝 | **23** | 左膝 | **33** | 头 roll |
| **14** | 右踝 | **24** | 左踝 | **34** | 嘴 |

**记法**：十位 = 部位（1 右腿 · 2 左腿 · 3 颈头），个位 = 从躯干往末端数（0 髋 yaw → 4 踝）。
ID 200 是 `imu_to_dxl` 板，固件里写死，不在这里配。

> 本机临时状态（2026-09-28）：原嘴 ID 34 的舵机已挪作 ID 21，用户确认 FD 中位校准到 2048；嘴位置暂缺。上表仍是设计 ID 分配，后续恢复总线前先核对实际在线 ID，不能直接按历史 15 颗全部在线启动动作。

### 第 6 步 · 验证

```
1  断电（拔 USB 或关电源）
2  重新上电
3  再点「搜索」→ 新 ID 出现了才算写进去了
```

这步别省，EPROM 参数要断电重启才确定。

### 第 7 步 · 贴标签，下一颗

标签写**关节名 + ID**（比如「左膝 23」），别只写数字。15 颗长得一模一样。
拔掉，换下一颗，回第 4 步。一颗约两分钟。

### 第 8 步 · 看它转（可选）

搜到舵机后在主页面点它，拉位置滑杆它就跟着转。USB 5 V 空载能转但没力；接了 7.4 V 才是真实工况。

### 2026-09-17 · 第一次整机上总线，记一个「缩起来」姿态

URT-2 + 网页调试台（`tools/servo-web/`）第一次把装好的鸭子 15 颗全读通：0 超时 0 校验错，7.2 V，30–40 °C。校零后扭矩全关、鸭子躺着让关节自然垂到底，读到的就是它「缩起来」的姿态，存在 `tools/servo-web/poses/缩起来-2026-09-17.json`：

| ID | 关节 | 舵机值 | 相对零位 |
|---|---|---|---|
| 20 | left_hip_yaw | 2084 | +3.2° |
| 21 | left_hip_roll | 1997 | -4.5° |
| 22 | left_hip_pitch | 772 | -112.1° |
| 23 | left_knee | 1058 | -87.0° |
| 24 | left_ankle | 2247 | +17.5° |
| 30 | neck_pitch | 1473 | -50.5° |
| 31 | head_pitch | 1094 | -83.8° |
| 32 | head_yaw | 2059 | +1.0° |
| 33 | head_roll | 2012 | -3.2° |
| 34 | mouth | 2047 | -0.1° |
| 10 | right_hip_yaw | 2018 | -2.6° |
| 11 | right_hip_roll | 2109 | +5.4° |
| 12 | right_hip_pitch | 3195 | +100.8° |
| 13 | right_knee | 3032 | +86.5° |
| 14 | right_ankle | 1782 | -23.4° |

看得出来的两件事：左右腿的髋 pitch、膝是镜像的（左 −112° / −87°，右 +101° / +87°），跟 MJCF 里左右腿正方向相反的约定一致；颈 −50°、头 −84° 是头垂到胸前。这套数以后可以当"收纳姿态"直接发。

### 2026-09-18 · 从缩起来到站姿怎么动（官方模型正解）

用 `tools/servo-web/model/model.json`（微调过的官方 MJCF）做正解，条件：脚底前后不倾、脚底点前后位置跟官方站姿一样。结果是一条直线：**髋 = −26° + 膝/2，踝 = +26° + 膝/2**（左腿；右腿全部反号，模型约定）。腿太短（大腿 42 mm、小腿 49 mm），膝弯到 +60° 躯干也只降 3 cm。

| 膝（模型约定） | 髋 | 踝 | 躯干比站姿 |
|---|---|---|---|
| −60° | −56° | −4° | 高 10 mm |
| 0° | −26° | +26° | 0（官方站姿） |
| +30° | −10° | +40° | 低 16 mm |
| +60° | +6° | +54° | 低 33 mm |

**重心（用官方 robot_walk.xml 的质量）**：整机 744 g，脚底在脚 site 前 34 mm、后 20 mm。站姿时重心投影离脚尖 34 mm、离脚跟 20 mm；半蹲（膝 +60）到站姿整条路余量都在 17 mm 以上；头颈每 10° 重心只挪 2.4 mm；髋每多前倾 5°（踝反向 5° 保持脚平）脚往前挪、脚尖余量 +5 mm。按模型，慢慢站不该往前倒，真机倒了先查零位偏差（右髋 27°、左踝 28°）和电池装没装。页面 3D 里现在实时画重心投影（绿点 + 虚线）和两脚支撑区，出了支撑区变红，右下角报四个方向的余量。

**真机方向跟模型不一样的关节要用页面上的 ± 翻**：2026-09-18 对着缩起来的照片核，膝（23、13）、颈 pitch（30）、头 pitch（31）是反的，踝待验。序列文件里写的是模型约定的相对角度，页面发之前按 ± 换算。

从缩起来（髋 −112 / 膝 −87 / 踝 +17）站起来的顺序，做成了页面上的序列「站起来」（`poses/站起来-序列.json`）：

1. 抬头 1 s：颈、头 pitch 到 +20°。头占整机三分之一重量，趁身子还坐在桌上先摆到站姿位置。
2. 展腿脚放平 3 s：以实机站姿为基准，膝 +60 / 髋 +30 / 踝 +30（模型约定，左腿；右腿反号）。脚从身后翻到身下踩住桌面，身体被顶起约 9 cm，这一步最关键，第一次托着做。
3. 站直 2 s：沿脚平那条线到官方站姿。三个角同时线性变，脚全程平，身高只涨 10 mm。

页面加了「过渡时间」：所有姿态、站姿、回零位都从当前实际位置线性插过去，20 Hz 发同步写，不再一下跳。前提是舵机方向跟模型一致（待查 8），先单颗试 22 号往负方向是不是大腿往前抬。

### 2026-09-22 · 缩着能不能当标定基准（官方模型精确网格求交）

群里的讨论：官方零位是腿伸直，悬空手扶着摆没有参考点，一两度就摔；能不能拿缩着当基准。用官方模型把每个腿关节往折叠方向转到零件碰上（fcl 精确网格，不用凸包，[`tools/fold_contact`](tools/fold_contact/)）：

- 顶住关节的**都是脚和踝**，不是关节自己的限位，所以停在哪跟别的关节有关：膝在髋 0° 时 70.7° 碰上，髋 90° 时 89.6° 碰上
- **踝缩着时没被定住**，膝和髋都折到底后还有约 20° 能动，缩着校不了踝
- 官方 FOLD（髋、膝 ±90°）的膝几乎就是接触点，1.57 rad（89.95°）会让踝顶进大腿舵机约 0.36°（接触在 89.59°）；9/20 存的「缩」左膝换算约 88°，跟这个接触点对得上
- FOLD 的颈 / 头 pitch 是 57°，**不是接触点**：腿折好后颈要转到 66.6° 颈舵机才碰上躯干外壳，57° 前后都空着
- 这是 XL330 原版几何，飞特版改过 8 个件，要拿飞特版模型再算或在 SolidWorks 里量

分析结论：缩着只能当髋、膝的参考，而且摆法要写死。零点仍然是官方的 2048，官方代码和策略不用加补偿 —— 缩着只是参考点，不是新零点。

**最后定的做法**（调试台 0.14.0 起的基准「官方折叠（头颈摆正）」，0.15.0 按审查修过）：

- 腿按官方 FOLD 摆：膝折到踝刚贴上大腿舵机（零件顶住，每次都一样），髋 pitch 用直角尺摆到跟躯干垂直，髋 yaw / roll、踝 0°
- 头颈不按官方 FOLD 的 57°（不是接触点、靠眼睛摆不准），改成摆正：脖子竖直、头平视，嘴闭上
- **15 颗一起标**，扭矩关着用手摆。目标：± 全 −1 时 22 / 23 = 1025、12 / 13 = 3071，其余 2048；写进舵机 EEPROM（0x0B 带目标值 = 「当前位置就是这个读数」），零点照样是官方的 2048
- 膝按官方 1.57 rad 算，实际摆到接触点 89.59°，零点差约 0.36°（4 步），忽略
- 确认框逐颗列「现在 → 写成、差几度」；差 30° 以上再确认一次，**不拦**：装舵盘时转了半圈会差 180°，校准正好纠回来；方向 ± 设反了也差 180° 左右，那样校进去是错的，先用手掰一下看 3D 转向核 ±
- 校完扭矩还是关着，用手展开再开扭矩不会跳（0.15.0 起开扭矩前先把目标对准当前位置）

### 第 9 步 · 装机、归零、试行程

**零点是什么**：机器人**笔直站立**的姿态 —— 腿是直的柱子、脚平放、脖子竖直、头平视。这是 MJCF 里所有关节 = 0 的位置，对应舵机 **2048**。

**站姿不是零点。** 官方站立姿态（`DEFAULT_POSITION`）是从零点加的偏移：髋 pitch ±26°、踝 ∓26°、颈和头 pitch +20°。这是软件的事，**别把站姿校成 2048**。

**每个关节的做法**：

```
1  舵机 FD 里先转到 2048，再装舵盘（舵盘齿位对不准就近，误差归下一步）
2  把关节摆到「直」的位置，用手扶着
3  FD 编程页 →「中位校准」→ 当前位置定义为 2048（或 `tools/servo-web/` 网页调试台的「中位校准」按钮，装好以后用手扶直再点，同一个指令）
4  锁紧螺丝
5  FD 从 2048 慢慢拉到下表的上下限，看结构件碰不碰、线扯不扯
6  碰了记下那颗的实际角度 —— 比软件限位小是正常的，那才是这台机器的真实行程
```

**行程表** —— 来自 MJCF `robot_walk.xml` 的 `range`，这是**软件限位**，机械上能不能到要试。HD-1910 是 4096 步 / 360°，1° ≈ 11.4 步：

| ID | 关节 | 行程 | 舵机值（2048 为零） |
|---|---|---|---|
| 10 / 20 | 髋 yaw | 右 −30 ~ +25°　左 −25 ~ +30° | 右 1707 ~ 2332　左 1764 ~ 2389 |
| 11 / 21 | 髋 roll | ±22° | 1798 ~ 2298 |
| 12 / 22 | 髋 pitch | ±90° | 1024 ~ 3072 |
| 13 / 23 | 膝 | ±90° | 1024 ~ 3072 |
| 14 / 24 | 踝 | ±90° | 1024 ~ 3072 |
| 30 | 颈 pitch | −90 ~ +60° | 1024 ~ 2731 |
| 31 | 头 pitch | ±90° | 1024 ~ 3072 |
| 32 | 头 yaw | ±170° | 114 ~ 3982 |
| 33 | 头 roll | ±25° | 1764 ~ 2332 |
| 34 | 嘴 | −5°（闭）~ +30°（开） | 1991 ~ 2389 |

髋 yaw 左右不对称是镜像 —— 两条腿往外转 30°、往内转 25°。嘴不在 MJCF 里（策略不控制它），范围来自 `model.rs` 的 `MOUTH_CLOSED / MOUTH_OPEN`。

⚠️ **正负方向哪边是哪边，跟舵机装的朝向有关**，官方运行时里每颗有方向和偏移量（`motor.rs`，注释说是「对着硬件量的」）。试干涉的时候两个方向都拉到底就行，不用管符号。

---

---

## 不打 HAT · 飞线接主控

**单独成文了 → [docs/不打HAT.md](docs/不打HAT.md)**。很多人觉得 HAT 打样太贵，那份就是替代方案：¥70 的模块、一步一步接、哪步会烧东西。
这里只记做的时候发生了什么。

---

## 2026-09-10 · 舵机和调试板到了

**到了什么**：15 颗 HD-1910-C001，一块 FE-URT-2 调试板（USB-C，TTL 和 RS485 口都有）。

**第一个问题**：舵机原装线是 **2.0 mm 3P**（规格书写的 AMP2.0-3P），调试板左边那两个白色 TTL 口**比这个大，插不上**。板子没给 2.0 的口。

**怎么办**：买「舵机转接线 2.0 转 2.5 3P」。等线的期间要动手就剪两根线对焊。
`imu_to_dxl` 板的 J4/J5 是 PH 2.0 mm，跟舵机线是配的，**不受影响** —— 只是这块调试板的口不对。

**下一步**：转接线到了逐个配 ID。**一次只接一颗**（出厂 ID 全是 1），改完贴标签。
顺手把每颗的过流、过压保护打开（出厂默认关）。波特率和运行模式出厂就是对的，不动。
步骤和 ID 表见上面 [舵机配置 · 拿到货一步一步做](#舵机配置--拿到货一步一步做)。

---

## 2026-09-12 · 器件到齐，主控排针焊好，舵机开始装机械件

**到了什么**：Radxa Zero 3W（2 GB 裸板）、ToF、电池、电池仓、microSD、排针、摄像头。加上 09-10 的舵机和调试板，**除了 `imu_to_dxl` 板（立创还在做）和飞线模块（降压、转接板、转接线），全齐了**。

**做了什么**：
- 2×20 排针焊到 Radxa 上了
- 开始把飞特 HD-1910 往机械件里装

**发现的问题**：**HD-1910 跟原版 XL330 在结构上有差异**（压腿那一处）。同事改了结构件重新打印，改后能装。
具体哪个件、改了哪里、改了多少 —— *待补*（拍照、量尺寸，写进 [构建日志](构建日志.md)，同时在 [执行器选型](docs/执行器选型.md) 的 HD-1910 那节加一条「机械上不是直接替换，要改件」）。

**算法侧发来训练前数据采集清单** → 填好的在 [docs/HD-1910训练前数据清单.md](docs/HD-1910训练前数据清单.md)，仓库有的全填了，台架项标了怎么测。

**下一步**：
- 舵机继续装，装完一条腿先量一次活动范围
- 配 ID —— 转接线还没到，先按 [上面第 2 步](#第-2-步--飞线) 剪一根舵机线飞过去。**今天先做这个**
  - ✅ 线飞好了，拨码拨到 USB 侧，G–V1 量到 5 V
  - ✅ 插电脑出 **COM5**，芯片是 **CH343**（不是 CH340），Win 自带驱动直接认 —— 手册第 1 步已改
- 主控刷机 —— **没读卡器，做不了**。卡是 microSD，板子自己不能当读卡器用；笔记本没 SD 槽的话得买一个（USB 3.0 的）。到了按 [不打 HAT · 第 1 步](docs/不打HAT.md#第-1-步--主控点亮什么都别接) 点亮

---

## 2026-09-13 · 15 颗全配完、全装上，开始台架

**做了什么**：15 颗 HD-1910 全部配好 ID、开了过流过压保护、装进机身。

**台架接法**（不用降压模块，Radxa 用充电头）：
- 可调电源 7.4 V 限 2 A → **直接接舵机总线 V/G**，URT-2 的 G 也接电源负极共地，**V1 端子空着**
- URT-2 拨码 = 信号电平，拨 5 V（之前写的「外接侧」是错的，那板子没有供电切换）
- URT-2 USB-C → Radxa **host** 口（不是电源口）
- Radxa 电源口 → 5V/2A 充电头（**别用电脑 USB，500 mA 不够**）

**下一步**：`dmesg` 看 CH343 出没出 `ttyACM0` → Python 扫 ID 10–34 → 15 颗全应答 → 官方运行时。

---

## 2026-09-16 · 主板上电，烧卡

**做了什么**：
- Radxa Zero 3W 裸板上电，正常。排针 2.54 mm，跟 DXF 里的孔距对上（两排 y = 25.41 / 27.95 mm）。
- 读卡器、5 V 降压模块到了。
- 烧 Armbian 26.8.1 trixie minimal（sha256 校验过）。Rufus 便携版，认 `.img.xz`，2 分钟写完。截图在 [`assets/flash/`](assets/flash/)，步骤写进了 [不打 HAT · 第 1 步](docs/不打HAT.md#第-1-步--主控点亮什么都别接)。

**踩的坑**：想用 `wsl --mount` 把 `.not_logged_in_yet` 写进烧好的卡，报 `ERROR_FILE_NOT_FOUND`，WSL 挂不上 USB 读卡器。改成**先把预设塞进镜像再烧**，脚本放在 [`tools/radxa/`](tools/radxa/)，不用管理员。记在 [踩坑记录](踩坑记录.md)。

**瑞莎资料**：原理图 / 产品简介 / 2D DXF / 3D STP / 元件位置图都下了，本地 `Radxa-Zero3W/`。**没有 PCB 源文件**，位置图和 DXF 里也没标 pin 1。认 pin 1 靠万用表：OTG 口供电，量排针四个角，3.3 V 那个是 pin 1，它旁边 5 V 的是 pin 2。

**下一步**：卡插上开机 → 路由器里找 `radxa-zero3` → `ssh duck@IP` → 插 URT-2 看 `dmesg`。

---

## 2026-09-16 ～ 17 · 主板点亮，九张卡

**结果**：Armbian 26.2.1 vendor 在板上跑起来了，WiFi 自动连、ssh 能进、`/dev/ttyS2` 出来了、插电脑多一个 USB 串口，Pollen 官方三个脚本跑完，daemon 0.13.0 装上。做卡一键化在 [`tools/radxa/`](tools/radxa/)。

**过程**（按时间）：
- 09-16 晚：Rufus 烧 Armbian 26.8.1，WiFi 预设塞进镜像。开机灯双闪，局域网里没有它。以为是 WiFi：路由器 WPA3 混合、AIC8800 不支持 GCMP-256、5G 频段、两套驱动打架，一版版改，烧了四次，都没有。
- USB 串口这条路也试了：`g_serial` + `dwc3-peripheral`，电脑看不见设备。
- 读卡：把卡的根分区拷出来挂上看，**根分区一个字节没被写过**，首次开机标记还在，分区没扩容。也就是内核起了心跳但从没挂上系统盘。前面改 WiFi 的四版全是无用功，问题在更前面。
- 换底子到 26.2.1（官方指定版本）、去掉 SDR104，都不行。做了「黑匣子」initramfs（进 initramfs 灯灭、找到盘常亮、失败快闪、内核日志写到卡的分区外区域），结果灯一直双闪，连 initramfs 都没进。
- 09-17 零点：瑞莎官方镜像（b1，2025-07）烧上，同一张卡同一块板，两分钟连上 WiFi。ssh 进去看：SD 卡跑 SDR104 正常，WiFi 是 AIC8800D80/DS2，设备树跟 Armbian 的逐项比对基本一样。板子、卡、供电、设备树全排除。
- 比引导程序：Armbian 用主线 U-Boot 2025.10 + DDR 固件 v1.21（2024-01），瑞莎用 rk U-Boot 2017.09-51 + DDR v1.23（2024-09）+ BL31 v1.45。板子是 2024-11 的 V1.12。
- 把瑞莎镜像的扇区 64～32767（idbloader + u-boot.itb）覆盖到 Armbian 卡上，加一个 `/boot/extlinux/extlinux.conf`，**第九张卡起来了**。灯：双闪 → 灭 → 常亮，局域网里 `192.168.0.102`，电脑上多了 COM5。
- 然后按官方 `install-by-hand.md`：extlinux 挂 `uart2-m0` + `dwc3-peripheral`、控制台放 tty1、mask 掉 ttyS2/ttyFIQ0 的 getty；WiFi 改成 Armbian 标准 netplan 写法；`setup-board.sh`（aic3x 编解码器 DKMS、ONNX Runtime 1.28、ToF udev 规则）→ `migrate-network.sh`（NetworkManager）→ 重启 → 再各跑一次 → `install.sh`（daemon 0.13.0）。板子走电脑的 Clash 代理下 GitHub。

**踩的坑**都进了[踩坑记录](踩坑记录.md)：引导程序、GCMP-256、dwc3-peripheral、GitHub 代理、首次开机预设缺变量。

**下一步**：第 4 步舵机总线接主控（URT-2 走 USB，或飞线到 pin 8/10 用 `/dev/ttyS2`），`robotctl health` 看 15 颗舵机。

**躯干 IMU 两条路线**（2026-09-17 定下来并行）：

| | A · `imu_to_dxl` 小板 | B · GY-BNO085 模块直飞主板 |
|---|---|---|
| 硬件 | 自绘板，已到货，3.3 V 正常，连接器封装待改 | ¥66 现成模块，I2C 接 40 针 pin 3/5（跟 ToF 同一条 i2c3），3.3 V 取 pin 1 |
| 软件要做的 | STM32 固件：ID 200 寄存器协议 + IMU 融合，**目前没有公开固件，从零写** | robotd 里加一个 I2C IMU 源（Rust），BNO085 片内融合直接出四元数 |
| 对官方运行时 | 协议兼容，robotd 不改 | robotd 改 IMU 后端 |
| 共同要做 | 飞特舵机协议移植（robotd 说的是 Dynamixel） | 同左 |

原型机时代（树莓派 Zero 2 W 版）就是 I2C 接 BNO055，B 路线有先例。先买一块，`i2cdetect -y 3` 看到 0x4A、Python 读出四元数就算通。

---

## 2026-09-28 · HAT 到货、替换 ID 21、摄像头终于出图

**舵机**：用户将原嘴 ID 34 的舵机挪作 ID 21，替换损坏的原 21，并用 FD 完成 2048 中位校准。此项来自用户确认；本轮主板/摄像头检查没有重新读回舵机寄存器，也没有执行动作。嘴暂缺，设计 ID 表不变。

**主板与供电**：HAT 已与主板对插，用户从可调电源向 HAT 输入 7.4V，开始逐项检查。HAT 的降压输出给主板 5V；主板联网后通过 Wi-Fi / SSH 调试。主板的 `5V IN / USB_OTG` 兼有供电和 gadget 功能，USB 3.0 是 Host；HAT 供电时不要同时用普通 USB 数据线接电脑引入第二路 5V。此处记录接法与调试进展，不代表负载、电压纹波、音频或舵机总线已经验收。

**摄像头过程**：

1. 原 Armbian 下相机不应答，IMX219 寄存器读取报错，媒体拓扑中没有传感器实体。
2. 换瑞莎官方 Bookworm KDE B1 做对照；镜像只预置本机 Wi-Fi / SSH，内核、驱动及系统内容保留原版。启动后通过官方 `rsetup` 启用 `radxa-zero3-radxa-camera-8m.dtbo` 并重启。
3. 官方系统起初仍复现 `Error -5`；不能仅凭有 `/dev/video0` 就判相机正常。绿灯双闪是该系统的 `heartbeat`，不是启动失败证据。
4. 用户检查并调整排线正反面后重新上电，成功读到 `Model ID 0x0219`，`imx219` 驱动绑定，媒体链路完整。
5. GStreamer 限量采集 40 帧，约 4.05 秒后正常 EOS、退出码 0；实际查看最后一帧，1920×1080 JPEG 中可见天花板、灯和显示器。

接线参考图、完整复测命令、版本和证据见 **[摄像头调试记录](tools/radxa/摄像头调试记录-20260928.md)**；精简提醒见 **[踩坑记录](踩坑记录.md#主板--hat--摄像头)**。

**后续顺序**：用户已决定换回原项目 Armbian，保持成功接法先复测识别和抓帧，再恢复项目运行环境、测试持续视频，之后逐项验 HAT 外设和舵机总线。此前带 Wi-Fi 的 09-20 基础镜像已做只读文件系统检查，通过；本轮末尾已正常关机，等待断电取卡烧录。该镜像不是刷官方卡前的完整运行卡备份，摄像头启用与项目软件需恢复。原 Armbian 未在正确接线下复测；相机出图不等于整机、HAT 供电路径或行走已验收。此前建议的“拆 HAT、主板单独 USB 供电”是否实际执行未确认，不把它算作已完成测试。

## 2026-10-11 · 用自己的运行器跑 kissqy 的 walk 模型

**为什么这么做**：kissqy 的 R17 部署包叠在官方 0.15.1 系统上，只认挂在舵机总线上的 IMU（ID 200、身份 `06 00 00 00 F2`），代码里没有 I²C 路径；咱们这台用的是 BNO085 接主板 I²C，卡上也没有官方运行程序。所以模型用他的，运行程序用 10-04 跑 Luwu 的那个，新加 `kissqy_walk` 配置，执行参数照他的 robotd 实现。

**结果**：手托机身时只换姿势不迈步；放到地上不扶，0.4 秒内两腿开始交替。几次中途停机、全身卸力，都是运行器保护造成的（6.6 V 低压线、停下后 1° 保持判定），已改。电源调到约 8.0 V 后，0.15 m/s、P5 跑满 10 秒并正常回站：前 3 秒来回摆动，之后半蹲不动，还没有走出连续步态。P10 电流过大，可调电源电压塌到 5.4 V。

**后半段**：发现主板过热降频（84–87°C，CPU 被锁在 408 MHz，网页服务常驻占满一个核），控制周期被拖到 25 ms；停掉网页服务后回到 20 ms。节奏对了、动作做足后可调电源又被拉到 4.6 V，加了软起步。关节方向逐个核对全对，15 颗舵机参数一致。条件最好的一次（20 ms、1.8 GHz、最低 7.6 V）仍然只换姿势、不连续迈步。**决定改用 kissqy 的 Rust 运行程序**，给它加「IMU 接主板 I²C」的接法（方案 B），原生的总线小板（方案 A）保留。

**当晚还碰到**：电脑开 Clash TUN 时连不上主板；主板开机两分钟后死机一次（绿灯常亮），原因未定。

逐次数据、每个参数的含义、怎么自己跑，见 **[2026-10-11 kissqy 上机实测](docs/HD1910-20261011-kissqy-walk上机实测.md)**；结论已补进[踩坑记录](踩坑记录.md#策略训练与真机迁移)。

## 2026-10-12 · 第一台换成 kissqy 整套：官方 0.15.1 + R17 + I²C IMU

**为什么这么做**：10-11 用自己的 Python 运行器排查到最后，剩下的差别全在运行层。kissqy 在群里演示他的整套已经走得很流畅，定下以后机器人上不再装自己那套，直接用他的整套，只补他缺的「IMU 接主板 I²C」（本地分支 `hd1910-trunk-imu-i2c`）。

**做了什么**：原卡没重烧（官方程序一个都没装过，IMU 用的 `i2c4-m0` overlay 已经有了），备份 `/home/duck` 后远程安装。官方 `install.sh` 只装最新版（0.16.1），改成用本地文件固定装 `daemon-v0.15.1`，并关掉自动升级。没跑 `setup-board.sh` 的音频部分（会换内核）和 `migrate-network.sh`。先装 kissqy 原版 R17 做基线：卡在 `alsactl store aic3104`（HAT 上的音频芯片没启用，系统里没有这张声卡，分支已修），装上后报「ID 200 无应答」（他只认总线 IMU），还把他样机的零位抄成了本机标定。再换咱们的包、配 `[trunk_imu] source = "bno08x"`。

**结果**：BNO085 在真机上读通（固件 2.6.6），15 颗舵机 50 Hz 全应答，约 1.7% 的周期 IMU 数据过期（单帧，控制循环可以沿用上一帧）。标定改成咱们的零位 2048、方向 −1。鸭子用 servo-web 站到 HOME 后测 IMU：站着离竖直 4.95°，前倾 16.2°、方向偏正前方 3.9°，默认安装方向正确。切运动模式后，先卸力再 HOME，2 秒站到官方站姿；模型接管原地保持 10 秒，机身倾斜从 6.6° 收到 3.3°，没有报错。

**卡住的地方**：主板过热。没接摄像头时 mediad 不停崩溃重启，GStreamer 扫描占满一个核，主板 89°C。关掉 mediad、tofd 后仍在 85–92°C，CPU 一直锁在 408 MHz。中控网页摇杆按 Start 没反应：网页手柄服务启动要 1.7 秒，超过了它等 padd 确认的 0.6 秒。用户关机降温，下一步先加散热（开孔、做风道），再试网页摇杆和行走。

每一步的命令、数字和原因见 **[2026-10-12 kissqy 整套上机](docs/HD1910-20261012-kissqy整套上机.md)**；结论已补进[踩坑记录](踩坑记录.md)。

## 2026-10-12 下午 · 拆 kissqy 镜像 R1，改出 V1.12 能开机的卡

**为什么**：kissqy 10-12 发布了整卡镜像「一键系统镜像 R1」（官方 0.15.1 + 他的固件 V164 / control.40，首次开机开热点配网）。要弄清楚三件事：咱们这类板子能不能开机、IMU 模块认不认、预装了什么会坑新手。不行的地方，就在他的镜像上改，不另起炉灶。

**做了什么**：

- 下载 `microduck-zero3w-0.15.1-R1.img.xz`，sha256 跟他公布的 `75da978b…a7bce5` 一致。
- 在 WSL 里只读挂载拆解，程序一个没运行：查了引导区、启动配置、开机自启的服务、固件里的字符串、标定、账号，按特征扫了令牌和私钥。
- 拷出 V164 的安装脚本和更新说明，跟 v146 逐个文件比对。
- 对照 HAT 两版（C1 生产 Gerber 和 BOM、D1 KiCad 工程），核对 J5～J8 的脚序和 J5 线上的芯片地址。
- 写了 [`tools/radxa/kissqy-r1-v112.sh`](tools/radxa/kissqy-r1-v112.sh)：在他的镜像上换瑞莎引导、写 extlinux（他的 overlay 原样搬过去），可选关掉 mediad / tofd、加 overlay。

**结果**：

- 隐私处理得很干净：没有令牌、私钥和 WiFi，账号锁定，SSH 主机密钥首次开机才生成。
- 跟咱们硬件对不上的有三处：引导是 Armbian 主线 U-Boot 2025.10 + DDR v1.21（咱们的 V1.12 板就是在这套组合上起不来的）；只认总线 IMU 小板（ID 200）；预装他样机的标定，IMU 还标成了「已确认」。另外相机、测距服务默认开着。
- V164 把网页手柄改成直接走 robotd 的 IPC，不再用 webpad，10-12 凌晨摇杆没反应的那条路已经换掉了；但中控的模型导入也撤了。
- 用脚本做了一张 `--no-tof --overlay i2c4-m0` 的卡并离线验证：引导区跟瑞莎官方包逐字节一致；扇区 0～63（分区表）没动；根分区跟原版逐个文件比，只改了预期的 5 处（新增 `extlinux.conf` 和说明文件，改 `armbianEnv.txt`，去掉 tofd 自启）。
- C1 版 HAT 的 J5 线上已有音频（0x18）和 BMI088（0x19 / 0x68），D1 版换成 LSM6DSV16X（0x6A）。J6 拆 R18/R19、短接 R16/R17，就能改成 I2C4。

**下一步**：拿一张空卡烧改好的镜像，在第一台上试开机、热点配网、SSH（现在那张卡别动）；问 kissqy 什么时候公开 V164 源码，好把 I²C IMU 补丁移植过去。

全部依据见 **[kissqy 镜像 R1 分析](docs/HD1910-20261012-kissqy镜像R1分析.md)**；结论已补进[踩坑记录](踩坑记录.md)。

## 2026-10-12 夜 · IMU 装歪 8.5°：校准后站稳 70 秒，开始交替迈步

**一句话**：模型一接管就往后猛冲，根因是 BNO085 模块装歪了约前倾 8.5°、右倾 1.75°。模型训练时站 HOME 机身是水平的，IMU 却一直说「前倾 8.5°」，模型就拼命往后救。把真机关节角放进仿真算出「应有倾斜」，减出偏差，补进 IMU 安装四元数后，模型接管 70 秒没倒（倾斜平均 +0.2°），推摇杆 0.14～0.21 m/s 两腿开始有节奏地交替迈步。往前走了多少还没量。

**一路上解决的**：
- 网页手柄按了没反应：四层原因（SSH 登录白跑 3.8 秒欢迎脚本、中控 0.4 秒判过期、虚拟手柄冷启动、padd 打开新设备的时序），最后改用雷神 G50 Pro 蓝牙直连（背面拨 S 档）；
- 移动电源过流退回 5 V，舵机没劲、站不到位；换可调电源 8 V；
- BNO085 的线接触不良，I²C 不应答，robotd 判 IMU 过期就卸力；重新焊牢、绑住后不再断。

**主板上的改动**：SSH 欢迎脚本关掉（有备份）、IMU 安装四元数改成 `[0.454164155, 0.544101455, 0.527409117, 0.468538313]`（有备份）、装了开机自启的录像服务 `duck-rec`、蓝牙手柄已配对。怎么改回去都列在上机记录 §9。

**还没解决**：散热（模型一跑 10 分钟 CPU 到 85°C、降频）、嘴部舵机站着就 60～70°C、滤波 1/1/1 和 0.9/0.5/0.7 还没对照、TPU 鞋底和前进距离。

每一步的数据、为什么、别人怎么照做：**[2026-10-12 夜上机记录](docs/HD1910-20261012-夜-IMU校准与首次迈步.md)**；分析脚本和 IMU 零点校准步骤：[`tools/radxa/onboard-analysis/`](tools/radxa/onboard-analysis/)。

## 2026-10-13 · 跟进官方 0.17：UDP 手柄和手柄掉线自动坐下（代码完成，未上机）

**一句话**：官方 10-12 连发 robotd 0.16.2～0.17.1，主要是「UDP 手柄」：电脑上插手柄、走局域网控制鸭子。我们的底子是 kissqy 的 0.15.1，官方到 0.17.1 改了两万多行，双方的接口版本号也各自往上加、对不上，所以不整体升级，只把 UDP 手柄和「手柄掉线 1 秒自动坐下」搬进 kissqy 的 padd。做法是在 padd 里加第二个输入源，按键沿用 kissqy 的映射；线协议和官方逐字节一致，电脑端直接用官方的 `uvx duckctl@0.17.1 udp-pad <IP>`。

**审核**：改完开 subagent 独立审核，共 6 轮，最后一轮没有必须修的问题。修掉的问题包括：安装包实际用的 unit 文件没放行 AF_INET；重连时按着的 Select 被当成急停（24 次里 8 次）；robotd 慢答被误判成手柄断开；卡顿后旧摇杆、旧长按还会生效（会走一小段、误关机）；同一拍里松开再按下的 Select 变成关机。都用脚本复现过，修完复测为 0。

**结果**：padd 单元测试 79/79，端到端 14 项全过，官方 0.17.1 的解码器能解开我们发的每一包。板子用的 padd 和部署脚本已备好（先备份原版，一条命令回滚）。**还没上机**：上机先用蓝牙手柄确认没退步，再手动试 D-pad 下的坐下，再测掉线坐下，最后测 UDP 手柄。

为什么这么做、怎么用、审核每一条的现象和原因：**[2026-10-13 官方更新与 UDP 手柄](docs/HD1910-20261013-官方更新与UDP手柄.md)**。

## 2026-10-13 夜 ～ 10-14 凌晨 · 新卡上机、整机掉电、舵机 D 与颤、蹭地分析

**一句话**：换上 kissqy 一键镜像（V164 + 我们的 IMU 补丁）的新卡，开机、配网、蓝牙手柄都打通了，但新旧卡都会在走路时**整机掉电**（新卡那次舵机端最后读到约 3.9 V），是供电问题，不是软件。走路发颤跟**舵机的 D（硬件阻尼）**有关：训练用的舵机模型里没有 D，真机带着 D=20/40。改成 D=0 后，颤从 51% 降到 4～8%；P3 时机身晃动跟仿真一样。现在用旧卡 **P3 / D0 / 转矩 700**。

**一路上解决的**：
- 新卡 G50 Pro 配上就被断开：这张卡开机时蓝牙不可绑定（No Bonding），`ClassicBondedOnly` 拒绝没绑定的 HID（几项一起改后配上过一次，还要再验证）；
- 在 `robotd.toml` 里改缩放、滤波的几组对比是白做的：联合模型用它自己包里的 `deployment-execution.json`；
- 新卡中控里的 P/D/转矩框不生效：V164 只写 P，D 留在出厂 40；
- IMU 横滚零点还差约 1.1°，往回补了 1.14°；
- 录像服务改成每秒写盘、文件名带开机编号，加了系统日志实时抄写，掉电后能看到最后一秒。

**还没解决**：
- **蹭地**：两只脚离地只有 3～6 mm，仿真是 11～12 mm。撑地时膝盖伸不直，模型要伸，真机一直弯着。左脚看起来更蹭，是因为迈步时左脚脚尖朝下，右腿撑地时机身多往前栽约 1.5°；这两点都是 D 改成 0 以后才出现的（D=20 时没有），下一步先试 D=5～10。另外按舵机读数，两只脚在左右方向（横滚）差约 1.6°～2.6°，没查（10-14 白天查了，见下一节）；
- **供电**：10 A 电源 10-16 到。

每一步的数据、为什么、怎么改回去：**[2026-10-13 夜上机记录](docs/HD1910-20261013-夜-掉电-舵机D与蹭地.md)**；步态分析脚本：[`tools/gait-analysis/`](tools/gait-analysis/)；录像服务：[`tools/radxa/onboard-analysis/`](tools/radxa/onboard-analysis/)。

## 2026-10-14 白天 · 仿真对照找蹭地原因、鞋底、新版放开 P / D / 转矩（未上机）

**一句话**：白天鸭子不在线，只做电脑上的分析和代码。拿 kissqy 的行走模型在仿真里跟真机比，发现上午仿真的条件跟真机没对齐：真机联合模型的动作缩放实际约 0.83、带头腿滤波，kissqy 训练用的模型是 820 g；仿真里却是缩放 1.0、不滤波、737 g。对齐以后（重量按 kissqy 训练模型的 820 g 估），仿真的撑地膝盖已经接近真机，仿真里看「膝盖伸不直」大部分能用这几个条件解释；但那组仿真会多出真机没有的高频颤（96%），原因没查。另外，在 kissqy 新版 V164 上把 P / D / 转矩限制和头腿滤波放开了（本地，未上机，不公开）。

**一路上弄清的**：
- 仿真对照要先对齐缩放、滤波、重量、速度；缩放从 0.83 提到 1.0，仿真里能多抬约 3 mm；真机上联合缩放改成 1.0、乘上电压补偿只加 11%，按线性估效果大约只有仿真的一半，仍值得试；
- 仿真里设不设 70% 转矩上限，结果几乎一样；速度不是差距的原因；
- 脚底太滑在仿真里会变成碎步加颤，但对不上真机 D0 的表现；我们的鞋底是 TPU 95A，换 85A 或防滑片值得试；
- 站 HOME 两脚左右不共面：两个髋横滚往外劈，每次不一样，像是被体重压的（推测）；零位偏没偏，这个方法看不出来；上午口头说的「外侧边翘起」，14 段里 12 段说反了；
- 舵机参数都是上力时写 RAM、卸力时恢复；上着力时 robotd 被重启过，参数会留在舵机里，切回原版行为（只写 P）前要给舵机断一次电（V164 上重启 robotd，鸭子会当场瘫）；
- kissqy 新版的「修复手柄连接」只认盖世小鸡 Nova 2 Lite，对 G50 Pro 没用。

**还没做**：新卡装可调版、看两只脚哪边透光、称重、换鞋底、试缩放 1.0；供电（10 A 电源 10-16 到）。

每一步的数据和为什么：**[2026-10-14 白天记录](docs/HD1910-20261014-白天-仿真找原因与新版放开参数.md)**；新脚本 [`tools/gait-analysis/home_roll.py`](tools/gait-analysis/home_roll.py)。
