yoyojacky/microduck-replica/踩坑记录.md

# 踩坑记录

复刻过程中真踩过的坑，**每条三句：现象、原因、怎么办**。按阶段分，上手前扫一遍。

分析和证据在别的文档里，这里只记结论。有新坑往对应阶段里加，写直白点。

> 机械过程在 [构建日志](构建日志.md)，电气与软件过程在 [调试记录](调试记录.md)。最近补充：2026-10-14 晚，kissqy V167 改成上力写 D=0、转矩 1000（用 IMU 模块的别直接升级）；2026-10-14 白天，舵机参数写在 RAM 里（上着力时重启 robotd 会残留）、两脚左右不共面是两个髋横滚往外劈（推测是被体重压的）、嘴的舵机发烫、新版「修复手柄连接」只认盖世小鸡、别点「安装 / 升级固件」、鞋底 TPU 95A 偏硬、仿真对照先对齐缩放滤波重量；2026-10-13 夜～10-14，舵机 D 让走路发颤、V164 不写 D 和转矩限制、走路时整机掉电是供电、新卡 G50 Pro 配上就断、换卡要重配手柄、固定 IP 被占、Armbian 日志掉电就没、联合模型的缩放滤波不在 robotd.toml、蹭地先算清楚再调；2026-10-13，kissqy 安装包用的是 `packaging/padd.service`、交叉编译 padd 要 arm64 libudev、官方和 kissqy 的接口版本号各加各的、飞特 AMP2.0 板端座子型号；2026-10-12 夜，IMU 装歪 8.5° 才是模型一接管就猛冲的根因（附零点校准方法）、网页手柄四层原因、SSH 欢迎脚本、ToF 重连、蓝牙手柄配对、IMU 线接触不良、膝盖塌、移动电源退回 5 V、TPU 鞋底；2026-10-12 下午，拆 kissqy 一键镜像 R1（V1.12 起不来、只认总线 IMU 小板、预装样机标定）、瑞莎引导下改 armbianEnv 不生效、HAT J5 接 IMU 模块的地址、Windows 下 Python 改文件变 CRLF；2026-10-12，换成 kissqy 整套（官方 install.sh 固定 0.15.1、声卡没启用时卡音频设置、R17 抄样机标定、mediad/tofd 把主板烧热、开孔与风道、装 R17 会卸力、IMU 方向先站再测、别的程序上力后 HOME 被拒、`service.sh init` 发不出 HOME、过热让网页摇杆失灵）；2026-10-11，kissqy 行走模型上机（手托测不出步态、低压保护与全身卸力、供电余量、软起步、主板过热降频、Clash TUN 挡住主板、开机后死机）；2026-09-28，HAT 供电、USB 口、摄像头排线和官方镜像对照。

---

## 买东西

**电池别买 NP-F970，是 NP-F550**
上游网格文件名叫 `np_f970.stl`，但量出来是 39 × 21 × 71 mm，这是 F550 的尺寸。真 F970 厚约 60 mm，**装不进去**，而且 300 g 会吃掉整机预算的三分之一。
→ 买 NP-F550（2S，6.6–8.4 V）。详见 [BOM](BOM.md)。

**飞特 HD-1910 的线是 2.0 mm，飞特调试板的口不是 —— 配 ID 得飞线**
HD-1910 原装线是 AMP2.0-3P（2.0 mm 间距）。FE-URT-2 调试板的 TTL 口比这个大，**插不上**，板子也没给 2.0 的口。
→ 当天就要配 ID 的话，**剪一根舵机线**（15 根牺牲一根），三根裸线这么接：

```
舵机线                  FE-URT-2
脚 1  Signal    →   S    焊到板背面白口 S 脚的焊点上（临时也可镀锡后直接插进 S 孔）
脚 2  Vcc       →   V1   蓝色接线端子
脚 3  GND       →   G    蓝色接线端子
```

**中间那根一定是 V**（飞特和 Dynamixel 在这点上一致），S 和 G 接反了不会烧、只是通不了，对调即可。
**V 接错才会烧。** 配 ID 空载，USB 5 V 够用（HD-1910 从 4 V 起工作）—— 先用万用表量蓝色端子 G–V1 有没有 5 V，没有就拨那个开关。
→ 正式的做法是买「PH2.0 3P 端子线」+ 板子那种规格的端子线各几根，对焊成转接线。买前翻翻舵机包装盒，有时附一根。
→ 这条值得直接告诉飞特：正式版是否附转接线。

**飞特脚序跟 Dynamixel 完全相反**
飞特 HD-1910：`1=Signal 2=Vcc 3=GND`。Dynamixel XL330：`1=GND 2=Vcc 3=Signal`。
→ 好在两种间距不同（2.0 vs 2.5 mm）插不进对方。只剩「自己压线时压反」这一种可能 —— 压完先用万用表点一遍。

**别拿 HL-2915 当参考**
飞特 HL-2915-C002 是 9–14 V 舵机，2S 电池（最高 8.4 V）**带不动它**，而且它的脚序又跟 HD-1910 相反。
→ 本方案只认 HD-1910-C001。

**电池满电 8.4 V 正好等于 HD-1910 的电压上限**
HD-1910 工作范围 4–8.4 V。NP-F550 满电 8.4 V，**零余量**。带载压降到 6.6–8.2 V 才回到安全区。
→ 刚充满别直接堵转测试。长期存放按 3.8 V/cell 存。装机前把舵机的过压保护打开。

**Radxa Zero 3W 低配版是裸板**
2 GB 无 eMMC 版本**没焊排针、没有存储**，只能 microSD 启动。
→ 自己买 2×20 排针（2.54 mm，立式，买彩色的好数脚）和**高耐久** microSD（SanDisk High Endurance / 海康 PLUS，32 或 64 GB，买两张一张做备份）。

**URT-2 的 V1 端子别灌外接电源**
板上拨码是 TTL 电平选择（3.3 / 5 V），**不是**供电切换。USB 插上 V1 就有 5 V，跟 USB 怎么连的不清楚，可能直通。往 V1 灌 7.4 V 有反灌进电脑或 Radxa 的风险。
→ 外接电源直接给舵机的 V 和 G，URT-2 的 G 一起接负极共地，V1 空着。URT-2 只管信号。

**飞特舵机出厂 ID 全是 1**
15 颗一起接上去，全都应答，分不出谁是谁。
→ **设 ID 时一次只接一颗。** 改完贴标签（写关节名 + ID），拔掉，换下一颗。步骤和 ID 表见 [调试记录 · 舵机配置](调试记录.md#舵机配置--拿到货一步一步做)。

---

**ToF 模块：L8CX 那块板装不进脸壳，L7CX 固件又不认**
现象：先买了 VL53L8CX，国内常见那块板 **33.4 × 10.2 mm**，脸壳（`face_part`）装不下；
为了短，改买 L7CX（26 mm），结果固件启动就报错退出。两块都白买。
原因：L7CX 是 90° 宽视场的**另一颗芯片**，revision ID 对不上。官方 `tof` 固件只认 `0x02`（L5CX）
和 `0x0C`（L8CX）两个，别的直接报 `neither a VL53L5CX nor a VL53L8CX` 然后退出 ——
固件里只编了这两个 ULD 驱动，不是改个 ID 能绕过去的。
→ 买 **VL53L5CX（VL53L5X V2 模块）**：固件认，**孔距 20 mm 正好对上打印件**（同事实测打印件孔位 20 mm，
L8CX 那块板是 28 mm，根本装不上），板子也最小（**15.8 × 10 mm** 板体 / 24.7 mm 含安装耳），
还便宜 25 块。**选型顺序是先看芯片固件认不认（只有 L5CX / L8CX 两颗），再看板子塞不塞得进**——
反过来先挑尺寸就是这次的结果。L8CX 这颗芯片本身没问题，是那块板子太长；
要是能找到短板型的 L8CX 也能用，孔距和镜头位置按实物量。
三种板型尺寸对比见[电控采购清单](docs/电控采购清单.md#四tof-测距--vl53l5cx-或-vl53l8cx8×8-多区)。

## 画板 / 打板

**立创下单页的「替换」不回写工程**
下单页点「替换」换料号，只对那一单生效。EasyEDA 工程里的元件还是旧料号，**下次导 BOM 又变回去**，再报一次「私有库 0」。
→ 在 EasyEDA 工程里把元件换掉（删了重放同坐标），不要只在下单页换。

**有源晶振和无源晶体，3225 四脚长得一模一样**
无源晶体的 2 脚和 4 脚是同一片金属盖、内部短接。本板 X1 按有源画（2=GND，4=VDD），贴上无源的**一上电就是 3.3 V 对地短路**。立创搜「3225」出来大部分是无源，`C13738`（基础库免换料费）最容易顺手点错。
→ 只认标签写「有源晶振 / OSC」的。本板用 `C5917307`。

**星通时频 C387369 立创贴片备料库没有**
下单时被归到「使用私有库存的元器件」，私有库 0。
→ 换 `C5917307`（雅晶鑫，5 mA，同封装）。

**加了器件后 Gerber / BOM / 坐标全要重导**
改了原理图（比如加 J4/J5）后，三个文件都变了。用旧 Gerber 打板，板子上没那两个座子的孔。
→ 每次改完导出全套，文件名带时间戳，认最新的那份。

**J4/J5 选的 PH2.0 座子，间距对了，外壳跟飞特线的插头不配，插不进去**
飞特 HD-1910 的线是 AMP2.0-3P 插头，2.0 mm 间距没错，但插头外形和 JST PH 的座子外壳（`B3B-PH-K-S`）对不上。评审时就有人提醒「板端座子没实物验证」，果然。
→ 首板：把座子外壳削掉，光留针，能插能用。v2：拿飞特线实物去配座子（问飞特要板端座子型号，或买几种 2.0 mm 3P 座子试插），**投板前实物插一次**。
→ 补充（2026-10-13）：飞特规格书只写线端 `AMP2.0-3P`，板端型号没公开，网上也没查到验证过的卧式料号；别的复刻项目直接写成「PH2.0」，同样没实测。但飞特尺寸图上**舵机本体底部就有两个同款座子**，说明配套的板端座子飞特自己在用 —— 最快是直接问飞特要型号、能不能单买、有没有卧式。

**GitHub Release 附件名里的中文会被清掉**
上传 `SolidWorks图纸.zip`，存成了 `SolidWorks.zip`。README 里写的下载链接对不上。
→ Release 附件直接用英文名。

---

## 飞线（不打 HAT 时）

> 完整接法在 [不打 HAT](docs/不打HAT.md)，这里只列会咬人的。

**转接板的逻辑供电只能取 3.3 V**
半双工转接板 MCU 侧有个 VCC。取 5 V 的话它的 TX 会用 5 V 电平打进主控 3.3 V 的 RX 脚。
→ 从 40 针 pin 1（3.3 V）取。ToF 从 pin 17 取，两个不抢。

**5 V 灌进 40 针是无保护的**
从 pin 2/4 喂 5 V 绕过了板子自己的 USB 输入保护。**接反当场烧板。**
→ 插之前先量降压模块输出的极性和电压。

**舵机主干别用杜邦线**
15 颗峰值好几安培，杜邦线 24–28 AWG 只扛 1 A 左右，会发烫甚至熔皮。
→ 主干用 18–20 AWG 硅胶线。

**电池到舵机那一路要串保险丝和开关**
锂电池短路会喷火。官方 HAT 那条路上有热敏 + 「3A max」标注，飞线方案裸接就什么都没有。
→ 串 5 A 保险丝 + 电源开关。

**没有关机检测信号**
HAT 上的 LM5050-1 给主控一个关机信号，飞线方案没有。每次断电都是硬拔，**最伤 microSD**。
→ 先 `make shutdown` 或手柄关机手势，等系统关干净再断电。

---

## 舵机 / 校准

**飞特 FD 调试软件：先装驱动、用最新版、波特率选 1 Mbps**
现象三连：插上 URT-2 一颗舵机都扫不到；装完驱动能连了，但舵机型号读出来是 `unknown`；或者能连就是扫不出来。
原因：① URT-2 的 USB 转串口芯片要装驱动，设备管理器里没有 COM 口就是没装；② FD 版本旧，型号表里没有 HD-1910 这种定制型号，认不出就显示 unknown，**但寄存器读写完全正常**；③ HD-1910 出厂波特率是 1 Mbps（寄存器 6 = 0），FD 里波特率不选 1000000 就扫不到。
→ 顺序：装驱动 → 设备管理器确认有 COM 口 → FD 里波特率选 1000000 → 用[飞特官网](http://doc.feetech.cn/)最新版 FD。型号显示 unknown 不用管，别以为舵机坏了。

**HD-1910 的位置计数方向跟官方 XL330 相反，15 颗全反**
现象：拖滑块时 3D 模型跟实际反着动；按官方站姿发角度，腿往反方向弯。
原因：HD-1910 读数增大的方向跟 XL330 相反，而机械装法是照搬官方的，所以每个关节都整体反了一次 —— 是全体反，不是个别几颗装反了。
→ 15 颗方向全取 −1：[`tools/servo-web/directions.json`](tools/servo-web/directions.json)，robotd 里是 `[bus.feetech] directions`。网页上每颗旁边的 ± 按钮逐颗核对过。

**HD-1910 不认「扭矩开关写 128」这种中位校准**
现象：内存表里明写着「写 128：任意当前位置较正为 2048」，照着做舵机回「成功」，但偏移寄存器（31）一个都没变。代码要是接着把目标位置写成 2048，关节反而被拉回旧零位。2026-09-20 实测 4 轮 15 颗，解锁、扭矩关着也一样。
原因：固件 3.46 不支持这条。协议手册 4.9 的支持表里写着：SMS ≤2.54 和 STS ≥3.10 支持写 128，**HLS ≥3.43 不支持**，只支持 0x0B —— HD-1910 的表现跟 HLS 那一行一致。
→ 用 **0x0B 位置校准指令**（不带参数 = 校成 2048，带参数 = 校成指定读数）。校完一定回读位置和偏移确认，别信应答里的「成功」：飞特很多不支持的操作照样回成功。

**校准时别关着扭矩等**
现象：关扭矩后等几十毫秒再读位置，颈部（30）读数掉了 80 步（7°），校出来的零位是歪的。
原因：扭矩一关关节就被重力压下去，等得越久掉得越多。
→ 关扭矩到校准完成中间不要 sleep，几毫秒就够；校准后立刻把目标位置写成新读数再开扭矩。

**舵机的 D（微分、阻尼）跟走路发颤有关**
现象：2026-10-13 R17 默认 P5/D20，走路时机身晃动里一半是 4 Hz 以上的颤（51%），步子节奏乱。新卡 V164 用的是出厂 D=40。
原因：训练用的 BAM 舵机模型（参数是陆吾公开的 1910 M6，`kp_fw=5` 即固件 P=5）没有硬件 D 这一项，真机却带着 D。D 改成 0（同时转矩 1000→850）后，颤降到 4～8%。为什么 D 会引起颤，「阻尼吃掉纠正动作」只是假设，跟随数据没证实。
→ 先把 D 设成 0 去掉颤。但 D=0 后撑地膝盖更伸不直，还出现了机身前后点头、左脚尖朝下（D=20 时没有），中间值 D=5～10 值得试。D=0 时 P 越大越晃：P5 晃 56°/s，P4 晃 44°/s，P3 晃 30°/s（仿真 31°/s）。我们现在用 P3 / D0 / 转矩 700，代价是抬脚更低。数据见 [10-13 夜上机记录 §5](docs/HD1910-20261013-夜-掉电-舵机D与蹭地.md#5-走路发颤跟舵机的-d-有关)。

**kissqy V164（一键镜像）不写 D 和转矩限制，中控里的 P/D/转矩框改了也没用**
现象：新卡中控「高级参数」里改 P、D、转矩限制，上力后舵机寄存器没变。
原因：V164 只写模型包里约定的 P（5，kissqy 叫「部署合同」），51 号 D、48 号转矩限制留在舵机出厂值（D=40、1000），这是他有意的设计（他的设计文档写的是「保留设备当前值」）；R17 里「测试参数」那条路被删了。HD-1910 出厂 EEPROM 是 P32 / D40 / I0。
→ 要调就用 R17；或者在 robotd 停掉、15 颗卸力后写舵机 RAM（断电恢复，手柄十字键右「重启舵机」也会恢复）；或者把 EEPROM 里的 D 改成 0（一次改好；只对不写 D 的 V164 有效，R17 上力时会写自己的 D，要配合测试参数里的 kd）。上力前舵机里的原值看 `robot.busStatus` → `native.hd1910.registers_before_arm`。
**补充（10-14）**：V164 配套的中控 1.0.164 里本来就没有 P / D / 转矩这三个框（有这三个框的是 R17 配套的旧中控 1.0.146；旧中控连 V164 的板子，改了也不生效）。我们在本地把 V164 的这几样放开了（未上机、不公开），见 [10-14 白天记录 §8](docs/HD1910-20261014-白天-仿真找原因与新版放开参数.md#8-新版v164放开-p--d--转矩限制和头腿滤波本地未上机)。
**补充（10-14 晚）**：kissqy 10-14 发布 V167 / control.43（中控 1.0.167），说明是「修复鸭身抖动」：每次 HOME 上力，把 15 颗舵机 RAM 里的 D 写成 0、转矩限制写成 1000，P 仍用模型里的 5；这两个值是固定的，中控里调不了；卸力时只恢复 P，D 留在 0，直到舵机断电。跟我们 10-13 夜的结论一致（同一张桌面，D20 时颤占 51%，D0 后 4～8%）。注意：用 IMU 模块（BNO085 等）的鸭子，别直接点他中控的「安装 / 升级固件」：他的安装包带的是他自己的 robotd，不认 IMU 模块，升级后读不到 IMU、上不了力（见「软件」里「装了自己改过的 robotd，别在 kissqy 中控里点『安装 / 升级固件』」）。

**舵机的 P / D / 转矩限制写在 RAM 里：每次上力写、卸力恢复，断电回到出厂值**
现象：2026-10-14 用户问：中控里设的 P / D / 转矩是一直有效，还是每次都要重写？舵机断一次电，或者按手柄十字键右（重启舵机）以后，读寄存器看到的又是出厂值 D40 / 1000。
原因：R17 和我们在 V164 上做的可调版，每次 HOME 上力时把转矩限制、P、D 写进舵机 **RAM**（48～51 号寄存器），写之前先记下原值，卸力时写回去；V164 原版只往 RAM 写 P（50 号）。EEPROM 都不动。舵机一断电，RAM 就从 EEPROM 重新载入（HD-1910 出厂 P32 / D40 / I0、转矩限制 1000）。设的值存在板子上的文件里（`/etc/robot/feetech-ft5/servo-test-parameters.json`），下次上力会自动再写，所以设一次就一直有效，不用每次重设。
→ 确认生效看 `robot.busStatus` → `native.hd1910.servo_parameters`（robotd 加载的值）和 `temporary_gains_applied: true`（已写入并回读核对）；`registers_before_arm` 是上力前读到的原值，不是设进去的值。有一个坑：**上着力时 robotd 被重启过**（崩溃、手动 restart、上着力装程序），记下的原值就丢了。V164 和可调版的 robotd 一启动就先把全部舵机卸力（鸭子当场瘫，扶好），下次 HOME 时把舵机里残留的测试值当成原值记下；R17 启动不卸力，只核对值跟文件是否一致（不一致就拒绝 HOME，见下面「用别的程序上了力再切到 kissqy」）。两种都会让测试值一直留在 RAM 里。继续用这组参数没影响；但切回只写 P 的原版行为以后（删掉参数文件，或中控「恢复默认」），D 和转矩会停在测试值。这时给舵机断一次电。详见 [10-14 白天记录 §8.3、§8.4](docs/HD1910-20261014-白天-仿真找原因与新版放开参数.md#83-舵机参数是怎么生效的写-ram不写-eeprom)。

**站 HOME 时两只脚左右方向不共面：两个髋横滚往外劈，每次不一样（推测是被体重压的）**
现象：按舵机读数做正运动学，站 HOME（或走完停下）时，两只脚掌在左右方向不在一个平面上。2026-10-14 把 14 段都算了一遍，相对 HOME 差 0.6°～13°，每段都不一样。一开始怀疑是髋横滚零位差了。
原因：拆到每个关节（[`tools/gait-analysis/home_roll.py`](tools/gait-analysis/home_roll.py)），差别全部来自左右两个髋横滚没跟到 HOME 目标，方向每次都是左 +、右 −（腿往外劈），大小每次不同（0.2°～6.9°）。按仿真几何，地面托脚的力落在髋横滚轴外侧约 23 mm，正好把腿往外掰，像是被体重压的（推测；偏多少跟 P 的关系，数据里看不出来）。仿真里的策略站着时也有同方向的误差（左 +1.6°、右 −1.8°），真机多数在同一量级。
→ 每次都变的那部分不是零位，别为它去改零位。但要知道：这个方法比的是「读数 − 目标」，两者是同一个零点，**零位本身偏没偏，它看不出来**。仿真模型站 HOME 时，两只脚本来就是外侧边低约 2.3 mm，往外劈一点反而变平，劈多了变成内侧边低；真鸭子哪边翘，站 HOME 时从正前方贴着桌面看透光，以实物为准。10-14 上午我们口头说过「外侧边翘起」，14 段里 12 段正好说反了，以这条为准。详见 [10-14 白天记录 §7](docs/HD1910-20261014-白天-仿真找原因与新版放开参数.md#7-站-home-两只脚左右方向不共面两个髋横滚往外劈每次不一样)。

**嘴的舵机发烫：一直顶着闭合位，又挨着主板（kissqy 的解释）**
现象：嘴部舵机摸着烫。我们 2026-10-12 夜实测，鸭子站着时嘴部舵机就有 60～70°C。
原因：kissqy 在群里解释：嘴的位置设在 −5°（闭合位），闭上以后还在使劲顶，一直出力；嘴又离主板最近，被主板的热烤着。他说「一直咬合也就 40 来度」，不是舵机坏了。他说的温度比我们测的低，原因没查。
→ 先别急着换舵机。主板散热见下面「主板在机身里没有风道」。嘴的闭合位要不要往回放一点、别顶死，我们还没试。

**装 kissqy 的 R17，会把他样机的零位当成你的标定**
现象：2026-10-12 第一次装 R17，本机没有标定文件，安装后 `hd1910-calibration.toml` 里 15 个关节都是「已标定」，状态还显示「运动就绪」。可零位从 1372 到 2176 不等，方向有正有负（头部 ID 33 零位 1599），跟咱们这台对不上：咱们用 servo-web 校过，零位全是 2048，方向全是 −1。
原因：他的安装脚本在没有本机标定时，会用包里样机的标定补齐，并标记为已标定。他的说明里也写了「包内标定为样机参考，每台需核对」，但安装时没有拦一下。
→ 装完先打开 `/etc/robot/feetech-ft5/hd1910-calibration.toml`，换成自己的零位和方向，再按 `角度 = (读数 − 零位) × 方向 × 2π/4096`（跟 servo-web 同一个公式）算一遍各关节角度，跟实物姿势对上了才能上力。没对之前别点 HOME。

**kissqy 的一键镜像 R1 也预装了他样机的标定，而且 IMU 标成了「已确认」**
现象：2026-10-12 拆他的镜像，`hd1910-calibration.toml` 里零位是他那只鸭的（2281、2176……），方向全是 −1，`imu_mount_verified = true`；只有 `motion_enabled = false` 挡着。
原因：镜像是从他的样机做出来的。IMU「已确认」对的是他那块总线小板的安装方向，换一只鸭、换一种 IMU 都不成立。
→ 刷完先按上一条换成自己的零位和方向，IMU 安装方向重新确认，再碰 HOME 和运动开关。详见 [kissqy 镜像 R1 分析](docs/HD1910-20261012-kissqy镜像R1分析.md)。

---

## 主板 / HAT / 摄像头

**摄像头排线两端都要核对接触面，插进去了不等于接对了**
现象：Radxa Camera 8M219（IMX219）在 Armbian 和官方 B1 下都读不到芯片，报 `Reading register 100 from 10 failed`、`Error -5`；2026-09-28 用户发现排线正反面可能接反，调整后读到 `Model ID 0x0219`，并成功采集 40 帧 1920×1080 画面。
原因：本次调整排线方向/接触后故障消失；仅凭插头已插入或排线颜色，无法确认触点接通。
→ **正常关机、切断所有供电，再检查两端裸露金属触点是否对准插座内的金属弹片，平直插入并锁好。** ZERO 3W 配 Radxa 8M219 用 **22 pin / 0.5 mm → 15 pin / 1.0 mm、同面触点**排线；“同面”指自然平铺时两端裸露接触区在同一侧，不是覆膜下面看得见的铜走线。

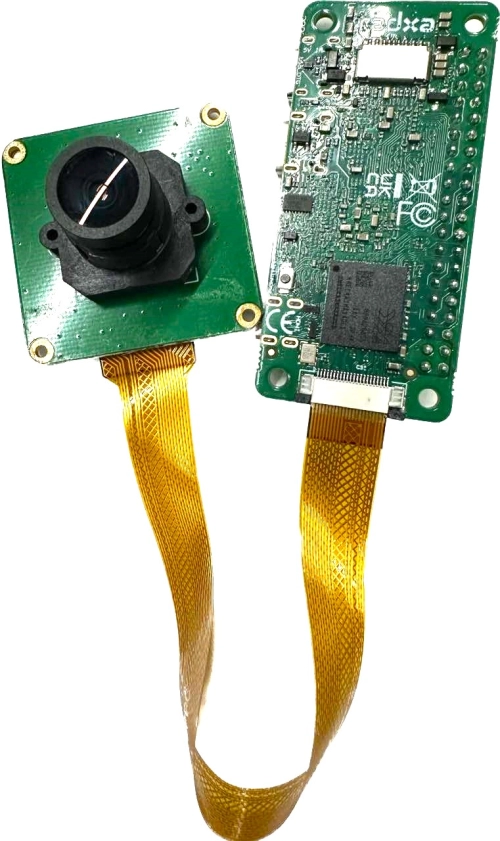
[picture p50: assets/hw/radxa-camera-cable-reference-20260928.png]
用户提供的摄像头排线接线参考：左侧为镜头面，右侧为主板背面，排线呈 U 形


*用户提供的接线参考图：左边可见镜头，右边可见主板背面的 Radxa / UKCA 标识。核对整体相对朝向后，还要检查各自插座内的触点；不同模组不要只照镜头朝向或排线文字面插。此图用于接线提醒，不是本次采集画面。*

**看见 `/dev/video0`，不代表摄像头已经识别**
现象：相机不应答时，板上仍有 `/dev/media0` 和 `/dev/video0..9`。
原因：这些可能只是 Rockchip ISP 接收端节点，传感器并未绑定。
→ 依次确认芯片 ID、`imx219` 驱动绑定、`media-ctl -p` 中的传感器实体，最后实际抓帧；[本次完整命令与结果](tools/radxa/摄像头调试记录-20260928.md)。

**两个 Type-C 口不能按“一个供电、一个接电脑”来猜**
现象：把电脑接到 USB 3.0 Host 口，期待出现主板的 USB 串口。
原因：`5V IN / USB_OTG` 才是供电兼 USB 2.0 gadget 口，USB 3.0 Host 是接 URT-2、U 盘等外设的口；是否出现 COM 还取决于系统有没有配置 gadget 串口。
→ **HAT 已供电时用 Wi-Fi + SSH 调试**；V1.12 的 40 针 5V 与 OTG VBUS 同网，不能再用普通 USB 数据线引入电脑的第二路 5V。需要切换 USB 供电，先关机并断开 HAT 输入。7.4V 只能进 HAT 对应输入，不能直接进主板 5V 或 USB-C；见[镜像使用说明](tools/radxa/镜像使用说明.md#3-第一次开机)。

**绿灯双闪可以是正常心跳，不是单独的故障码**
现象：本次官方 B1 绿灯双闪，但 Wi-Fi、SSH 和摄像头都正常。
原因：LED 配置是 `heartbeat`；以前启动失败时也见过双闪，不能把当时的伴随现象当成通用诊断。
→ 结合网络、SSH、启动日志判断系统是否起来，别只凭灯效重刷卡。

**换官方镜像做对照时，接线也变了，就不能只归因镜像**
现象：官方 B1 起初也读不到相机，调整排线后才出图。
原因：镜像和接线不是在同一条件下完成全部复测；本次只能确认官方配置下相机识别与短时采集通过。
→ 保留已成功的接法，再按需要复测原 Armbian；不要直接宣布原镜像坏了，也不要把 40 帧短测当成 30 fps、长期稳定或 HAT 全功能验收。

**主板过热降频：网页服务常驻占满一个核，控制节奏被拖慢**
现象：2026-10-11 跑策略时控制周期从 20 ms 变成 25 ms，读传感器最慢 20 ms；主板 CPU 84–87°C，`scaling_max_freq` 被压到最低档 408 MHz（最高 1800）。
原因：`servo-web/server.py` 常驻时 top 显示占满一个核（100%），主板装在机身里散不了热；RK3566 到 85°C 降频。
→ 跑策略前停掉网页服务（`systemctl stop microduck-servo-web`），给主板开壳或加风扇；跑之前看一眼 `/sys/class/thermal/thermal_zone0/temp` 和 `/sys/devices/system/cpu/cpufreq/policy0/scaling_max_freq`。网页为什么占满 CPU 还没查。

**主板开机一两分钟后死机，绿灯常亮不闪**
现象：2026-10-11 上电后 SSH 能连，约 2 分钟后从网络消失，路由器也找不到，绿灯从闪变成常亮。断电重启后正常，之后一晚上没再出现。
原因：未定。绿灯常亮说明内核心跳停了（死机），不是 WiFi 断。那次开机的日志没写进卡里，查不到。当时用的是 7.4 V 可调电源。
→ 再出现时先记下电源表头的电压、电流，再断电重启；别反复上电。

**没接摄像头和 ToF，官方的 mediad、tofd 会不停重启，把主板烧热**
现象：2026-10-12 装完官方 0.15.1，主板 89–90°C，CPU 锁在最低档 408 MHz。top 里 mediad 的 `gst-plugin-scanner` 占满一个核（99.5%），tofd 也一直在重启。
原因：没接摄像头，相机服务一启动就崩溃，systemd 不停地拉起它，每次都要重新扫一遍 GStreamer 插件；tofd 找不到测距传感器也一样。群里网友也说过，关掉用不到的服务温度就下来了。
→ 没接这两样就 `sudo systemctl disable --now mediad tofd`，以后接上再 `enable --now`。关掉后 2 分钟降到 85°C，但仍在降频线上，还得加散热（见下一条）。

**主板在机身里没有风道，关了服务也会热到 92°C**
现象：关掉 mediad、tofd 之后，只跑 robotd，鸭子站着，温度又慢慢升到 92.5°C，CPU 一直是 408 MHz。上力回读超时是 CPU 太慢引起的；网页摇杆没反应也被它拖得更严重（根因不止过热，见[软件](#软件)）。2026-10-12 夜服务都关了、SSH 重连也去掉以后，模型一跑约 10 分钟 CPU 还是到 85°C、降到 408～600 MHz（robotd 跑模型占一个核的 30%～46%）。
原因：主板在机身里没有散热片，也没有进出风的路。RK3566 到 85°C 就降频，降到最低档后所有程序都变慢。
→ 先在头壳或机身上开几个孔，最简单，能散掉一部分热。真要散得下来，关键是**风道**：有地方进风、有地方出风，风扇不一定要贴在主板上。上机前看 `/sys/class/thermal/thermal_zone0/temp` 和 `/sys/devices/system/cpu/cpu0/cpufreq/scaling_cur_freq`，频率在 408000 就是在降频。

**走路、站起时整机掉电重启：是供电，不是软件**
现象：2026-10-13 新卡、旧卡都在走路或站起时突然断电重启，录像和系统日志同时中断，没有关机过程。新卡（D=40）模型接管 13 秒就掉，最后一刻舵机读到约 3.9 V；旧卡（D=20）接管 42 秒，中间摔倒起身一次，起身后约 11 秒断电，断电时摇杆是 0。
原因：十几颗舵机一起发力的电流冲击，电源和线撑不住，主板 5 V 是 HAT 从同一路电降压出来的，跟着掉。D 越大，模型纠正越频繁，冲击可能越多（新卡还开着声音，一次对一次下不了结论）。robotd 报的电压每 0.5～1 秒一个点，看不到几十毫秒的跌落。
→ 用电池或大电流电源（10 A），线用 16～18 AWG、尽量短、XT30/XT60 接头，输入端并 1000～2200 µF 电容。想分清是主电源还是 HAT 给主板那一路：主板 USB-C 另接充电宝单独供电再走。kissqy 仓库曾经写过「LM5050 余量不足导致重启」，他 10-12 已删（作者更正），别引用。详见 [10-13 夜上机记录 §2](docs/HD1910-20261013-夜-掉电-舵机D与蹭地.md#2-整机掉电是供电不是软件)。

**HAT 的 J5 接外接 IMU 模块，先看板子上已经有哪些芯片占了地址**
现象：J5（40 针 3/5 脚，I2C3）这条线上本来就挂着板载芯片：两版都有音频 aic3104（0x18）；C1 版（咱们手上这块）还有 BMI088，加速度计 0x19、陀螺 0x68；D1 版（官方最新）换成了 LSM6DSV16X，0x6A。
原因：I²C 靠地址区分设备，两颗芯片同一个地址就会互相打架、谁都读不对。外接 BNO085（0x4A/0x4B）两版都不冲突；外接 LSM6DSV16X 在 D1 上如果也用 0x6A，就撞上板载那颗了。
→ 接之前先 `i2cdetect -y 3` 看清已占用的地址；D1 上的外接 LSM6DSV16X 用 0x6B（SA0 接高），robotd 里显式写 `i2c_address = 0x6B`。板载 IMU 在头里，只能当头部 IMU，外接模块要装在躯干上。不想占 J5 可以把 J6 改成 I2C4（拆 R18/R19、短接 R16/R17）。C1/D1 逐个焊盘的对照见 [kissqy 镜像 R1 分析 §9](docs/HD1910-20261012-kissqy镜像R1分析.md#9-hat-上接-imu-模块c1旧版咱们手上这块和-d1官方最新版对照)。

**IMU 模块接触不良：robotd 判 IMU 过期，鸭子直接卸力**
现象：2026-10-12 夜鸭子突然软下去，按 Start 回 `nothing to bring up state=Limp`，`robotctl health` 显示 `orientation frozen`，robotd 日志 `trunk IMU reader fault … No such device or address (os error 6)`。
原因：BNO085 在 I²C 上不应答了（地址没人回）。77 次断线时舵机电压都在 7.3～7.5 V，不是供电；多数在走路晃的时候，也有几次在完全静止时，说明某个点已经松了。robotd 把 IMU 不更新当成读取失败，连续失败就卸力保护，这本身是对的；IMU 恢复后驱动会自己重新认到。
→ 线焊牢或用带锁扣的插头，两头用热熔胶固定，过脖子的地方留余量；焊完按下面的零点校准复查一次。[`imu_fault_ctx.py`](tools/radxa/onboard-analysis/) 能把每次断线对上当时在干什么、电压多少。

---

## 软件

**电脑开着 Clash 的 TUN 模式，ping、SSH、网页都连不上主板**
现象：2026-10-11 主板明明在线（扫端口 22 是开的），电脑 ping 不通，SSH 报 `Error reading SSH protocol banner`，浏览器开 `http://192.168.0.102:8080` 报 502。
原因：Clash Verge 的 TUN 虚拟网卡（Meta）接管了包括局域网在内的全部路由（`Find-NetRoute` 显示走 Meta），到主板的连接被它截住。
→ 临时关掉 TUN，或在 Clash 里把 `192.168.0.0/16` 设成直连。不想动 Clash 时，程序里把连接绑到有线网卡的本机地址（Python `socket.bind(('192.168.0.100', 0))` 再连主板）就能绕过去；网页可以在本机做个端口转发，或者用手机打开。

**kissqy 一键镜像上，G50 Pro 配对成功几秒就被断开**
现象：2026-10-13 新卡（kissqy R1 镜像），手柄拨 S 档，`bluetoothctl pair` 显示成功，接着就断开，padd 读不到。旧卡同一个手柄没问题。
原因：这张卡开机时蓝牙是不可绑定的（原因没查清），配对回 No Bonding、密钥存不下，BlueZ 默认 `ClassicBondedOnly=true` 只收已绑定的 HID，于是拒绝。官方 setup-board 有意把 `/etc/bluetooth/input.conf` 的 `UserspaceHID` 设成 false（手柄走内核，省一个核约 16% 的 CPU，官方板上配对没问题），它有没有参与没验证。
→ 配对前 `btmgmt bondable on`，然后 `pair` → `trust` → 马上 `connect`，成功后能看到 `Nintendo Switch Pro Controller` 和 `hid_nintendo`。我们当时还把 `input.conf` 改成 `UserspaceHID=true`、`ClassicBondedOnly=false`，几项一起改的，**只成功过一次，后来两次没配上**；`UserspaceHID=true` 会多吃 CPU，下次先试只开 bondable。

**G50 Pro 只记得最后配对的那张卡，换卡要重新配**
现象：手柄跟新卡配过以后，换回旧卡，手柄连不上旧卡。
原因：手柄只存最后一次配对的密钥，旧卡里存的还是之前那把，对不上。
→ 每次换卡都在当前卡上重新配一次（上一条的流程）。

**鸭子用的固定 IP 被局域网里别的设备占了，电脑时连时不连**
现象：2026-10-13 旧卡用静态 192.168.0.102，同一时间局域网里另一台设备（看网卡地址像手机）也拿到了 .102，电脑连鸭子时好时坏。
原因：路由器的 DHCP 不知道鸭子手动占用了这个地址，又把它分给了别人。
→ 在路由器里给鸭子做「静态地址分配」（按 MAC 绑定），或者把鸭子的固定 IP 设在 DHCP 范围之外。临时办法：先关掉占地址的那台设备的 WiFi，或在电脑上用管理员把这个 IP 静态绑到鸭子的 MAC（`netsh interface ip add neighbors`，电脑重启失效）。

**整机掉电以后什么日志都没有：Armbian 的日志在内存里**
现象：掉电重启后翻 `journalctl`，只有这次开机的；我们自己的录像最后几秒也没写进卡。主板没有 RTC，时钟每次开机回拨，按时间也找不到是哪个文件。
原因：Armbian 默认把日志放 zram（内存），不落盘是有意保护 SD 卡；Python 的文件缓冲几秒才写一次。
→ 录像和系统日志各开一个服务，**每秒 fsync 一次**，文件名带开机编号（`/proc/sys/kernel/random/boot_id` 前 6 位）。脚本 [`tools/radxa/onboard-analysis/`](tools/radxa/onboard-analysis/) 的 `duck_rec.py`、`duck_journal.py` 和两个 service。不要关 zram（见下面「别关 armbian-zram-config」）。

**Armbian 出厂 `overlay_prefix=rk35xx`，RK3566 的 overlay 却叫 `rk3568-*`**
前缀不对，加载器什么都找不到、静默失败，板子正常启动，**但没有 `/dev/ttyS2`**。你会以为是线接错了。`apt upgrade` 换内核后可能打回原形。
→ `/boot/armbianEnv.txt` 里改成 `overlay_prefix=rk3568`，加 `overlays=uart2-m0`，重启。官方 `setup-board.sh` 就干这个。

**内核 console 默认也在 ttyS2 上**
UART2 是 RK3566 的调试串口，Armbian 把内核日志往那打 —— 也就是往舵机总线上打。
→ `/boot/armbianEnv.txt` 的 `extraargs` 里去掉 `console=ttyS2,1500000`。

**Armbian 默认在 UART2 上跑登录控制台**
`agetty` 占着 `/dev/ttyS2`，舵机怎么都不通。线接对了也不通，八成是它。
→ `systemctl mask serial-getty@ttyS2`，然后 `fuser -v /dev/ttyS2` 确认没别的进程。

**别关 armbian-zram-config**
Armbian 默认把日志放 zram（内存）里不落盘，是在保护 SD 卡。有人为了看日志方便把它关了，写入量翻几倍。
→ 留着。官方 `deploy/README.md` 原话：不落盘是「有意的安排」，关掉是「每块板自己的决定，不是默认」。

**i2c3 用 pin 3/5 会失去 USB-C PD 协商**
RK3566 的 i2c3 原厂跑在 M1 pinmux 服务 FUSB302（USB-C PD）。官方 overlay 把它 mux 到 M0（pin 3/5）并禁用 fusb302。
→ 接受这个代价：USB-C 仍给 5 V，只是不协商。机器人供电走电池，跟这无关。

---

**`wsl --mount` 挂不上 USB 读卡器，别指望它往烧好的卡里写文件**
想用 WSL2 把 Armbian 的首次开机预设 `.not_logged_in_yet` 写进卡的 ext4 根分区，`wsl --mount \\.\PHYSICALDRIVE2 --partition 1` 直接报 `Wsl/Service/AttachDisk/MountDisk/HCS/ERROR_FILE_NOT_FOUND`。这是 WSL 对 USB 可移动盘的限制，跟卡烧没烧好无关。
→ 反过来做：先把文件塞进镜像再烧。WSL 里解压 `.img.xz` 到本地盘（不能放 `/mnt/` 下，loop 挂不了），`mount -o loop,offset=$((32768*512))` 挂根分区写文件，再烧生成的 `.img`。脚本在 [`tools/radxa/`](tools/radxa/)。

**此前测试的 Armbian 镜像在 Zero 3W V1.12（AIC8800 WiFi 版）上启动卡住：要结合日志与系统盘判断**
2024-11 以后出厂的 Zero 3W 是 V1.12，Armbian 26.2.1 / 26.8.1 的 vendor 镜像烧上去，灯有心跳双闪（内核起了），但根本进不了 initramfs，系统盘一个字节都没被碰过，局域网里永远找不到。
瑞莎官方镜像同一张卡同一块板一次就起。逐项排除（卡、SDR104 高速模式、供电、设备树全一样）后，差异只剩引导程序：
Armbian 给 zero3 配的是主线 U-Boot 2025.10 + 2024-01 的内存初始化固件 v1.21；瑞莎自家是 rk U-Boot 2017.09 + DDR v1.23（2024-09）+ BL31 v1.45。
→ 把瑞莎 `u-boot-rk2410` 包里的 `idbloader.img` / `u-boot.itb` 写到卡的扇区 64 / 16384，再给 Armbian 写一个 `/boot/extlinux/extlinux.conf`（瑞莎 U-Boot 走 extlinux，不读 boot.scr），内核和系统一字不改，立刻起来。
脚本在 [`tools/radxa/`](tools/radxa/)，一键做卡。没串口也能定位这种问题的办法：读卡看根分区有没有被写过、在 initramfs 里塞 LED 信号和黑匣子日志。

**V1.12J（2026-09 这批）光换引导还不够，设备树也得换**
现象：按前一条换了瑞莎引导，Armbian 还是起不来；瑞莎官方 B1 镜像能起。有人还碰到冷启动插着 HDMI 就不开机。
原因：这批板子的 WiFi 换成了 AIC8800DS2，Armbian 自带的 `rk3566-radxa-zero3.dtb` 不认；瑞莎 B1 镜像里那份认。
→ 引导和 **DTB 都从 B1 镜像里拿**，extlinux 的 `fdt` 指向拷过来的那份，内核和根文件系统留 Armbian 的
（两边都是 6.1 vendor 内核，能混）。群友 2026-09-20 实测跑通。换 DTB 后记得验 `/dev/ttyS2` 和 USB 串口还在不在，
overlay 是 Armbian 的，节点不一定对得上。命令见[镜像使用说明](tools/radxa/镜像使用说明.md#6-如果你的板子不是这一批)。

**换成瑞莎引导以后，改 `armbianEnv.txt` 不生效**
现象：在 `/boot/armbianEnv.txt` 的 `overlays=` 里加了 overlay（比如 `i2c3-pihat`），重启后 `/dev/i2c-3` 还是没有；官方 `setup-board.sh` 改它也一样，脚本自己的检查却说已经配好。
原因：瑞莎 U-Boot 只读 `/boot/extlinux/extlinux.conf`，不跑 Armbian 的 `boot.scr`，而读 `armbianEnv.txt` 的正是 `boot.scr`。
→ overlay 要写进 `extlinux.conf` 的 `fdtoverlays` 那一行，写 dtbo 的完整路径（`/boot/dtb/rockchip/overlay/rk3568-xxx.dtbo`），先确认文件存在再重启。

**AIC8800 不支持 GCMP-256，路由器开了 WPA3 混合模式就连不上**
Zero 3W V1.12 的 AIC8800D80/DS2 只有 CCMP-128。家用路由器（TP-LINK 之类）默认 WPA2/WPA3 混合，WPA3 那半用 GCMP-256，握手失败。
→ wpa_supplicant 里强制 `key_mgmt=WPA-PSK`、`pairwise=CCMP`、`ieee80211w=0`（做卡脚本已带），或者路由器改成纯 WPA2。5 GHz 和 2.4 GHz 都能连。

**板子插电脑没有 USB 串口：要 `dwc3-peripheral` overlay**
Zero 3W 的 OTG 口设备树写的是 `dr_mode = otg`，Armbian vendor 内核下插电脑不会自动切成设备模式，`g_serial` 加载了电脑也看不见。
→ extlinux 里挂 `rk3568-dwc3-peripheral.dtbo`（Armbian 自带），再 `g_serial` + `serial-getty@ttyGS0`，插电脑就多一个 COM 口，root 直接登，救急神器。做卡脚本已带。

**板子上跑官方脚本，GitHub 下不动**
`setup-board.sh` / `install.sh` 都从 raw.githubusercontent.com、api.github.com、objects.githubusercontent.com 下东西，国内直连基本卡死（IPv6 优先更糟）。
→ 电脑上的 Clash 开「允许局域网」，板子 `/etc/environment` 写 `http_proxy=http://电脑IP:7890`（做卡脚本 `card.conf` 里 `HTTP_PROXY=` 填上就行）。apt 走 Debian 源不用代理。
注意：官方安装是由 updaterd 去调用安装钩子的，钩子里的 curl 不读 `/etc/environment`。2026-10-12 下 ONNX Runtime 时直连 90 秒超时，给 root 写 `/root/.curlrc`（一行 `proxy = "http://电脑IP:7890"`）后两秒下完，装完记得删掉。

**官方 install.sh 只装最新版，kissqy 的 R17 要的是 0.15.1**
现象：kissqy 的 R17 叠在官方 `daemon-v0.15.1` 上，官方 10-07 已经出到 0.16.1，`install.sh` 永远装最新版，没有指定版本的开关。
原因：脚本让 updaterd 自己去 GitHub 找 latest。
→ 先把 `daemon-v0.15.1` 的发布文件下到本地，复制一份 `install.sh`，把发布标签写死成 `daemon-v0.15.1`，`updaterd install` 加 `--from <本地目录>`。签名校验照样做。改好的脚本在 `Radxa-Zero3W/official-daemon-v0.15.1/scripts/install-local.sh`。装完把 `/etc/robot/updater.toml` 的 `auto_apply` 改成 `"off"`，免得它自己升级。

**不用声音就别跑官方 setup-board.sh 的音频部分，远程也别跑 migrate-network.sh**
现象：`setup-board.sh` 的音频步骤会 apt 装 Armbian vendor 内核，并把 `/boot/Image`、`dtb`、`uInitrd` 指到新内核；`migrate-network.sh` 会把 WiFi 从 netplan 切到 NetworkManager。
原因：V1.12 这块板要靠瑞莎的 U-Boot 和 `extlinux.conf` 才能启动，远程换内核有开不了机的风险。这一步只为启用 HAT 上的音频芯片，走路用不到声音；没装 HAT 就更用不上了。切网络万一 WiFi 断了，远程就连不回来了。
→ 不要声音时这两个都不用跑：舵机串口 overlay 和串口控制台让位，做卡时已经弄好了。走路只需要官方 `install.sh` 装好的那几个服务。

**装 kissqy 的 R17，系统里没有 aic3104 声卡会卡在音频设置**
现象：`service.sh upgrade` 停在 `alsactl store aic3104`，退出码 19，提示「安装未完成；阶段：audio-setup」。
原因：他的安装脚本默认这张声卡一定在。没装 HAT，或者装了 HAT 但没跑官方 `setup-board.sh` 的音频那一步（2026-10-12 第一台就是这样），系统里都只有 HDMI 声卡。
→ 咱们的分支已经修了（没有这张声卡就跳过音频设置，不影响走路）。用他的原版包时，可以先改他包里的 `voice-setup.py`，再重新算一遍 `SHA256SUMS`。

**kissqy 的一键镜像 R1 用的是 Armbian 原版引导，V1.12 板可能起不来**
现象：2026-10-12 拆他的镜像 R1，引导区是 Armbian 主线 U-Boot 2025.10 + 内存初始化固件 v1.21，走 `boot.scr`；咱们第一台（V1.12，AIC8800）9 月就是卡在这套组合上的。
原因：他的板子能开，说明他那一批跟这套引导合得来；V1.12 是不是都不行没法一概而论，但咱们这块确定不行。
→ 用 [`tools/radxa/kissqy-r1-v112.sh`](tools/radxa/kissqy-r1-v112.sh) 在他的镜像上换瑞莎引导、写 extlinux（他的 overlay 原样搬过去），其余不动。离线验证过：引导区跟瑞莎包逐字节一致、分区表没动、根分区只改了预期几处。**还没上机**，先用空卡试，别拿正在用的卡烧。V1.12J 可能还要按上一条换设备树。

**kissqy 的一键镜像 R1 只认总线上的 IMU 小板，IMU 模块用不了**
现象：镜像里的 robotd（control.40）只有读 ID 200 的代码，要求小板身份是 `06 00 00 00 F2`（他的 FT6 固件），没有读 I²C IMU 的代码；启动配置也没开 I2C4。用 BNO085、LSM6DSV16X 模块的鸭子刷上去，会卡在「Feetech ID 200 无应答」。
原因：他的整套是按他自己的硬件做的。咱们给 robotd 加的 I²C IMU 支持（分支 `hd1910-trunk-imu-i2c`）是在 v146 源码上写的，他 V164 的源码还没公开。
→ 用 IMU 模块的，先继续用自己装的 v146 + I²C IMU 那套（见 [10-12 上机记录](docs/HD1910-20261012-kissqy整套上机.md)）；等他公开 V164 源码再把补丁移植过去，或者请他合进镜像。

**`service.sh init` 在 robotd 运行时发不出 HOME**
现象：运动模式下 `sudo bash service.sh init` 报 `cannot claim robot IPC socket … another robotd owns this socket`。
原因：`robotd init` 这个子命令要独占 robotd 的锁，只适合 robotd 没在运行时用。他的中控是通过 `/run/robotd.sock` 发 JSON-RPC（每行一条，`{"jsonrpc":"2.0","id":1,"method":"robot.init","params":{}}`）。
→ 用中控的 HOME，或者自己往套接字发 `robot.init`。启用、停止策略用 `robot.enable`（`{"on":true}` / `{"on":false}`），卸力用 `robot.relax`。

**网页摇杆按了没反应：四层原因叠在一起，不只是过热**
现象：2026-10-12 kissqy 中控（R17 v1.0.146）连上了，数据都正常，点网页手柄的 HOME、Start 没反应。中控日志写「输入已过期，未发送」或「timed out」，padd 偶尔报 `Failed to open "/dev/input/event4"`。
原因：每按一次键，都要新开一个 SSH 连接、按需启动 webpad、建一个虚拟手柄、等 padd 认到它，四层都慢。① Armbian 每次 SSH 登录白跑 3.8 秒欢迎脚本；② 中控规定 0.4 秒开不好通道就作废；③ webpad 冷启动加 padd 认手柄要 1～2 秒，点一下就松手，按键就丢了；④ padd 在系统登记完新设备之前就去打开，失败了不再试（让 padd 用 root 跑也一样，不是权限问题）。凌晨我们以为只是过热，过热只是让每一层都更慢。
→ 用蓝牙实体手柄（下一条），整条路都绕开。还要用网页手柄的话，先关 SSH 欢迎脚本（下下条），按键按住 1～2 秒再松。kissqy 在 V164 里已经把网页手柄改成直接走 robotd。逐层的测量见 [10-12 夜上机记录](docs/HD1910-20261012-夜-IMU校准与首次迈步.md#1-网页手柄按了没反应四层原因叠在一起)。

**雷神 G50 Pro 当实体手柄：背面拨 S 档，蓝牙直接配鸭子**
现象：手柄的 2.4G 接收器插在电脑上，对鸭子没用：中控网页不读电脑上的手柄；接收器又没法插到头里的主板上。
原因：官方和 kissqy 的设计都是蓝牙手柄直接配对主板，padd 读它。G50 Pro 背面的 X / S / T / D 是选平台，不是选有线、无线；S 档会装成 Switch 的 Pro 手柄，主板内核自带驱动，官方配对工具也支持。
→ 拔掉电脑上的接收器，背面拨 S，关机状态按住 HOME 到灯快闪；主板上 `sudo systemctl start configd`，再 `sudo robotctl pad pair`。搜不到就用 `bluetoothctl` 扫出 `Pro Controller` 的地址，`robotctl pad pair <地址>`。配好以后会自动重连。「≡」是 Start（第一下 HOME，第二下模型接管），「⧉」是 Select（卸力）。主板配置里 X 绑的是前滚翻，别乱按字母键。

**Armbian 每次 SSH 登录都白跑 3.8 秒欢迎脚本**
现象：SSH 登录慢；频繁开 SSH 的工具（kissqy 中控的手柄、ToF 通道）一用就超时，主板 CPU 也一直被占着。
原因：`/etc/pam.d/sshd` 里的 `pam_motd.so motd=/run/motd.dynamic` 让每次登录都跑一遍 `/etc/update-motd.d/`，其中 `20-ip-info` 一个就 2.9 秒，合计 3.8 秒。
→ 先备份，再注释掉这一行（`pam_motd.so noupdate` 那行留着）。改完经 SSH 的一问一答从 3～4 秒降到 0.7 秒。

**没接 ToF 时，kissqy 中控每 5 秒 SSH 重连一次**
现象：10 分钟里主板被 SSH 登录了 112 次，每次还要跑一遍上一条的欢迎脚本。
原因：tofd 关了（没接 ToF），中控订阅 ToF 失败后无限重试，每次重试都是一次完整的 SSH 登录。
→ 不接 ToF 就别让中控订阅它；我们分支的中控加了 `--tofd-socket ""`。

**手柄 Start 要按两下：第一下 HOME，第二下才是模型接管**
现象：站起来以后推摇杆没反应，日志 `the policy is not driving — press Start on the pad`；有时按了第二下，它又回了一次 HOME。
原因：第一下只是把关节锁到站姿，模型没开；第二下模型才接管，摇杆才管用。接管前 robotd 还要检查站姿：每个关节离 HOME ≤5°、机身倾斜 ≤10°，连续 3 帧，过不了就再回一次 HOME。
→ 站起来以后手拿开，等它自己站稳再按第二下。被拒了就看是哪条没过：膝盖塌了、IMU 偏了，还是身子歪了。

**Armbian 首次开机预设少两个变量会停在提示符上等人敲键盘**
`/root/.not_logged_in_yet` 里不写 `PRESET_DEFAULT_REALNAME` 会停在「Please provide your real name」，不写 `PRESET_CONNECT_WIRELESS` 且没网会停在「Connect via wireless? [Y/n]」。无头板子就此卡住，密码永远是出厂的 root / 1234。
→ 两个都写上（做卡脚本已带）。

**kissqy 的源码里有两份 `padd.service`，安装包装的是 `packaging/` 那份**
改 padd 的 systemd 设置（比如给 UDP 手柄放行 `AF_INET`）只改了 `padd/systemd/padd.service`，真机上不生效。kissqy 的安装脚本（`packaging/gamepad.py`）复制到 `/etc/systemd/system/` 的是 `packaging/padd.service`，`padd/systemd/` 那份是上游开发用的。
→ 两份一起改，再同步 `packaging/SHA256SUMS` 里那一行。已经装好的板子不重装，用 drop-in 补：`/etc/systemd/system/padd.service.d/` 下放一个 `.conf`。

**交叉编译 padd 报 `libudev-sys` 构建失败**
padd 读手柄用的 gilrs 要链接 libudev，`cargo board` 交叉编译时找不到 aarch64 的 libudev（robotd、robotctl 不依赖它，所以之前没碰到）。
→ 用仓库自带的 `scripts/cross-sysroot.sh` 从 Debian 拉 arm64 的包解成 sysroot，国内设 `DUCK_DEBIAN_MIRROR=https://mirrors.ustc.edu.cn/debian`；跑完把它输出的几行 `export` 照抄进当前 shell，再 `cargo board -p padd`。

**官方新版和 kissqy 版的接口版本号各自往上加，同一个数字含义不同**
想从官方新版搬功能到 kissqy 底子上时容易误以为「版本号相近就兼容」。kissqy 从官方 0.15.1 的 37 自己加到 40，官方从 37 加到 0.17.1 的 41，两边新增的接口不一样。
→ 搬功能时逐个核对要调的接口在 kissqy 的 robotd 里有没有（这次用到的 `sit_toggle`、`robot.policies.sitting`、两种叫声都核对过），不要整份套官方的客户端代码。

**kissqy 新版中控的「修复手柄连接」只认盖世小鸡 Nova 2 Lite，对 G50 Pro 没用**
现象：2026-10-13 晚上换 kissqy 新版（中控 R17 V164 1.0.164），雷神 G50 Pro 连不上；kissqy 建议点中控里的「修复手柄连接」。
原因：这个功能（`console/gamepad_repair.py`）是专门给盖世小鸡 GameSir Nova 2 Lite 写的：手柄名字写死在代码里，修复时清掉这次连接、重新配对，再走 gamesir-xboxd 把它转成虚拟 Xbox 手柄（kissqy 的说法：官方那套只认 Xbox 手柄，别的手柄蓝牙连上了、鉴权过不去，就卡在那）。遇到别的手柄，它直接拒绝，不会删 G50 Pro 的配对，所以对 G50 Pro 没用。G50 Pro 在新卡上连不上，我们查到的原因是另一个：蓝牙「不可绑定」，配对回 No Bonding（见上面「kissqy 一键镜像上，G50 Pro 配对成功几秒就被断开」）。
→ G50 Pro 按 [10-13 夜 §1.2](docs/HD1910-20261013-夜-掉电-舵机D与蹭地.md#12-g50-pro-配对上又被断开) 手动配对（`btmgmt bondable on` → `pair` → `trust` → 马上 `connect`），或者先用新版的网页手柄（kissqy 说已改成 SSH 常连）。想用他的「修复」功能，就买他配套的 Nova 2 Lite。

**装了自己改过的 robotd，别在 kissqy 中控里点「安装 / 升级固件」**
现象：这个按钮会把板子上的 robotd 换掉。我们给 robotd 加的 I²C IMU 支持、本地可调版设的 P / D / 转矩，都会被冲掉（看代码得出的，没真点过）。
原因：它装回的是 kissqy 安装包里自带的 robotd；他的安装脚本还会删掉 `servo-test-parameters.json`（有意的，用来清掉旧版的手动参数）。
→ 我们本地的中控连着我们的可调版板子时，会拦住这个按钮；用 kissqy 原版中控连上去，或者旧卡（R17 加 I²C IMU 补丁）用旧中控连上去，都没人拦，别点。真要回原版，用 kissqy 原版中控来装，装完给舵机断一次电（见「舵机的 P / D / 转矩限制写在 RAM 里」）。

## 策略训练与真机迁移

**运行程序优先在现成的上改，别自己另写一套**
现象：9 月底为了先测舵机和 IMU 写了 Python 运行器，后来一路长成策略运行器；10-11 拿它跑 kissqy 的模型，节奏、电压、方向、舵机参数都排除后仍不走，剩下的差别全在运行层，查不下去。
原因：策略对运行端很敏感，控制周期、动作滤波、关节速度晚不晚一帧、IMU 跟舵机是不是同一时刻读到，都要和训练、和原作者的运行端一致。另写一套，每个细节都是一个看不见的变量。官方 robotd 当时只支持 Dynamixel，咱们 9-18 fork 了它做飞特适配，卡在 IMU 没接上，才绕去写 Python。
→ 有现成能跑的运行端（官方 robotd、kissqy 的 R17）就在它上面改，缺什么补什么（比如给 robotd 加 I²C IMU）。自己写的小工具只用来测硬件（舵机体检、方向核对、单关节动作），不拿来跑策略。

**测行走模型别用手托着机身**
现象：2026-10-11 kissqy 的 walk 模型，手托机身时给 0 / 0.05 / 0.15 m/s 都只换一下姿势，之后几秒不动；放到地上不扶，0.4 秒内两腿就开始交替屈伸。
原因：这类模型输入里没有「节拍」，迈步靠身体晃动、重心转移，再经 IMU 和关节反馈带出来。机身被托住，身体不晃，输出很快停在一个静止姿势上。
→ 放地上，两手在两侧虚护 2–3 cm，倒了再接。速度 0 本来就是「站着不动」，不能拿来判断会不会走。

**一走就全身卸力：先看是不是运行器的保护，而不是模型**
现象：鸭子刚开始迈腿就停，接着所有舵机一起卸力，鸭子塌下去。
原因：运行器有两道保护是按台架小动作定的。一是任一舵机电压低于 6.6 V 就停，走起来电流大，7.4 V 供电在舵机端掉到 6.5 V 就触发；二是停下后原地保持，要核对位置偏差 ≤ 1°，正在动或在 P5 下沉的鸭子做不到，于是走到「全部卸力」。
→ 已改：保持和恢复阶段不再因电压低卸力，保持判定放宽到 5°，回站到位仍按 1°。电源调到约 8.0 V 留余量（HD-1910 上限 8.4 V），第 7 次 10 秒跑完最低 7.6 V。

**增益别一下加太多，电流会把电源拉垮**
现象：P5 时腿跟不上目标（差 6–7°），改 P10 后 0.24 秒内舵机电流读数相加约 26 A，14 颗电压一起掉到 5.4–5.8 V，保护停机。
原因：P 越大，同样的误差下舵机出力越大，十几颗一起使劲，可调电源扛不住。另外训练 BAM 用的就是 P5，加 P 本身也偏离了训练条件。
→ 要加先试 6–8，盯着电压；真要走大动作，用 2S 锂电池这种瞬间能出十几安的电源。

**一起步电压就塌：给动作加软起步**
现象：按训练原样（不缩放、不滤波）跑，0.3 秒内 14 颗舵机电压一起掉到 4.6–5.2 V，保护停机。
原因：第一帧直接跳到模型要的姿势，十几颗舵机同时猛发力，起步那一下电流尖峰最大，可调电源和电源线跟不上。
→ 运行器加了软起步：开头 1 秒动作幅度从 0 线性加到 100%（kissqy 配置默认开，`--ramp` 可改）。加了之后同样参数 10 秒跑完、最低 7.5 V。软起步只管起步；动作做足以后仍可能把可调电源拉垮，长期还是要换电池。

**kissqy 的 0.9 / 0.5 / 0.7 不是训练参数**
现象：他的部署包里有两套数：`deployment-profile.toml` 写缩放 1.0、不滤波；`deployment-execution.json` 写缩放 0.9、头滤波 0.5、腿滤波 0.7。
原因：模型训练时是 1 / 1 / 1；0.9 / 0.5 / 0.7 是他照搬官方鸭子运行程序（给 Dynamixel 调的）的默认值，他的 robotd 优先用后者，还会额外乘电压补偿 7.4/V。
→ 两套都试：运行器默认按他的运行值，加 `--training-mapping` 按训练原样。每个参数的作用见 [2026-10-11 kissqy 上机实测](docs/HD1910-20261011-kissqy-walk上机实测.md#3-运行参数每个是干什么的为什么有两套)。

**装 R17、切调试模式时，舵机会先卸力，鸭子会塌**
现象：2026-10-12 装 R17 时，原本上着力的鸭子突然软了；调试模式（commissioning）的 robotd 每次启动也会把 15 颗舵机全部卸力。
原因：他的设计是「开机卸力」：安装第一步先让旧服务卸力，调试模式启动时也先卸力。运动模式启动不会主动卸力。
→ 装 R17、点「切到标定模式」、重启调试模式之前，先扶住鸭子或者让它躺好。

**IMU 方向确认别手扶软鸭子：先让它站到 HOME 再测**
现象：确认 IMU 安装方向时，要求机身竖直、离竖直不超过 5°。没上力的鸭子腿是软的，手扶着第一次读到 15.2°，过不了。
原因：手扶的姿势本身就歪（这次是往前低头约 13°、往左歪约 8°），而且软鸭子一晃就变。
→ 先让鸭子上力站到 HOME（servo-web 的「站姿」和官方 HOME 是同一组角度），自己站着时读到 4.95°；再把整只鸭子往前倾 15–30°，看变化方向是不是朝正前方。现在 robotd 的 `verify-imu` 只能在调试模式下用，而调试模式一启动就卸力，所以 2026-10-12 是用 servo-web 读数、按同样的标准手动写入的，详见[当晚记录](docs/HD1910-20261012-kissqy整套上机.md)。
**更正（2026-10-12 夜）**：那次读到的 4.95° 大部分是 IMU 装歪的偏差，不是鸭子本来的姿势。方向对了还要校零点，见下面「IMU 装歪 8.5°」。

**用别的程序上了力再切到 kissqy，HOME 会被拒**
现象：鸭子用 servo-web 站着，切到 R17 运动模式后发 HOME，4 次都报 `ID 20: temporary P/D readback mismatch; torque-on refused`。
原因：他的程序发现舵机已经上着力，就当作是自己之前上的，只核对 P/D 是不是它要的 P5/D20，不会重写。servo-web 上的力用的是 P32/D40，核对当然不通过。
→ 先卸力（`robot.relax`，扶住鸭子），再 HOME（`robot.init`）。它会写入 P5/D20、回读确认、上力，2 秒内转到 HOME。HOME 时机身要在竖直 10° 以内。

**IMU 装歪 8.5°：模型一接管就往后猛冲**
现象：2026-10-12 夜模型接管后，快的 0.6 秒、慢的 21 秒就往后摔，腿目标打满 ±90°～±100°；接管前机身读数越前倾，失控越快。IMU 轴向、陀螺仪、关节速度的正负号都查过，全对。
原因：模型训练时，鸭子站 HOME、脚平踩地，机身是水平的（官方 MJCF 的 `STAND` 关键帧，IMU 读 0°）。我们的 BNO085 模块装歪了约前倾 8.5°、右倾 1.75°：鸭子站直时，IMU 说「前倾 8.5°」，模型就一直往后救。官方训练代码的注释也写了，真机 IMU 的固定俯仰偏差要在运行时校掉，训练不管。
→ 站 HOME，把真机此刻的关节角放进仿真，算出机身「应该」倾多少，和 IMU 读数相减，就是偏差；补进 IMU 安装四元数（M′ = C ⊗ M）。步骤和脚本见 [`tools/radxa/onboard-analysis/`](tools/radxa/onboard-analysis/)。校准后模型接管 70 秒没倒，倾斜平均 0.2°，推摇杆开始交替迈步。完整排查见 [10-12 夜上机记录](docs/HD1910-20261012-夜-IMU校准与首次迈步.md#4-一接管就猛冲怎么一步步找到-imu-偏差)。

**IMU 读数会漂：摔过、碰过 IMU 要复查零点**
现象：同样站 HOME、关节角几乎一样，IMU 前倾读数先是 5.2°，后来是 8.6°。
原因：IMU 模块被碰动了（中间摔了几次，还按过 IMU 的线）；打印件受力弯曲、舵盘松量也会差一两度。
→ 模块固定死（我们和伙伴商量改用螺丝固定，固定好以后重新校一次零点）。摔狠了、碰过 IMU、换过线以后，按上一条复查一次，偏差超过 1°～2° 就重新校准。

**站 HOME 时膝盖会被压弯，身体真的会前倾**
现象：同样按 HOME，有时两个膝盖到位，有时被压弯 5°～9°，机身前倾到 17°，按第二下 Start 被拒。
原因：HOME 用的是训练时的 P5 增益，偏软，膝盖承重又最大；站下去的方式不同，停的位置也不同。
→ 放平地、手拿开，等它站稳再按第二下。别为这个加增益：偏离训练条件，电流还会把电源拉垮（见上面「增益别一下加太多」）。

**移动电源带不动舵机：电流一大就退回 5 V**
现象：每次从瘫着的姿势回 HOME，电压掉到 5 V；站不到位，第二下 Start 被拒、又回一次 HOME，循环。
原因：PD 快充移动电源加诱骗线，过流时协议保护会退回 5 V。舵机在 5 V 下力矩、速度掉三四成；5 V 也低到 HAT 给主板降压的下限，主板可能重启。
→ 用 NP-F550 电池，或可调电源（8.0 V、限流开到最大）。可调电源的线要短、要粗：8 V 时舵机端出力仍掉到约 7.0 V，线上掉 1 V 偏多。

**鞋底 TPU 也分软硬：95A 偏硬；脚底太滑，模型会变成小碎步（仿真里是这样，真机待验证）**
现象：2026-10-12 夜到 10-13，鸭子在桌面上推摇杆，两腿交替迈步，但步子碎、往前走得不多；用户觉得放到鼠标垫上好一点（手感，没数据）。
原因：kissqy 提醒过脚底要 TPU，可我们的鞋底本来就是 TPU，是 **95A**，偏硬。kissqy 说他的 90A 用两天就变硬、开始打滑，又换了 85A。这个模型训练时，脚底摩擦只在 0.7～1.3 之间随机，没见过更滑的地面；仿真里只改摩擦，0.5 几乎没影响，0.3 就变成 4.5 Hz 碎步、几乎全是高频颤、脚只抬 7 mm，0.2 走不动。但 D 改成 0 以后，真机在同一张桌面上就不颤了，仿真解释不了这一点，所以「太滑」只是一个没排除的嫌疑。真机的摩擦我们还没测。
→ 换软鞋底很便宜，值得试：85A TPU，或者 PLA 脚板贴 1～2 mm 硅胶 / 橡胶防滑片（两只脚一样厚、贴平贴满、脚尖倒角、别超出脚板；机械行者Robo 装配视频第 1 集的零件清单里，脚掌组件就有「脚板 / 防滑垫」）；别用厚海绵、EVA。测摩擦用斜板：摩擦系数 = tan（开始滑的角度），35° ≈ 0.7 是训练的下限；整只鸭子站上去会先翻倒，要用同材料的矮样块。最省事的验证：同样参数、同一张桌面，换鞋底前后各走一组，比颤和离地。详见 [10-14 白天记录 §6](docs/HD1910-20261014-白天-仿真找原因与新版放开参数.md#6-脚底摩擦和鞋底)。

**拿仿真跟真机比之前，先把条件对齐：动作缩放、滤波、重量、速度**
现象：2026-10-14 上午拿仿真跟真机比，仿真的撑地膝盖能伸直、脚抬 12 mm，真机伸不直、只抬 5 mm，于是去怀疑舵机参数、重量、脚底。
原因：仿真跟真机的条件不一样，上午没对齐。真机旧卡上，联合模型实际的动作缩放约 0.83（0.9 × 电压补偿 7.4 / 电压），腿滤波 0.7、头 0.5，仿真里是 1.0、不滤波；kissqy 训练用的模型是 820 g（模型包 `deployment-contract.json` 里各部件质量合计），我们仿真用的官方模型是 737 g。对齐以后（重量按 kissqy 训练模型的 820 g 估），仿真的撑地膝盖从 +3.5° / +6.5° 变成 −3.4° / −3.5°，跟真机的 −4.5° / −2.6° 接近了，光动作缩放 0.83 这一项就占了大头。
→ 仿真对照前，把真机实际在用的值列出来逐项对上：动作缩放（看 `robot.busStatus` → `loaded_models.walk.runtime_execution_profile`，再乘电压补偿）、头腿滤波、整鸭重量（称）、P / D / 转矩、舵机电压、摇杆速度（推满）。对齐以后仿真还会出现真机没有的高频颤，原因没查，所以仿真的数字只当方向看。详见 [10-14 白天记录 §1、§2](docs/HD1910-20261014-白天-仿真找原因与新版放开参数.md#1-仿真怎么做的跟真机差在哪)。

**联合模型的缩放和滤波不在 `robotd.toml` 里，改 toml 没用**
现象：2026-10-13 在 `robotd.toml` 改 `action_scale`（1.0、0.8）和头腿滤波做了几组对比，结论后来全部作废。
原因：kissqy 的联合模型（`scale_use = joint_uniform`）用模型包里自己的 `deployment-execution.json`（R17 装的版本是缩放 0.9、头 0.5、腿 0.7；V164 里同一个模型写的是缩放 1.0），robotd 再乘电压补偿（约 7.4/电压）；toml 里那几个值只对其他模型生效。
→ 改之前先确认参数在哪生效：看 `robot.busStatus` → `loaded_models.walk.runtime_execution_profile`，那是 robotd 实际在用的值。要改联合模型就改它包里的 `deployment-execution.json`，卸力后重启 robotd。

**蹭地先算清楚是哪只脚、哪个部位低，别急着校零位或左右腿分开调**
现象：2026-10-14 鸭子走路蹭地，左脚尤其明显。一开始以为是机身往左歪、IMU 不准、或者零位不准，想把左右腿分开调。
原因：按 IMU 把机身转正后算离地间隙（`tools/gait-analysis/foot_clear.py`），**两只脚都只抬了仿真的一半**（3～6 mm 对 11～12 mm）：撑地时模型要膝盖伸直，真机一直弯着（舵机参数是同款 1910 的，差在 P、转矩限制、重量这些条件上，还在分）。左脚显得更蹭，是因为迈步时它的脚尖朝下（右脚和仿真都是脚跟最低），而右腿撑地时机身多往前栽 1.5°；这两点都是 D 改成 0 以后才有的。IMU 横滚补过；关节零位在前后方向左右一致，左右方向两只脚算出来差约 1.6°～2.6°，还没查。
→ 先用脚本把「哪只脚、脚尖还是脚跟、哪个关节、机身怎么动」算清楚，再动参数。跟 D 有关的先换一组 D 试；舵机读数看不到的（脚没踩平、机械松动），用侧面慢动作和手摸去查。注意 IMU 零点偏 1° 会让计算里两只脚差约 2 mm，先校 IMU 再比左右。详见 [10-13 夜上机记录 §7](docs/HD1910-20261013-夜-掉电-舵机D与蹭地.md#7-蹭地两只脚都只抬了仿真的一半)。
**补充（10-14 白天）**：仿真对齐真机的动作缩放（约 0.83）、头腿滤波和 kissqy 的训练重量（820 g）以后，撑地膝盖已经接近真机，仿真里看「膝盖伸不直」大部分能用这几个条件解释（见上面「拿仿真跟真机比之前，先把条件对齐」）；仿真里缩放从 0.83 提到 1.0 能多抬约 3 mm，真机上联合缩放改成 1.0、乘上电压补偿只加 11%（仿真是加 20%），按线性估效果大约只有仿真的一半，仍值得试。左右方向两只脚不共面也查了：两个髋横滚往外劈，每次不一样，像是被体重压的（推测；见「舵机 / 校准」）。详见 [10-14 白天记录](docs/HD1910-20261014-白天-仿真找原因与新版放开参数.md)。

## 工具

**STM32G0 空片第一次烧录后程序不跑，停在 ST 自带的 Bootloader**
现象：CubeProgrammer 烧录、读回校验全过，复位后程序却没动静：RAM 里还是上电随机值，停一下 CPU 看 PC = `0x1FFF…`（系统存储区的 Bootloader，寄存器 R6/R7 是 USART1/I²C1，正在扫接口等人刷机）。原因：G0 上电时检查 Flash 第一个字是不是空的，结果存在 `FLASH_ACR.EMPTY`，**只在上电（选项字节加载）时更新**；空片上电 EMPTY=1，烧完之后的软件复位不重新检查，芯片还以为是空的。
→ **空片第一次烧完，断电重启一次**。按复位键（NRST）也不重新检查，没用。以后再烧（Flash 不空）就没这个问题（2026-09-22，imu_to_dxl 首板）。

**ST-LINK/V2 的 20 针口不是每家都一样，GND 只认 12/18/20 脚**
ST 官方定义里 4/6/8/10 脚也是 GND，但有些版本（比如带 UART/SWIM 的那种）4/6/8/10/14 脚在调试器那头是 UART-RX、UART-TX、BOOT0、SWIM、SWIM-RST。按官方表把 GND 接到 4 脚，等于把目标板地接到了调试器的串口上。另外 **1 脚 TVCC 只测电压、不供电**；有的版本 **19 脚 VDD 会往外出 3.3 V**。
→ SWD 只接四根：**1 TVCC、7 SWDIO、9 SWCLK、20 GND**；板子自己从总线供电时 19 脚别接，两路电别并。接上以后 ST-Link 反复掉线（设备管理器里「设备描述符请求失败」）多半是接线把它的电拉垮了：先单独插 ST-Link 确认它好，再接板子。

**Keil 太老编不了 CMSIS 6 的工程：`cmsis_clang.h` 找不到**
MDK 5.24 带的是 Arm Compiler 6.7；CMSIS 6 的 `cmsis_compiler.h` 要求 `__ARMCC_VERSION >= 6100100`（6.10.1），版本不够就当成普通 clang，去找一个根本没有的 `cmsis_clang.h`。
→ 装 MDK 5.4x（5.41 带 6.22；没许可证是 32 KB 限制的 Lite 版，这个固件 10 KB 够用）。器件包 `Keil.STM32G0xx_DFP` 老版本 Keil 里也要自己装。

**URT-2 先给舵机上电、后插 USB，总线就通不了**
现象：15 颗全不应答，只有广播 ping 能收到几个全 0 的字节；万用表量总线 S–G 空闲只有 2.1 V（正常 4.5 V 上下）；不插 USB 时板子 5 V 排针上莫名有 2.1 V。板子拔掉舵机空载 S–G 又是好的 4.5 V。原因是板子逻辑电只来自 USB，舵机那边先把总线拉到 5 V、板子还没电，电流从 S 脚倒灌进板子的 5 V 轨，等 USB 再插上时电平转换那部分已经卡在一个半死状态，把总线压在 2.1 V。
→ **顺序：先插 USB，再给舵机上电**。已经反了就把两边都断开重来。别急着怀疑 S/G 插反或板子坏了（2026-09-17 在这上面耗了一小时）。

**VS Code 的 Markdown Editor 扩展不显示 HTML 图片**
README 用 `<table><img>` 拼的两栏卡片，那个扩展不解析裸 HTML 里的相对路径，图全空。GitHub 上是好的。
→ 用 VS Code 自带预览（`Ctrl+Shift+V`）。

**Windows 上 `core.autocrlf=true` 会毁掉二进制文件**
PDF 头部多为 ASCII，git 自动探测误判成文本，checkout 时做 LF→CRLF 转换，文件直接损坏。
→ `.gitattributes` 里把 `*.pdf *.stl *.step *.png` 等全部声明 `binary`。

**Windows 上用 Python 改文本，换行会悄悄变成 CRLF**
现象：2026-10-12 在 Windows 上用 Python 的 `Path.write_text` 给 kissqy 分支的 `voice-setup.py` 改了 3 行注释，提交后 `git diff --stat` 显示整个文件 150 多行全变了。
原因：`write_text` 在 Windows 上默认把 `\n` 写成 `\r\n`；那个仓库的 `.gitattributes` 是 `-text`，git 不做换行转换，CRLF 原样进了提交。开 `core.autocrlf=true` 的仓库提交时会转回 LF，看不出来，但工作区文件已经变了。
→ 用 Python 改文件时写 `open(p, 'w', newline='')`，或者按字节读写；提交前看一眼 `git diff --stat` 的行数跟实际改的对不对得上，`file 文件名` 能看出是不是 CRLF。那次已经用提交 `d1dcfa6` 改回 LF。
