yoyojacky/microduck-replica/tools/radxa/联网与HAT调试记录-20260928.md

# 2026-09-28：DHCP 修复与 HAT 舵机只读实测

本记录的日期以调试电脑为准；主板系统时间尚未确认同步，不使用其日志时间推断实际日期。

## 联网结论

此前 9 月 20 日镜像配置了 `wpa_supplicant` 无线认证，但默认 netplan 仅匹配有线接口，没有给 `wlan0` 配置 DHCP。修复为新增 `/etc/systemd/network/25-wlan0.network`：

```ini
[Match]
Name=wlan0

[Network]
DHCP=ipv4
```

在本机个人镜像上实测：

- 成功通过 WiFi SSH 登录，主机名为 `radxa-zero3`。
- 系统为 Armbian 26.2.1 Trixie，内核 `6.1.115-vendor-rk35xx`。
- `networkctl status wlan0` 显示 `Network File: /etc/systemd/network/25-wlan0.network`，状态 `routable (configured)` / `online`，取得 DHCPv4 地址和默认路由。
- `systemd-networkd` 和 `wpa_supplicant@wlan0` 为 active；NetworkManager 未启用；`systemctl --failed` 无失败服务。
- 首次检查时启动约 6 分钟，CPU 温度约 56℃。内核日志仍有显示/GPU、以太网及启动阶段 SD 调谐等告警，不能把“能 SSH”当作全部硬件均无问题。

这证明本次修复在当前主板及无线环境中生效。未做多次冷启动和其他路由器兼容测试，不能宣称所有联网问题都已解决。公开 Release 的旧 `.img.xz` 和校验值没有替换，用户仍需按[使用说明](镜像使用说明.md#4-连-wifi)补配置。

## HAT 串口测试

主板 `/dev/ttyS2` 存在，无进程占用；`serial-getty@ttyS2` 和 `serial-getty@ttyFIQ0` 均被 mask。通过 HAT 以 **1,000,000 baud** 进行测试，只允许协议 `PING` / `READ`，没有发送写寄存器、开启扭矩、校准或运动指令。

首次读取：13 颗舵机成功响应；23 号、34 号没有响应。全 ID 扫描和后续复查表明：

- 关节 ID `10–14`、`20–24`、`30–33` 均有响应，共 14 颗。
- 用户确认嘴部已从 34 改为 29，因此 34 不响应是预期；29 仅识别到固件/型号字段后即停止进一步测试。
- 23 号左膝存在间歇无应答，不能按首次扫描结果认定损坏或未接线。

连续 20 轮对上述 14 颗关节舵机逐个读取反馈寄存器 `56–70`：

| 对象 | 成功 / 次数 | 观察 |
|---|---|---|
| 23 号左膝 | 18 / 20 | 2 次没有收到帧头，成功响应的状态码为 0 |
| 其余 13 颗关节舵机 | 各 20 / 20 | 状态码均为 0，无校验错误或 ID 错误 |

读取期间电压约 7.4–7.5V，温度约 30–33℃。寄存器快照中，14 颗关节舵机扭矩开关均为 0，状态位为 0，运行模式为 4。这里是短时只读通讯检查，不是带载或运动稳定性测试。

## 运动前待处理

1. **23 号的间歇通讯问题。** 先正常关机并断开 HAT 输入后检查该舵机的插头、线缆和供电连接，再复测；必要时与已正常通讯的线缆/接口对照。现有数据不能单独确定是线缆、接触、设备还是总线时序问题。
2. **卸载保护配置。** 读到的 14 颗关节舵机寄存器 19 均为 `4`。按仓库飞特内存表，它仅设置过热保护位，未设置电压、过流和过载卸载位；本次只读取，没有修改。阈值也需结合具体型号核对，不能仅打开开关就视为保护验收通过。
3. **回零姿态与机械范围。** 数值 2048 是否对应每个关节的安全装配零位还需逐关节确认；校准偏移大不能仅凭数值判定装配错误。保护与通讯确认后，再在机体有支撑的条件下做低速、小范围验证。
4. **其他功能。** 本次 Armbian 启动没有出现 `/dev/video*`，摄像头配置/复测仍待处理。本次没有运行策略模型或机器人动作。

## 主板上的 WiFi 调试网页

随后已将 `servo-web` 0.15.2 部署到主板 `/home/duck/servo-web`，启动手动服务 `microduck-servo-web`，浏览器通过 `http://主板IP:8080/` 访问。已验证首页、模型资源、`/api/info` 和 WebSocket 实时数据正常，`fake=false`、串口为 `/dev/ttyS2`。这次启动扫描得到 13 颗；23 号当时没有响应，因此未加入自动轮询，不能把其余 13 颗的正常轮询当成 23 号已恢复。

启动参数管理 `20–24`、`30–33`、`10–14`，按用户要求排除嘴部 29。服务未启用开机自启；此为主板上的单独部署，没有打包进公开基础镜像。操作命令：

```bash
sudo systemctl status microduck-servo-web --no-pager
sudo systemctl stop microduck-servo-web   # 改用其他总线测试工具前先停
sudo systemctl start microduck-servo-web  # 主板重启后需要时手动启动
```

部署前修正了调试台连接串口时自动放开速度/加速度限制的行为；0.15.2 启动只扫描、读相位，不写运动设置。协议模拟器的回归测试和自检均通过。网页仍有实体运动和校准按钮，不是功能受限的只读页面；本次验收仅访问页面及读取状态，没有触发这些按钮。

原始只读寄存器快照和连续读取统计已保存在调试电脑的 `Radxa-Zero3W/调试记录/`。实测结果只覆盖本文列出的设备和操作。

## 后续：头部接入与同步读取修复

随后用户把 HAT DATA 改接 33 号头部舵机，继续排查偶发超时。发现并独立复现同步读按顺序匹配 ID 导致的连带误判，已修复为按实际应答 ID 归档，更新主板调试台至 0.15.3。修复后网页 200 帧内 14 颗均成功读取；原始回包实验仍曾出现 31/33 的偶发缺应答，不能判定物理问题已消失。供电、共地、接口电路和后续单变量测试见[详细排查记录](HAT舵机偶发超时排查-20260928.md)。
