yoyojacky/microduck-replica/tools/servo-web/test_servo_report.py

"""舵机体检（servo_report.py）：对着协议级模拟器跑，确认判据对、而且一个写指令都不发。
Run: python -m pytest -q test_servo_report.py
"""
import contextlib
import io
import json
import os
import tempfile
import unittest

import feetech
import servo_report
from sim_bus import SimSerial

IDS = [20, 21, 22, 23]


class ReportTests(unittest.TestCase):
    def setUp(self):
        self.port = SimSerial([20, 22, 23])            # 21 不在总线上（烧了 / 没接）
        sv = {s.id: s for s in self.port.servos.values()}
        sv[20].r[19] = 1 + 4 + 8 + 32                  # 该开的都开了
        sv[22].r[19] = 4                               # 出厂：只开了过热
        sv[23].r[19] = 1 + 4 + 8
        sv[23].r[65] = 8                               # 正在报过流
        sv[23].off = -300
        for s in sv.values():
            s.r[14], s.r[15] = 84, 40                  # 电压窗口 4.0–8.4 V；模拟器电压 7.4 V
        self.sent = []
        handle = self.port._handle
        self.port._handle = lambda sid, instr, p: (self.sent.append(instr), handle(sid, instr, p))[1]
        self.bus = feetech.FeetechBus(None, ser=self.port)
        self.tmp = tempfile.TemporaryDirectory()
        self.addCleanup(self.tmp.cleanup)

    def run_report(self):
        with contextlib.redirect_stdout(io.StringIO()) as out:
            base, rows = servo_report.run(self.bus, IDS, "SIM", self.tmp.name)
        return base, {r["id"]: r for r in rows}, out.getvalue()

    def test_flags_and_files(self):
        base, rows, out = self.run_report()
        self.assertFalse(rows[21]["online"])
        self.assertIn("PING 不通", rows[21]["red"][0])
        self.assertEqual((rows[20]["red"], rows[20]["yellow"]), ([], []))
        self.assertTrue(any("没开：过流、电压" in x for x in rows[22]["red"]))
        self.assertTrue(any("过载保护" in x for x in rows[22]["yellow"]))
        self.assertTrue(any("状态位 65 = 8：过流" in x for x in rows[23]["red"]))
        self.assertTrue(any("偏移 -300" in x for x in rows[23]["yellow"]))
        md = open(base + ".md", encoding="utf-8").read()
        self.assertIn("在线 3/4 颗；有红项的 3 颗", md)
        raw = json.load(open(base + ".json", encoding="utf-8"))
        self.assertEqual(len(raw["servos"][0]["raw"]), feetech.DUMP_END)

    def test_read_only(self):
        self.run_report()
        writes = {feetech.WRITE, feetech.SYNC_WRITE, feetech.CALIBRATE, feetech.REBOOT}
        self.assertTrue(self.sent)
        self.assertFalse(writes & set(self.sent), f"发了写指令：{set(self.sent) & writes}")


if __name__ == "__main__":
    unittest.main()
